dcellucci/MiniMOJO/README.md

# MiniMOJO

Documentation, hardware, and software related to MiniMOJO, a robot capable of traversing a digital cellular solids lattice.
