dcellucci/MiniMOJO/hw/README

# Hardware Notes

## MOJO Boards Rev 3

That's the one with the battery backpack.

### TeuxDeux

 1. Add solder jumper to disconnect power for I2C cable
 2. Move backpack switch to somewhere reachable
 	2a. backpack switch should turn IC on/off, IC should turn motors on/off
 3. Move servo connector up

### Notes

Pinout for ATSAM

    6 Pin | 10 Pin SAM 

    1 > 2
    2 > 1
    3 > 4
    4 > DNC 
    5 > 0
    6 > 5
