dcellucci/MiniMOJO/hw/PCB/EAGLE/MiniMojo_Control_Boards/TPS61089RNRR_4.8V/Eagle/2016-09-01_11-38-00/readme.txt

**********************************************************
*************  Important Instructions Follow  ************
**********************************************************

All files exported to: Z:\\38\\87\\3887045\\20\Eagle\2016-09-01_11-38-00\2016-09-01_11-38-00.xml

**********************************************************
*****************Schematic Instructions  *******************
**********************************************************

To import your new Schematic file into Eagle:

1. Unzip the downloaded folder files to local directory and Start Eagle.
2. Select "File"->"Open"->"Schematic..." from the menu at the top of
the screen.
3. Browse to your newly exported file and select the ".sch" file extension.
4. You should now see your schamtic available in Eagle.

**********************************************************
*******************  PCB Instructions  *******************
**********************************************************

To import your new BOARD file into Eagle:

1. Unzip the downloaded folder files to local directory and Start Eagle.
2. Select "File"->"Open"->"Board..." from the menu at the top of
the screen.
3. Browse to your newly exported file and select the ".brd" file extension.
4. Planes will need to be repoured to update the polygon fills
	1. Once your board is loaded and before the repour, the default design rule
	   should be updated for Mask and thermal relief.
		a. Goto Edit and select Design Rules.
			-Select Masks Tab; Set Stop (Min & Max) to 0.0mm
			-Select Supply Tab; Set Thermal Isolation to 0.0mm
	2. To pour the polygon fills, goto Tools and select Ratsnest
	3. The polygons should all be filled now.
5. You should now have an image of your board available in Eagle.

**********************************************************
*******************  LIB Instructions  *******************
**********************************************************

To import your new library into Eagle:

1. Start Eagle.
2. Select "File"->"New"->"Library" from the menu.
3. In the blank library window, select "File" -> "Execute Script"
from the menu.
5. Browse to your newly exported Eagle Script file (".scr" file extension)
6. After opening the file, the script will populate the new library.
Layer 93 should NOT exist.
7. Use "File"->"Save" (or "Save As..") to save the library to the desired
location in Eagle native format.

For additional information, please visit this site:
http://www.accelerated-designs.com/help/Eagle_import.html

You may also find this video helpful:
http://youtu.be/5jGuWY-Yy3Q

**********************************************************
**********************************************************
**********************************************************

Component "GRM155R61A104KA01D" renamed to "GRM155R61A104KA01D"
Component "CL21C122JBFNNWE" renamed to "CL21C122JBFNNWE"
Component "CL21C620JBANNNC" renamed to "CL21C620JBANNNC"
Component "GRM155R60J104KA01D" renamed to "GRM155R60J104KA01D"
Component "WB_CURRENT_LOAD" renamed to "WB_CURRENT_LOAD"
Component "GRM188R61A225KE34D" renamed to "GRM188R61A225KE34D"
Component "WB_GND" renamed to "WB_GND"
Component "IHLP2020CZERR82M01" renamed to "IHLP2020CZERR82M01"
Component "CRCW040222K6FKED" renamed to "CRCW040222K6FKED"
Component "RC0603FR-0782KL" renamed to "RC0603FR-0782KL"
Component "CRCW0402243KFKED" renamed to "CRCW0402243KFKED"
Component "ERJ-8ENF1433V" renamed to "ERJ-8ENF1433V"
Component "ERJ-8ENF5233V" renamed to "ERJ-8ENF5233V"
Component "TPS61089RNRR" renamed to "TPS61089RNRR"
Component "WB_BATTERY" renamed to "WB_BATTERY"
Component "GRM31CR61A476KE15L" renamed to "GRM31CR61A476KE15L"
The Symbol WB_CONTINUATION was missing a RefDes attribute, a refdes was created for the symbol.
The Symbol WB_CONTINUATION was missing a Type attribute, a type was created for the symbol.
The Symbol WB_CONTINUATION was missing a Value attribute, a value was created for the symbol.
The Symbol WB_CURRENT_PROBE was missing a RefDes attribute, a refdes was created for the symbol.
The Symbol WB_CURRENT_PROBE was missing a Type attribute, a type was created for the symbol.
The Symbol WB_CURRENT_PROBE was missing a Value attribute, a value was created for the symbol.
The Symbol WB_PWL_CURRENT_LOAD was missing a RefDes attribute, a refdes was created for the symbol.
The Symbol WB_PWL_CURRENT_LOAD was missing a Type attribute, a type was created for the symbol.
The Symbol WB_PWL_CURRENT_LOAD was missing a Value attribute, a value was created for the symbol.
The Symbol WB_BLOCK_IO was missing a RefDes attribute, a refdes was created for the symbol.
The Symbol WB_BLOCK_IO was missing a Type attribute, a type was created for the symbol.
The Symbol WB_BLOCK_IO was missing a Value attribute, a value was created for the symbol.
The Symbol WB_CAP_OUTPUT was missing a RefDes attribute, a refdes was created for the symbol.
The Symbol WB_CAP_OUTPUT was missing a Type attribute, a type was created for the symbol.
The Symbol WB_CAP_OUTPUT was missing a Value attribute, a value was created for the symbol.
The Symbol WB_PWL_VOLTAGE_SOURCE was missing a RefDes attribute, a refdes was created for the symbol.
The Symbol WB_PWL_VOLTAGE_SOURCE was missing a Type attribute, a type was created for the symbol.
The Symbol WB_PWL_VOLTAGE_SOURCE was missing a Value attribute, a value was created for the symbol.
The Symbol WB_SOURCE_RESISTOR was missing a RefDes attribute, a refdes was created for the symbol.
The Symbol WB_SOURCE_RESISTOR was missing a Type attribute, a type was created for the symbol.
The Symbol WB_SOURCE_RESISTOR was missing a Value attribute, a value was created for the symbol.
The Symbol WB_PRIM_PWL_VOLTAGE_SOURCE was missing a RefDes attribute, a refdes was created for the symbol.
The Symbol WB_PRIM_PWL_VOLTAGE_SOURCE was missing a Type attribute, a type was created for the symbol.
The Symbol WB_PRIM_PWL_VOLTAGE_SOURCE was missing a Value attribute, a value was created for the symbol.
The Symbol WB_PRIMITIVE_BATTERY was missing a RefDes attribute, a refdes was created for the symbol.
The Symbol WB_PRIMITIVE_BATTERY was missing a Type attribute, a type was created for the symbol.
The Symbol WB_PRIMITIVE_BATTERY was missing a Value attribute, a value was created for the symbol.
The Symbol WB_TPS61089RNR was missing a RefDes attribute, a refdes was created for the symbol.
The Symbol WB_TPS61089RNR was missing a Type attribute, a type was created for the symbol.
The Symbol WB_TPS61089RNR was missing a Value attribute, a value was created for the symbol.
The Symbol WB_VOLTAGE_PROBE was missing a RefDes attribute, a refdes was created for the symbol.
The Symbol WB_VOLTAGE_PROBE was missing a Type attribute, a type was created for the symbol.
The Symbol WB_VOLTAGE_PROBE was missing a Value attribute, a value was created for the symbol.
The Symbol WB_CINX_TPS61088 was missing a RefDes attribute, a refdes was created for the symbol.
The Symbol WB_CINX_TPS61088 was missing a Type attribute, a type was created for the symbol.
The Symbol WB_CINX_TPS61088 was missing a Value attribute, a value was created for the symbol.
The Symbol WB_CAP_POLARIZED was missing a RefDes attribute, a refdes was created for the symbol.
The Symbol WB_CAP_POLARIZED was missing a Type attribute, a type was created for the symbol.
The Symbol WB_CAP_POLARIZED was missing a Value attribute, a value was created for the symbol.
The Symbol WB_COUTX_BLOCK was missing a RefDes attribute, a refdes was created for the symbol.
The Symbol WB_COUTX_BLOCK was missing a Type attribute, a type was created for the symbol.
The Symbol WB_COUTX_BLOCK was missing a Value attribute, a value was created for the symbol.
The Symbol WB_PRIM_STARTUP_VOLTAGE_SOURCE was missing a RefDes attribute, a refdes was created for the symbol.
The Symbol WB_PRIM_STARTUP_VOLTAGE_SOURCE was missing a Type attribute, a type was created for the symbol.
The Symbol WB_PRIM_STARTUP_VOLTAGE_SOURCE was missing a Value attribute, a value was created for the symbol.
The Symbol WB_STARTUP_VOLTAGE_SOURCE was missing a RefDes attribute, a refdes was created for the symbol.
The Symbol WB_STARTUP_VOLTAGE_SOURCE was missing a Type attribute, a type was created for the symbol.
The Symbol WB_STARTUP_VOLTAGE_SOURCE was missing a Value attribute, a value was created for the symbol.
The Symbol WB_PRIM_SIN_VOLTAGE_SOURCE was missing a RefDes attribute, a refdes was created for the symbol.
The Symbol WB_PRIM_SIN_VOLTAGE_SOURCE was missing a Type attribute, a type was created for the symbol.
The Symbol WB_PRIM_SIN_VOLTAGE_SOURCE was missing a Value attribute, a value was created for the symbol.
The Symbol WB_LOAD_RESISTOR was missing a RefDes attribute, a refdes was created for the symbol.
The Symbol WB_LOAD_RESISTOR was missing a Type attribute, a type was created for the symbol.
The Symbol WB_LOAD_RESISTOR was missing a Value attribute, a value was created for the symbol.

Ultra Librarian Gold 8.1.44 Process Report

Message - Padstack "RX22Y24D0T" Shape(4) is a CIRCLE with no diameter.
Message - Padstack "RX44Y57D0T" Shape(4) is a CIRCLE with no diameter.
Message - Padstack "RX44Y71D0T" Shape(4) is a CIRCLE with no diameter.
Message - Padstack "RX26Y38D0T" Shape(4) is a CIRCLE with no diameter.
Message - Padstack "RX78Y110D0T" Shape(4) is a CIRCLE with no diameter.
Message - Padstack "R10220100000200A" Shape(4) is a CIRCLE with no diameter.
Message - Padstack "R10430180000221A" Shape(4) is a CIRCLE with no diameter.
Message - Padstack "R10430430002121A" Shape(4) is a CIRCLE with no diameter.
Message - Component "GRM155R61A104KA01D" attribute "Cap" references text style "" that is not in the database.
The default pattern text style "H50s3" was substituted.
Message - Component "GRM155R61A104KA01D" attribute "ESR" references text style "" that is not in the database.
The default pattern text style "H50s3" was substituted.
Message - Component "GRM155R61A104KA01D" attribute "IRMS" references text style "" that is not in the database.
The default pattern text style "H50s3" was substituted.
Message - Component "GRM155R61A104KA01D" attribute "VDC" references text style "" that is not in the database.
The default pattern text style "H50s3" was substituted.
Message - Component "CL21C122JBFNNWE" attribute "Datasheet URL" references text style "" that is not in the database.
The default pattern text style "H50s3" was substituted.
Message - Component "CL21C122JBFNNWE" attribute "Cap" references text style "" that is not in the database.
The default pattern text style "H50s3" was substituted.
Message - Component "CL21C122JBFNNWE" attribute "ESR" references text style "" that is not in the database.
The default pattern text style "H50s3" was substituted.
Message - Component "CL21C122JBFNNWE" attribute "IRMS" references text style "" that is not in the database.
The default pattern text style "H50s3" was substituted.
Message - Component "CL21C122JBFNNWE" attribute "VDC" references text style "" that is not in the database.
The default pattern text style "H50s3" was substituted.
Message - Component "CL21C620JBANNNC" attribute "Datasheet URL" references text style "" that is not in the database.
The default pattern text style "H50s3" was substituted.
Message - Component "CL21C620JBANNNC" attribute "Cap" references text style "" that is not in the database.
The default pattern text style "H50s3" was substituted.
Message - Component "CL21C620JBANNNC" attribute "ESR" references text style "" that is not in the database.
The default pattern text style "H50s3" was substituted.
Message - Component "CL21C620JBANNNC" attribute "IRMS" references text style "" that is not in the database.
The default pattern text style "H50s3" was substituted.
Message - Component "CL21C620JBANNNC" attribute "VDC" references text style "" that is not in the database.
The default pattern text style "H50s3" was substituted.
Message - Component "GRM155R60J104KA01D" attribute "Cap" references text style "" that is not in the database.
The default pattern text style "H50s3" was substituted.
Message - Component "GRM155R60J104KA01D" attribute "ESR" references text style "" that is not in the database.
The default pattern text style "H50s3" was substituted.
Message - Component "GRM155R60J104KA01D" attribute "IRMS" references text style "" that is not in the database.
The default pattern text style "H50s3" was substituted.
Message - Component "GRM155R60J104KA01D" attribute "VDC" references text style "" that is not in the database.
The default pattern text style "H50s3" was substituted.
Message - Component "GRM188R61A225KE34D" attribute "Cap" references text style "" that is not in the database.
The default pattern text style "H50s3" was substituted.
Message - Component "GRM188R61A225KE34D" attribute "ESR" references text style "" that is not in the database.
The default pattern text style "H50s3" was substituted.
Message - Component "GRM188R61A225KE34D" attribute "IRMS" references text style "" that is not in the database.
The default pattern text style "H50s3" was substituted.
Message - Component "GRM188R61A225KE34D" attribute "VDC" references text style "" that is not in the database.
The default pattern text style "H50s3" was substituted.
Message - Component "IHLP2020CZERR82M01" attribute "Datasheet URL" references text style "" that is not in the database.
The default pattern text style "H50s3" was substituted.
Message - Component "IHLP2020CZERR82M01" attribute "L" references text style "" that is not in the database.
The default pattern text style "H50s3" was substituted.
Message - Component "IHLP2020CZERR82M01" attribute "DCR" references text style "" that is not in the database.
The default pattern text style "H50s3" was substituted.
Message - Component "IHLP2020CZERR82M01" attribute "IDC" references text style "" that is not in the database.
The default pattern text style "H50s3" was substituted.
Message - Component "CRCW040222K6FKED" attribute "Resistance" references text style "" that is not in the database.
The default pattern text style "H50s3" was substituted.
Message - Component "CRCW040222K6FKED" attribute "Power" references text style "" that is not in the database.
The default pattern text style "H50s3" was substituted.
Message - Component "CRCW040222K6FKED" attribute "Tolerance" references text style "" that is not in the database.
The default pattern text style "H50s3" was substituted.
Message - Component "RC0603FR-0782KL" attribute "Resistance" references text style "" that is not in the database.
The default pattern text style "H50s3" was substituted.
Message - Component "RC0603FR-0782KL" attribute "Power" references text style "" that is not in the database.
The default pattern text style "H50s3" was substituted.
Message - Component "RC0603FR-0782KL" attribute "Tolerance" references text style "" that is not in the database.
The default pattern text style "H50s3" was substituted.
Message - Component "CRCW0402243KFKED" attribute "Resistance" references text style "" that is not in the database.
The default pattern text style "H50s3" was substituted.
Message - Component "CRCW0402243KFKED" attribute "Power" references text style "" that is not in the database.
The default pattern text style "H50s3" was substituted.
Message - Component "CRCW0402243KFKED" attribute "Tolerance" references text style "" that is not in the database.
The default pattern text style "H50s3" was substituted.
Message - Component "ERJ-8ENF1433V" attribute "Resistance" references text style "" that is not in the database.
The default pattern text style "H50s3" was substituted.
Message - Component "ERJ-8ENF1433V" attribute "Power" references text style "" that is not in the database.
The default pattern text style "H50s3" was substituted.
Message - Component "ERJ-8ENF1433V" attribute "Tolerance" references text style "" that is not in the database.
The default pattern text style "H50s3" was substituted.
Message - Component "ERJ-8ENF5233V" attribute "Resistance" references text style "" that is not in the database.
The default pattern text style "H50s3" was substituted.
Message - Component "ERJ-8ENF5233V" attribute "Power" references text style "" that is not in the database.
The default pattern text style "H50s3" was substituted.
Message - Component "ERJ-8ENF5233V" attribute "Tolerance" references text style "" that is not in the database.
The default pattern text style "H50s3" was substituted.
Message - Component "GRM31CR61A476KE15L" attribute "Cap" references text style "" that is not in the database.
The default pattern text style "H50s3" was substituted.
Message - Component "GRM31CR61A476KE15L" attribute "ESR" references text style "" that is not in the database.
The default pattern text style "H50s3" was substituted.
Message - Component "GRM31CR61A476KE15L" attribute "IRMS" references text style "" that is not in the database.
The default pattern text style "H50s3" was substituted.
Message - Component "GRM31CR61A476KE15L" attribute "VDC" references text style "" that is not in the database.
The default pattern text style "H50s3" was substituted.

TextStyle count:  24
Padstack count:   8
Pattern count:    7
Symbol count:     25
Component count:  16

Export

Footprint "WB_CURRENT_LOAD" has no layer data mapped and will be skipped.
Component "WB_CURRENT_LOAD" requires footprint "WB_CURRENT_LOAD" and will be skipped.
Footprint "WB_GND" has no layer data mapped and will be skipped.
Component "WB_GND" requires footprint "WB_GND" and will be skipped.
Footprint "WB_BATTERY" has no layer data mapped and will be skipped.
Component "WB_BATTERY" requires footprint "WB_BATTERY" and will be skipped.
