dcellucci/MiniMOJO/hw/PCB/EAGLE/Prototyping/Tiny841/20160903_MODELA/tiny841_breakout_cutout.png

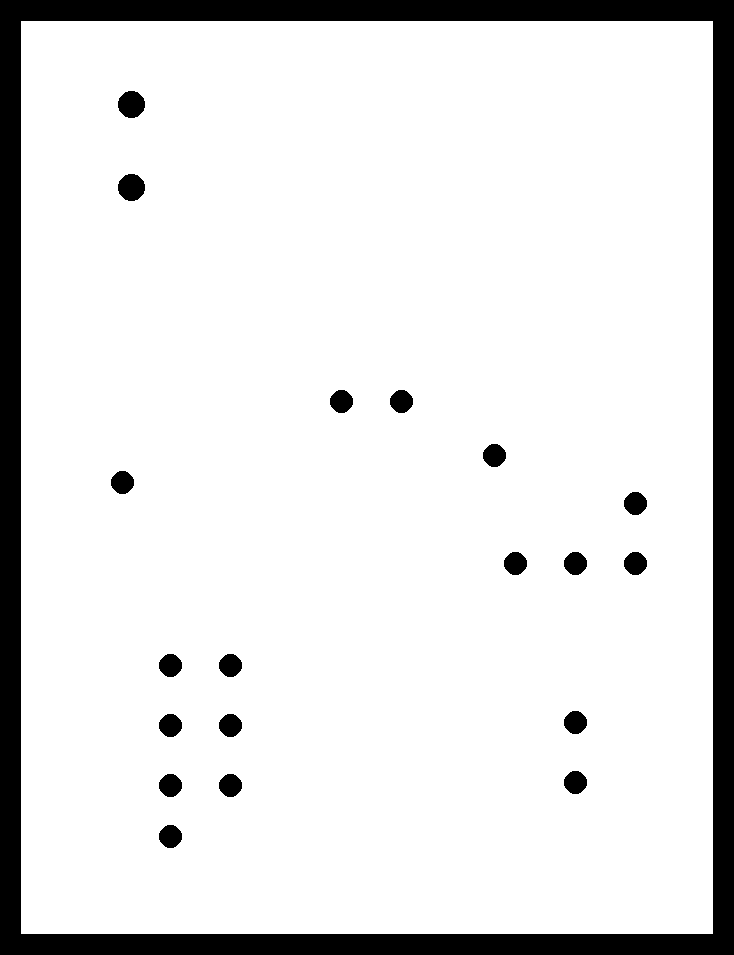
hw/PCB/EAGLE/Prototyping/Tiny841/20160903_MODELA/tiny841_breakout_cutout.png
