dcellucci/MiniMOJO/hw/PCB/EAGLE/Prototyping/Tiny841/20160903_MODELA/Tiny841_Breakout_fab.png

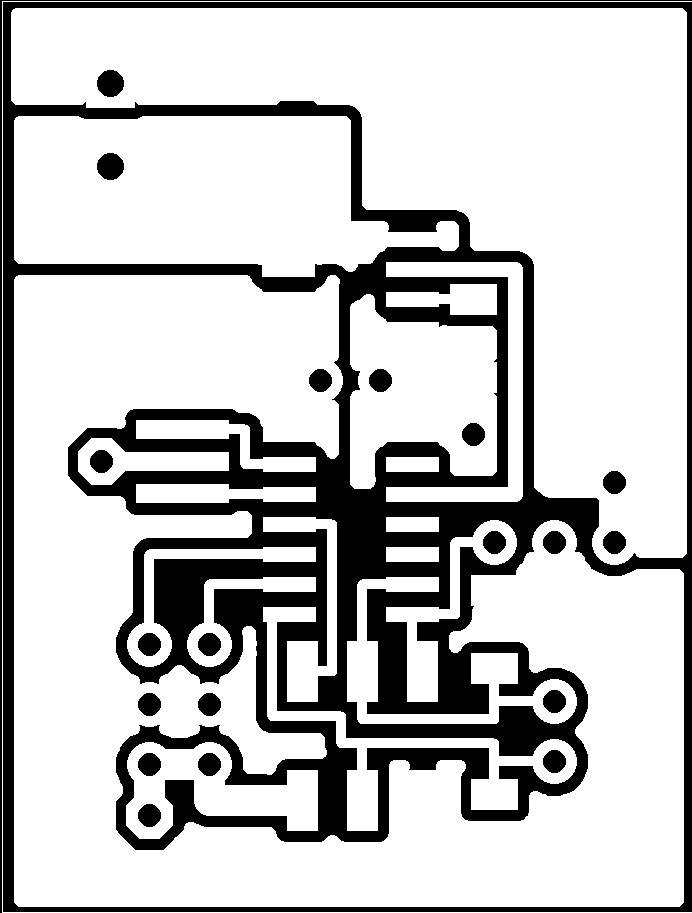
hw/PCB/EAGLE/Prototyping/Tiny841/20160903_MODELA/Tiny841_Breakout_fab.png
