dcellucci/MiniMOJO/hw/PCB/EAGLE/Prototyping/Tiny841/20160903_MODELA/tiny841_breakout_traces.png

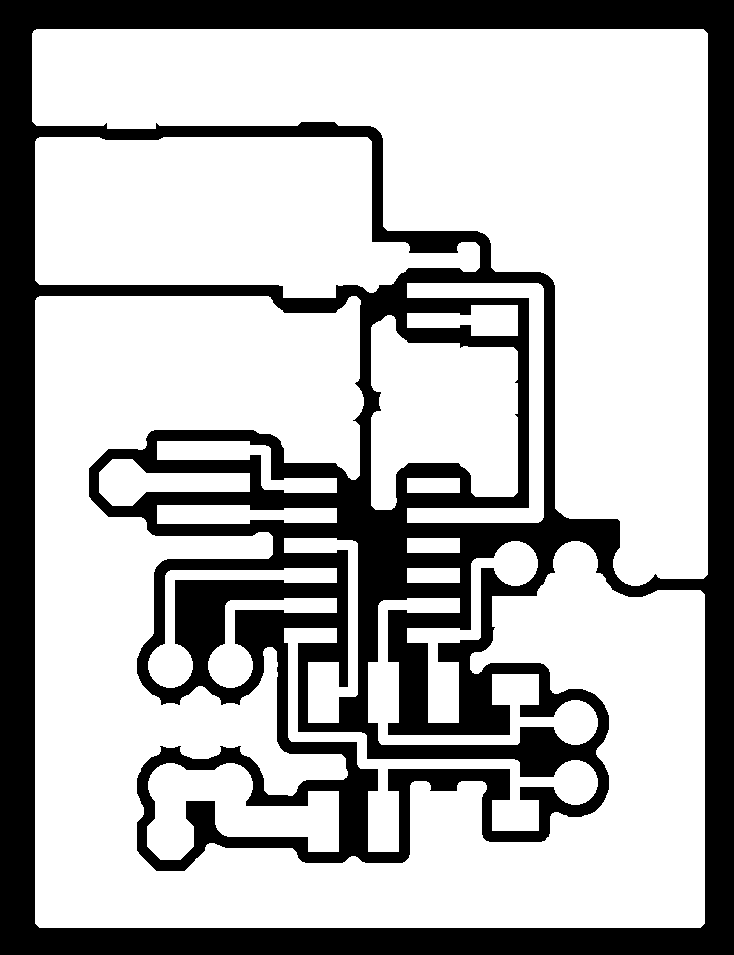
hw/PCB/EAGLE/Prototyping/Tiny841/20160903_MODELA/tiny841_breakout_traces.png
