dcellucci/MiniMOJO/hw/PCB/KICAD/D11D_Programmer_Adapter/CAM/D11D_Adapter_Base_cutout.png

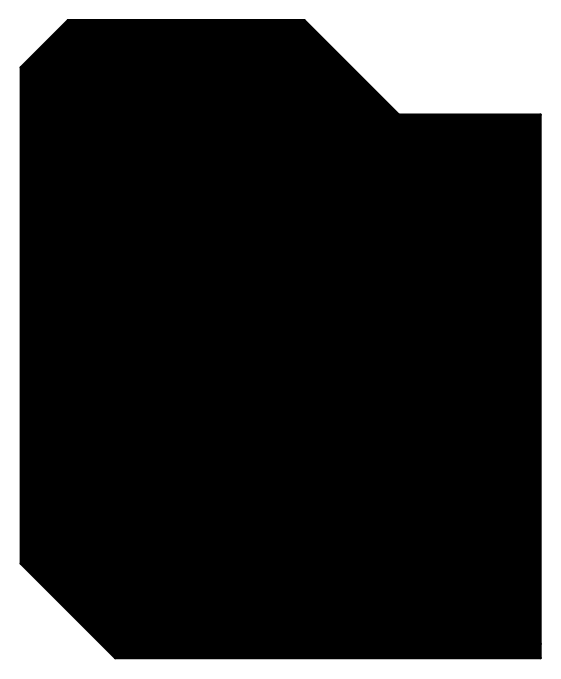
hw/PCB/KICAD/D11D_Programmer_Adapter/CAM/D11D_Adapter_Base_cutout.png
