dcellucci/MiniMOJO/hw/PCB/KICAD/R21_Core_2/R21_Core_BOM.xlsx

Reference Designator | Quantity | Description/Value | Manufacturer Part Number (MPN)
A1 | 1 | 2.4GHz Bluetooth, WLAN, Zigbee™ Chip RF Antenna 2.4GHz ~ 2.483GHz 2.2dBi Solder Surface Mount | W3008C
AR1 | 1 | RES ARRAY 8 RES 10K OHM 1206 | EXB-D10C103J
B1 | 1 | Balun AT86RF232 AT86RF233 ATMEGA256 | 2450BM15A0015E
C1,C2 | 2 | 9pF 50V Ceramic Capacitor C0G, NP0 0402 | GRM1555C1H9R0BA01D
C3,C42 | 2 | 1µF 6.3V Ceramic Capacitor X7R 0402 | GRM155R70J105KA12D
C4,C43 | 2 | 2.2µF 6.3V Ceramic Capacitor X5R 0402 | GRM155R60J225ME15D
C5,C6 | 2 | 22pF 50V Ceramic Capacitor C0G, NP0 0402 | C1005C0G1H220F050BA
C8,C11,C12,C13,C14,C15,C16,C20,C24,C25,C29,C30,C33,C37,C38 | 15 | 0.10µF 16V Ceramic Capacitor X7R 0402 | GRM155R71C104KA88J
C9 | 1 | CAP CER 1200PF 50V NP0 0805 | CL21C122JBFNNWE
C10,C17 | 2 | CAP CER 10UF 10V X5R 0402 | CL05A106MP5NUNC
C18 | 1 | CAP CER 62PF 50V NP0 0805 | CL21C620JBANNNC
C19,C22 | 2 | CAP CER 47UF 10V X5R 1206 | GRT31CR61A476KE13L
C21 | 1 | CAP CER 2.2UF 10V X5R 0603 | GRM188R61A225KE34D
C23 | 1 | CAP CER 10000PF 50V X7R 0402 | GRM155R71H103KA88D
C26,C27,C40 | 3 | 4 Position FFC, FPC Connector Contacts, Top and Bottom 0.020" (0.50mm) Surface Mount, Right Angle | 5034800400
C28,C41 | 2 | CONN FFC FPC 10POS 0.50MM R/A | 5034801000
C31 | 1 | 9 Positions Header, Shrouded Connector 0.039" (1.00mm) Surface Mount, Right Angle Tin | SM09B-SRSS-TB(LF)(SN)
C32,C39 | 2 | CAP CER 4.7UF 10V X5R 0402 | CL05A475KP5NRNC
C34,C35 | 2 | 22pF 50V Ceramic Capacitor C0G, NP0 0402 | C1005C0G1H220F050BA
D1,D3 | 2 | Amber 615nm LED Indication - Discrete 2V 0603 | LA L296-Q2R2-1-Z
D2,D5 | 2 | Blue 470nm LED Indication - Discrete 3.3V 0603 | LTST-C191TBKT
F1,F2 | 2 | FUSE PTC RESET 200MA SMD 0603 | MF-FSMF020X-2
L1 | 1 | 220 Ohm Impedance Ferrite Bead 0603 (1608 Metric) Surface Mount 2A 1 Lines 50 mOhm Max DCR | BLM18EG221SN1D
L2 | 1 | 1.2 uH Power inductor | 74438356012
Q1 | 1 | MOSFET N-CH 60V 0.31A SOT323 | 2N7002PW,115
R1,R2,R3,R9,R12,R18 | 6 | RES SMD 330 OHM 1% 1/16W 0402 | RC0402FR-07330RL
R4 | 1 | RES SMD 143K OHM 1% 1/4W 1206 | ERJ-8ENF1433V
R5 | 1 | RES SMD 22.6K OHM 1% 1/16W 0402 | CRCW040222K6FKED
R6 | 1 | RES SMD 243K OHM 1% 1/16W 0402 | CRCW0402243KFKED
R7 | 1 | RES SMD 82K OHM 1% 1/10W 0603 | RC0603FR-0782KL
R8,R11,R17,R21,R22,R23 | 6 | RES SMD 10K OHM 1% 1/16W 0402 | CRCW040210K0FKED
R10 | 1 | RES SMD 523K OHM 1% 1/4W 1206 | ERJ-8ENF5233V
R13 | 1 | RES SMD 78.7K OHM 1% 1/10W 0402 | ERJ-2RKF7872X
R14,R15,R16 | 3 | RES SMD 0.25 OHM 1% 1/2W 1206 | CSR1206FKR250
R19 | 1 | RES SMD 10 OHM 1% 1/16W 0402 | RC0402FR-0710RL
R20 | 1 | RES SMD 0.01 OHM 1% 1W 1206 | CRF1206-FZ-R010ELF
S2 | 1 | SWITCH TACTILE SPST-NO 0.02A 15V | TL3700AF160QG
SW1 | 1 | Slide Switch SPDT Surface Mount, Right Angle | AYZ0102AGRLC
T1 | 1 | IC REG BOOST ADJ 7A SYNC 11VQFN | TPS61089RNRR
J1 | 1 | 5x2 Header JTAG 0.05" | 20021121-00010C4LF
U1 | 1 | ATSAMR21E18A IC RF TXRX+MCU ISM>1GHZ 32-VFQFN | ATSAMR21E18A-MFT
U2,U11 | 2 | IC REG LDO 3.3V 0.6A SOT25 | AP2112K-3.3TRG1
U3 | 1 | IMU ACCEL/GYRO/MAG I2C/SPI 24LGA | LSM9DS1TR
U4 | 1 | IC DISTRIBUTION SWITCH 10VSON | TPS2559QWDRCTQ1
U5 | 1 | IC CURRENT SHUNT MONITOR 16VQFN | INA3221AQRGVRQ1
U6 | 1 | IC MCU 32BIT 16KB FLASH 24QFN | ATSAMD11D14A-MNT
U7 | 1 | CONN PLUG 20POS 3MM STACK HGHT | 20P3.0-JMCS-G-TF(N)
U8 | 1 | CONN RCPT 20POS GOLD W/BOSS | 20R-JMCS-G-B-TF(S)
U9 | 1 | IC BATTERY MONITOR 14TDFN | MAX17201G+
U10 | 1 | USB - micro B USB 2.0 Receptacle Connector 5 Position Surface Mount, Right Angle, Horizontal | 10104110-0001LF
X1 | 1 | CRYSTAL 16.0000MHZ 10PF SMD | ABM8-16.000MHZ-10-1-U-T
X2 | 1 | CRYSTAL 32.7680KHZ 12.5PF SMT | FC-135R 32.7680KF-A3
 | 93
