dcellucci/MiniMOJO/hw/PCB/EAGLE/MiniMojo_Control_Boards/ATSAMR18_core/20160731_MM2_BOM.xls

Sample Bill of Materials (BOM) - Screaming Circuits Buys Materials
> All the information Screaming Circuits needs in a Bill of Materials to complete an order is in columns B through G.
> Distributor part numbers (ie.. DigiKey Part #'s) are not required for Kitted orders, but are helpful for Turn-Key pricing.
> The BOM is the primary file that Screaming Circuits goes by whenever there is any conflicting information.
> There is information in the far right column that helps to get an assembly quote. Look at the bottom to see a board summary.
> Highlight in RED any Do Not Stuff parts ("DNS") , and they will be excluded from the build. Parts not listed on the BOM are considered DNS.
Item # | Qty | Ref Des | Manufacturer | Mfg Part # | Dist. Part # | Description | Package | Type
1 | 2 | C1, C2 | Murata | GRM1555C1H9R0BA01D | 490-6257-1-ND | 9pF 50V Ceramic Capacitor C0G, NP0 0402 | 402 | smt
2 | 1 | C3 | Murata | GRM155R70J105KA12D | 490-10024-1-ND | 1µF 6.3V Ceramic Capacitor X7R 0402 | 402 | smt
3 | 1 | C4 | Murata | GRM155R60J225ME15D | 490-4519-1-ND | 2.2µF 6.3V Ceramic Capacitor X5R 0402 | 402 | smt
4 | 2 | C5,C6 | TDK | C1005C0G1H220F050BA | 445-5360-1-ND | 22pF 50V Ceramic Capacitor C0G, NP0 0402 | 402 | smt
5 | 11 | C8,C9,C11,C12,C13,C14,C15,C16,C23,C25,C31 | Murata | GRM155R71C104KA88J | 490-6328-1-ND | 0.10µF 16V Ceramic Capacitor X7R 0402 | 402 | smt
6 | 2 | C10,C17 | TDK | C1005X5R0J106M050BC | 445-8920-1-ND | 10µF 6.3V Ceramic Capacitor X5R 0402 | 402 | smt
7 | 2 | C18,C26 | Murata | GRM31CR61A226KE19L | 490-6510-1-ND | 22µF 10V Ceramic Capacitor X5R 1206 | 1206 | smt
8 | 2 | C19,C27 | Murata | GRM155R60J222KA01D | 490-11413-1-ND | 2200pF 6.3V Ceramic Capacitor X5R 0402 | 402 | smt
9 | 2 | C20,C28 | Kemet | C0402C122J5GACTU | 399-7334-1-ND | 1200pF 50V Ceramic Capacitor C0G, NP0 0402 | 402 | smt
10 | 2 | C21,C29 | Murata | GRM155R61A683KA01D | 490-1317-1-ND | 0.068µF 10V Ceramic Capacitor X5R 0402 | 402 | smt
11 | 2 | C22,C30 | Murata | GRM31CR60J107ME39L | 490-4539-1-ND | 100µF 6.3V Ceramic Capacitor X5R 1206 | 402 | smt
12 | 2 | C24,C32 | Murata | GRM155R71H102KA01D | 490-1303-1-ND | CAP CER 1000PF 50V X7R 0402 | 402 | smt
13 | 1 | D5 | Lite-On | LTST-C191TBKT | 160-1647-1-ND | Blue 470nm LED Indication - Discrete 3.3V 0603 | 603 | smt
14 | 1 | D1 | Osram | LA L296-Q2R2-1-Z | 475-2712-1-ND | Amber 615nm LED Indication - Discrete 2V 0603 | 603 | smt
15 | 2 | D2,D3 | Diodes inc | 1N4448W-7-F | 1N4448W-FDICT-ND | DIODE GEN PURP 75V 250MA SOD123 | SOD-123 | smt
16 | 1 | F1 | Bourns | MF-FSMF020X-2 | MF-FSMF020X-2CT-ND | FUSE PTC RESET 200MA SMD 0603 | 603 | smt
17 | 1 | Q1 | NXP | 2N7002PW,115 | 568-5987-1-ND | MOSFET N-CH 60V 0.31A SOT323 | sot323 | smt
18 | 1 | R1 | Panasonic | ERJ-2RKF75R0X | P75.0LCT-ND | RES SMD 75 OHM 1% 1/10W 0402 | 402 | smt
19 | 5 | R2, R6, R9, R13, R16 | Vishay-Dale | CRCW040210K0FKED | 541-10.0KLCT-ND | RES SMD 10K OHM 1% 1/16W 0402 | 402 | smt
20 | 1 | R3 | Yageo | RC0402FR-07330RL | 311-330LRCT-ND | RES SMD 330 OHM 1% 1/16W 0402 | 402 | smt
21 | 2 | R4,R10 | Vishay-Dale | CRCW040260K4FKED | 541-60.4KLCT-ND | RES SMD 60.4K OHM 1% 1/16W 0402 | 402 | smt
22 | 2 | R5,R11 | Vishay-Dale | CRCW04021K69FKED | 541-1.69KLCT-ND | RES SMD 1.69K OHM 1% 1/16W 0402 | 402 | smt
23 | 2 | R7,R14 | Vishay-Dale | CRCW040230K9FKED | 541-30.9KLCT-ND | RES SMD 30.9K OHM 1% 1/16W 0402 | 402 | smt
24 | 2 | R8,R15 | Vishay-Dale | CRCW04022K00FKED | 541-2.00KLCT-ND | RES SMD 2K OHM 1% 1/16W 0402 | 402 | smt
25 | 1 | R12 | Vishay-Dale | CRCW040210R0FKED | 541-10.0LCT-ND | RES SMD 10 OHM 1% 1/16W 0402 | 402 | smt
26 | 1 | S2 | C&K Components | KMR231NG LFS | CKN10246CT-ND | Tactile Switch SPST-NO Top Actuated Surface Mount | 4.2x2.8mm | smt
27 | 1 | U1 | Atmel | ATSAMR21E18A-MFT | ATSAMR21E18A-MFTCT-ND | IC RF TxRx + MCU General ISM > 1GHZ 2.4GHz 32-VFQFN Exposed Pad | 32-VFQFN | smt
28 | 1 | U2 | Johanson | 2450BM15A0015E | 712-1576-1-ND | AT86RF232 AT86RF233 ATMEGA256 | 805 | smt
29 | 1 | U3 | Pulse | W3008C | 553-1674-1-ND | 2.4GHz Bluetooth, WLAN, Zigbee™ Chip RF Antenna 2.4GHz ~ 2.483GHz 2.2dBi Solder Surface Mount | - | smt
30 | 1 | U4 | Epson | TSX-3225 16.0000MF09Z-AC0 | SER4069CT-ND | 16MHz ±10ppm Crystal 9pF 60 Ohm -20°C ~ 75°C | 4-smd | smt
31 | 2 | U6,U11 | TI | TPS55330RTER | 296-39425-1-ND | IC REG MULT CONFG ISO ADJ 16WQFN | 16WQFN | smt
32 | 2 | U7,U12 | Bourns | SRP4020-2R2M | SRP4020-2R2MCT-ND | FIXED IND 2.2UH 3.9A 40 MOHM SMD | - | smt
33 | 2 | U8,U13 | Diodes inc | B340A-13-F | B340A-FDICT-ND | DIODE SCHOTTKY 40V 3A SMA | DO-214AC | smt
34 | 2 | U9,U14 | Allegro | ACS712ELCTR-05B-T | 620-1189-1-ND | SENSOR CURRENT HALL 5A AC/DC | 8-soic | smt
 |  |  |  |  |  | BOARD SUMMARY FOR QUOTE
 |  |  |  |  |  | Unique Part Count | 34
 |  |  |  |  |  | Total Placements | 66
 |  |  |  |  |  | Thru Hole Placements | 0
 |  |  |  |  |  | Has BGA Placements? | No
