dcellucci/MiniMOJO/hw/PCB/EAGLE/MiniMojo_Control_Boards/ATMEGA328_core/20160811_MM2_plates_BOM2.xlsx

Reference Designator | Quantity | Description/Value | Manufacturer Part Number (MPN)
C5, C6, C8 | 3 | 0.1 uF 0402 Cap | 490-1318-1-ND
C7 | 1 | 1 nF 0402 Cap | GRM155R61A102KA01D
C13 | 1 | 1 pF 0402 Cap | GJM1555C1H1R0BB01D
C12 | 1 | 1.5 pF 0402 Cap | GJM1555C1H1R5BB01D
C10 | 1 | 2.2 nF Cap | 04025C222KAT2A
C11 | 1 | 4.7 pF 0402 cap | GRM1555C1H4R7CA01D
C2 | 1 | 10 nF 0402 Cap | GRM155R71H103KA88D
C1, C3, C4 | 3 | 10 uF 0402 cap | CL05A106MP5NUNC
C14 | 1 |  | GRM155R71H332KA01D
Y2 | 1 | 16 MHz crystal | ABM3B-16.000MHZ-10-1-U-T
C15, C16 | 2 | 18 pF 0402 caps | GRM1555C1H180FA01D
D1 | 1 | RED LED | HSMC-C280
D5 | 1 |  | VAOL-S4SB4
L1 | 1 | Inductor 8.2 nH | L-07C8N2JV6T
L3 | 1 | IND 2.7 nH | LQP15MN2N7W02D
L2 | 1 | IND 3.9 nH | LQP15MN3N9W02D
R1, R2 | 2 |  | CRCW040210K0FKED
R12 | 1 |  | RC0402FR-07330RL
R3 | 1 |  | RC0402FR-071ML
R10 | 1 |  | RC0402JR-0722KL
S2 | 1 |  | KMR231NG LFS
IC1 | 1 | nordic | NRF24L01P-R7
U3 | 1 | 328 | ATMEGA328-MMH
U5 | 1 | 5v reg | MIC5205-5.0YM5-TR
U4 | 1 | 3.3v reg | MIC5205-3.3YM5-TR
Y1 | 1 |  | CSTCE16M0V53C-R0
A1 | 1 |  | ANT-2.45-CHP-T
