dcellucci/MiniMOJO/hw/PCB/EAGLE/MiniMojo_Control_Boards/ATSAMR18_core/ATSAMR18_core_Rev2/TA_bom.xlsx

Reference Designator | Quantity | Description/Value | Manufacturer Part Number (MPN)
C1,C2 | 2 | 9pF 50V Ceramic Capacitor C0G, NP0 0402 | GRM1555C1H9R0BA01D
C3 | 1 | 1µF 6.3V Ceramic Capacitor X7R 0402 | GRM155R70J105KA12D
C4 | 1 | 2.2µF 6.3V Ceramic Capacitor X5R 0402 | GRM155R60J225ME15D
C5,C6 | 2 | 22pF 50V Ceramic Capacitor C0G, NP0 0402 | C1005C0G1H220F050BA
C8,C10,C11,C12,C13,C14,C15,C16,C17,C23 | 9 | 0.10µF 16V Ceramic Capacitor X7R 0402 | GRM155R71C104KA88J
C9 | 1 | 1.2 nF | CL21C122JBFNNWE
C18 | 1 | 62 pF | CL21C620JBANNNC
C19,C22 | 2 | 47 uF, 1206 | GRM31CR61A476KE15L
C20 | 1 | 100 nF | GRM155R60J104KA01D
C21 | 1 | 2.2 uF | GRM188R61A225KE34D
C25 | 1 | 100 nF | GRM155R61A104KA01D
D1,D2 | 1 | Amber 615nm LED Indication - Discrete 2V 0603 | LA L296-Q2R2-1-Z
D5 | 1 | Blue 470nm LED Indication - Discrete 3.3V 0603 | LTST-C191TBKT
F1 | 1 | FUSE PTC RESET 200MA SMD 0603 | MF-FSMF020X-2
F2,F3,F4 | 3 | PTC Resettable Fuse 6V 500mA Ih Surface Mount 0603 (1608 Metric), Concave | 0603L050SLYR
L1 | 1 | 220 Ohm Impedance Ferrite Bead 0603 (1608 Metric) Surface Mount 2A 1 Lines 50 mOhm Max DCR | BLM18EG221SN1D
L2 | 1 | 1.2 uH Power inductor | 74438356012
Q1 | 1 | MOSFET N-CH 60V 0.31A SOT323 | 2N7002PW,115
Q2,Q3 | 2 | MOSFET N-CH 50V 220MA SOT-23 | BSS138
Q4 | 1 | MOSFET P-CH 16V 4.66A 8-SOIC | PHK04P02T,518
R1, R3, R12,R20 | 3 | RES SMD 330 OHM 1% 1/16W 0402 | RC0402FR-07330RL
R4 | 1 | 143k, 1206 | ERJ-8ENF1433V
R5 | 1 | 22.6k, 0402 | CRCW040222K6FKED
R6 | 1 | 243k, 0402 | CRCW0402243KFKED
R7 | 1 | 82k, 0603 | RC0603FR-0782KL
R2,R8,R9,R11,R13,R14,R16,R17,R19 | 9 | RES SMD 10K OHM 1% 1/16W 0402 | CRCW040210K0FKED
R10 | 1 | 523k, 1206 | ERJ-8ENF5233V
R15 | 1 | RES SMD 0.01 OHM 1% 1/8W 0402 | CSRF0402FT10L0
S1 | 1 | Slide Switch SPDT Surface Mount, Right Angle | AYZ0102AGRLC
S2 | 1 | Tactile Switch SPST-NO Top Actuated Surface Mount | KMR231NG LFS
U1 | 1 | IC REG LDO 3.3V 0.6A SOT25 | AP2112K-3.3TRG1
U2 | 1 | IC RF TxRx + MCU General ISM > 1GHZ 2.4GHz 32-VFQFN Exposed Pad | ATSAMR21E18A-MFT
U5 | 1 | 2.4GHz Bluetooth, WLAN, Zigbee™ Chip RF Antenna 2.4GHz ~ 2.483GHz 2.2dBi Solder Surface Mount | W3008C
U6 | 1 | Balun AT86RF232 AT86RF233 ATMEGA256 | 2450BM15A0015E
U7 | 1 | 16MHz ±10ppm Crystal 9pF 60 Ohm -20°C ~ 75°C | TSX-3225 16.0000MF09Z-AC0
U8 | 1 | Regulator | TPS61089RNRR
U10 | 1 | ATTiny841 | ATTINY841-MUR
U11,U12,U13,U14,U16 | 5 | 4 Position FFC, FPC Connector Contacts, Top and Bottom 0.020" (0.50mm) Surface Mount, Right Angle | 5034800400
U17 | 1 | 9 Positions Header, Shrouded Connector 0.039" (1.00mm) Surface Mount, Right Angle Tin | SM09B-SRSS-TB(LF)(SN)
U18 | 1 | 20 Position Connector Receptacle, Center Strip Contacts Surface Mount Gold | 20R-JMCS-G-B-TF(S)
U19 | 1 | 20 Position Connector Plug, Outer Shroud Contacts Surface Mount Gold | 20P3.0-JMCS-G-TF(N)
U20 | 1 | Current Monitor Regulator High-Side 10mA SOT-23-8 | INA219BIDCNT
Y1 | 1 | 16 MHz crystal | ABM3B-16.000MHZ-10-1-U-T
J1 | 1 | USB - micro B USB 2.0 Receptacle Connector 5 Position Surface Mount, Right Angle, Horizontal | 10104110-0001LF
