dcellucci/MiniMOJO/hw/PCB/EAGLE/MiniMojo_Control_Boards/ATSAMR18_core/20160901_CAM/20160901_CAMFILES/MM_bom_SC.xls

Sample Bill of Materials (BOM) - Screaming Circuits Buys Materials
> All the information Screaming Circuits needs in a Bill of Materials to complete an order is in columns B through G.
> Distributor part numbers (ie.. DigiKey Part #'s) are not required for Kitted orders, but are helpful for Turn-Key pricing.
> The BOM is the primary file that Screaming Circuits goes by whenever there is any conflicting information.
> There is information in the far right column that helps to get an assembly quote. Look at the bottom to see a board summary.
> Highlight in RED any Do Not Stuff parts ("DNS") , and they will be excluded from the build. Parts not listed on the BOM are considered DNS.
Item # | Qty | Ref Des | Manufacturer | Mfg Part # | Dist. Part # | Description | Package | Type
1 | 2 | C1,C2 | Murata | GRM1555C1H9R0BA01D | 490-6257-1-ND | CAP CER 9PF 50V NP0 0402 | 402 | smt
2 | 1 | C3 | Murata | GRM155R70J105KA12D | 490-10024-1-ND | CAP CER 1UF 6.3V X7R 0402 | 402 | smt
3 | 1 | C4 | Murata | GRM155R60J225ME15D | 490-4519-1-ND | CAP CER 2.2UF 6.3V X5R 0402 | 402 | smt
4 | 2 | C5,C6 | TDK | C1005C0G1H220F050BA | 445-5360-1-ND | CAP CER 22PF 50V C0G 0402 | 402 | smt
5 | 11 | C8,C10,C11,C12,C13,C14,C15,C16,C17,C23,C25 | Murata | GRM155R71C104KA88J | 490-6328-1-ND | CAP CER 0.1UF 16V X7R 0402 | 402 | smt
6 | 1 | C9 | Samsung | CL21C122JBFNNWE | 1276-2987-1-ND | CAP CER 1200PF 50V NP0 0805 | 805 | smt
7 | 1 | C18 | Samsung | CL21C620JBANNNC | 1276-1305-1-ND | CAP CER 62PF 50V NP0 0805 | 805 | smt
8 | 2 | C19,C22 | Murata | GRM31CR61A476KE15L | 490-9673-1-ND | CAP CER 47UF 10V X5R 1206 | 1206 | SMT
9 | 1 | C20 | Murata | GRM155R60J104KA01D | 490-6287-1-ND | CAP CER 0.1UF 6.3V X5R 0402 | 402 | smt
10 | 1 | C21 | Murata | GRM188R61A225KE34D | 490-1545-1-ND | CAP CER 2.2UF 10V X5R 0603 | 603 | smt
11 | 1 | C24 | Murata | GRM155R71H102KA01D | 490-1303-1-ND | CAP CER 1000PF 50V X7R 0402 | 402 | smt
14 | 1 | D1 | OSRAM | LA L296-Q2R2-1-Z | 475-2712-1-ND | LED AMBER DIFFUSED 0603 SMD | 603 | smt
15 | 1 | D5 | Lite-On | LTST-C191TBKT | 160-1647-1-ND | LED BLUE CLEAR 0603 SMD | 603 | smt
16 | 1 | F1 | Bourns | MF-FSMF020X-2 | MF-FSMF020X-2CT-ND | FUSE PTC RESET 200MA SMD 0603 | 603 | smt
17 | 1 | L1 | Murata | BLM18EG221SN1D | 490-3992-1-ND | FERRITE BEAD 220 OHM 0603 1LN | 603 | smt
18 | 1 | L2 | Wurth | 74438356012 | 732-8229-1-ND | FIXED IND 1.2UH 5.8A 18 MOHM SMD | 2-smd | smt
19 | 1 | Q1 | NXP | 2N7002PW,115 | 568-5987-1-ND | MOSFET N-CH 60V 0.31A SOT323 | sot-323 | smt
20 | 2 | Q2,Q3 | Fairchild | BSS138 | BSS138CT-ND | MOSFET N-CH 50V 220MA SOT-23 | SOT-23 | smt
21 | 3 | R1, R3, R12 | Yageo | RC0402FR-07330RL | 311-330LRCT-ND | RES SMD 330 OHM 1% 1/16W 0402 | 402 | smt
22 | 1 | R4 | Panasonic | ERJ-8ENF1433V | ERJ-8ENF1433V | RES SMD 143K OHM 1% 1/4W 1206 | 1206 | smt
23 | 1 | R5 | Vishay Dale | CRCW040222K6FKED | 541-22.6KLCT-ND | RES SMD 22.6K OHM 1% 1/16W 0402 | 402 | smt
24 | 1 | R6 | Vishay Dale | CRCW0402243KFKED | 541-243KLCT-ND | RES SMD 243K OHM 1% 1/16W 0402 | 402 | smt
25 | 1 | R7 | Yageo | RC0603FR-0782KL | 311-82.0KHRCT-ND | RES SMD 82K OHM 1% 1/10W 0603 | 603 | smt
26 | 6 | R2,R8,R9,R11,R13,R14 | Vishay Dale | CRCW040210K0FKED | 541-10.0KLCT-ND | RES SMD 10K OHM 1% 1/16W 0402 | 402 | smt
27 | 1 | R10 | Panasonic | ERJ-8ENF5233V | P523KFCT-ND | RES SMD 523K OHM 1% 1/4W 1206 | 1206 | smt
28 | 1 | S2 | C&K | KMR231NG LFS | CKN10246CT-ND | SWITCH TACTILE SPST-NO 0.05A 32V |  | smt
29 | 1 | U1 | Diodes, Inc. | AP2112K-3.3TRG1 | AP2112K-3.3TRG1DICT-ND | IC REG LDO 3.3V 0.6A SOT25 | SOT-23-5 | smt
30 | 1 | U2 | Atmel | ATSAMR21E18A-MFT | ATSAMR21E18A-MFTCT-ND | C RF TXRX+MCU ISM>1GHZ 32-VFQFN | 32-VFQFN | smt
31 | 1 | U5 | Pulse | W3008C | 553-1674-1-ND | ANTENNA WIRELESS EXTERNAL 2.4GHZ |  | smt
32 | 1 | U6 | Johansen | 2450BM15A0015E | 712-1576-1-ND | AT86RF232 AT86RF233 ATMEGA256 | 6 PC pad | smt
33 | 1 | U7 | EPSON | TSX-3225 16.0000MF09Z-AC0 | SER4069CT-ND | CRYSTAL 16.00 MHZ 9PF SMD | 4-SMD | smt
34 | 1 | U8 | TI | TPS61089RNRR | 595-TPS61089RNRR | (MOUSER) Voltage Regulators - Switching Regulators 12.6-V, 7-A Fully-Integrated Synchronous Boost Converters in 2.0-mm x 2.5-mm VQFN Package 11-VQFN-HR -40 to 85 | 11-VQFN-HR | smt
35 | 1 | U10 | Atmel | ATTINY841-MUR | ATTINY841-MURCT-ND | IC MCU 8BIT 8KB FLASH 20QFN | 20-QFN | smt
36 | 1 | Y1 | Murata | ABM3B-16.000MHZ-10-1-U-T | 490-7852-1-ND | 16MHz Ceramic Resonator Built in Capacitor 15pF ±0.15% -40°C ~ 125°C Surface Mount | 3-SMD | smt
 |  |  |  |  |  | BOARD SUMMARY FOR QUOTE
 |  |  |  |  |  | Unique Part Count | 34
 |  |  |  |  |  | Total Placements | 66
 |  |  |  |  |  | Thru Hole Placements | 0
 |  |  |  |  |  | Has BGA Placements? | No
