dcellucci/MiniMOJO/hw/cad/Gloves/INJMOLD_GLOVE.stp

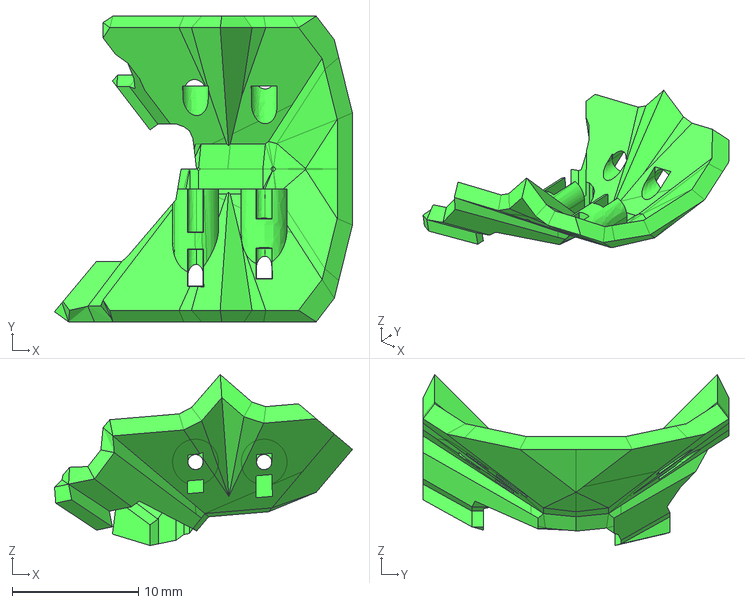
[picture p9: CAD file, 2017-02-16]
hw/cad/Gloves/INJMOLD_GLOVE.stp
23.6 x 24.2 x 13.5 mm
