dcellucci/MiniMOJO/hw/cad/Outer_Arms/Outer_Arms_Bearing.stp

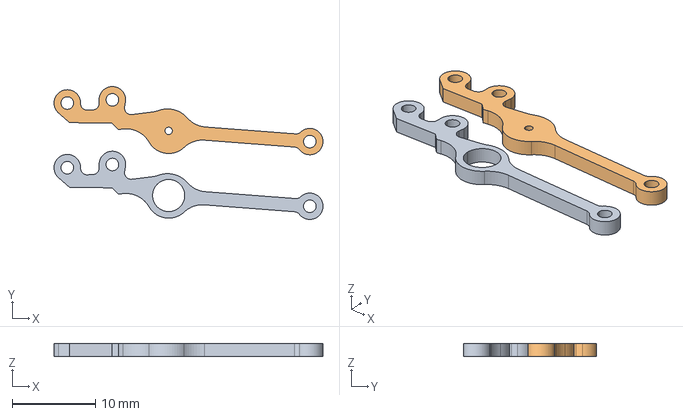
[picture p10: CAD file, 2017-02-16]
hw/cad/Outer_Arms/Outer_Arms_Bearing.stp
32.3 x 16.0 x 1.59 mm
