dcellucci/MiniMOJO/hw/cad/Gear_Patterns/gg_gear_14t_PA20.dxf

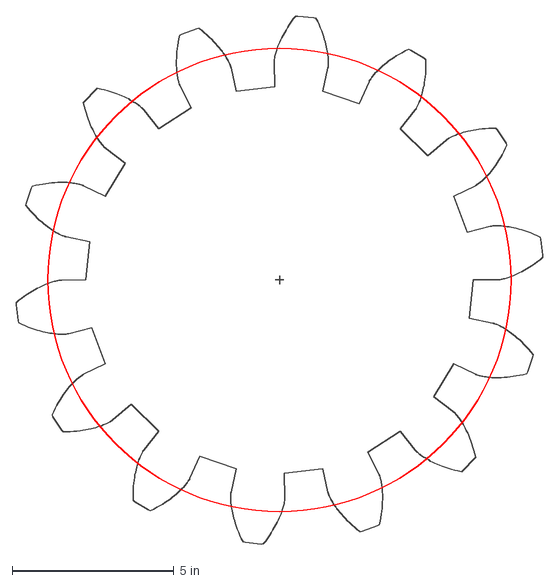
[picture p11: CAD file, 2016-09-23]
hw/cad/Gear_Patterns/gg_gear_14t_PA20.dxf
16.3 x 16.3 in
