dcellucci/MiniMOJO/hw/cad/Gear_Patterns/gg_gear N17 D10.28 P1.65 PA20 @100.dxf

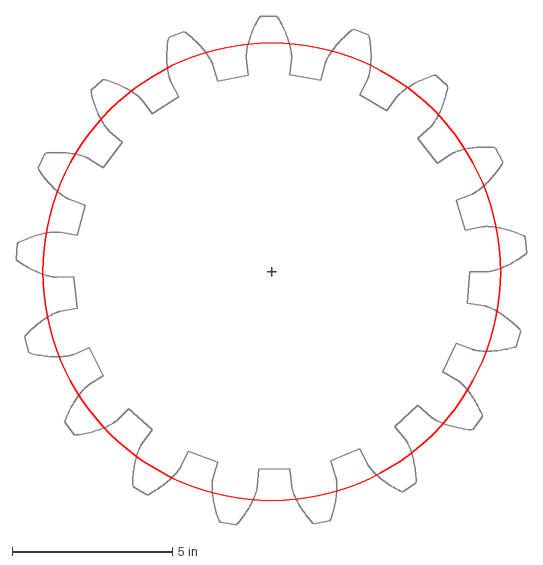
[picture p12: CAD file, 2016-09-23]
hw/cad/Gear_Patterns/gg_gear N17 D10.28 P1.65 PA20 @100.dxf
15.9 x 15.9 in
