dcellucci/MiniMOJO/hw/cad/Board_Stack_Spacer/20170211_Board_Stack_Spacer.stp

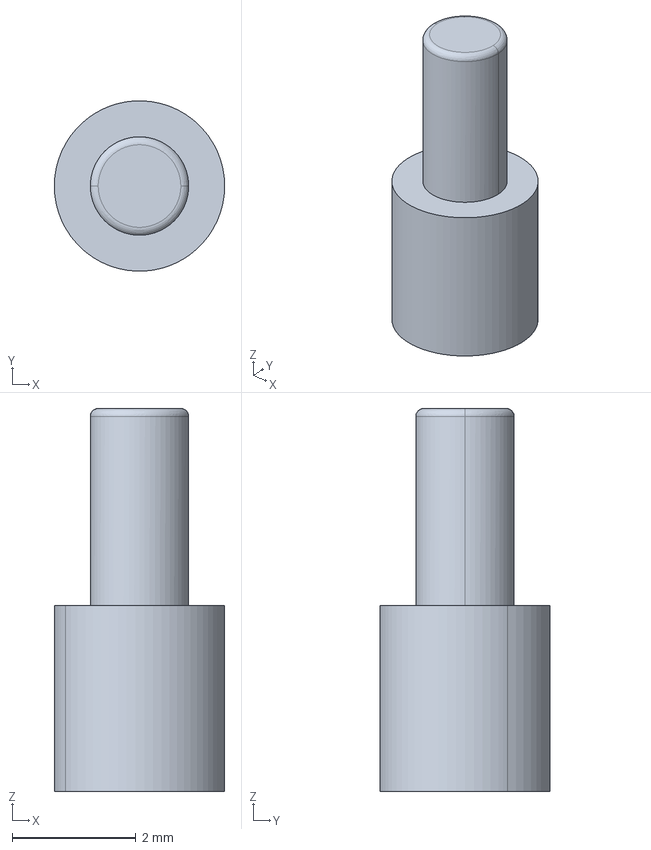
[picture p13: CAD file, 2017-02-11]
hw/cad/Board_Stack_Spacer/20170211_Board_Stack_Spacer.stp
2.75 x 2.75 x 6.18 mm
