dcellucci/MiniMOJO/hw/cad/Gear_Patterns/20160904_newgear_27PA_20T.dxf

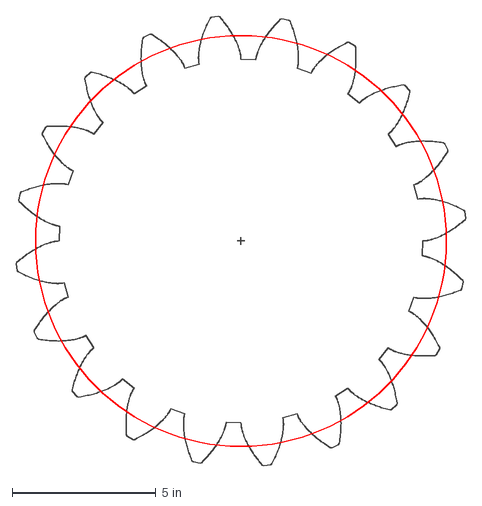
[picture p14: CAD file, 2016-09-23]
hw/cad/Gear_Patterns/20160904_newgear_27PA_20T.dxf
15.6 x 15.6 in
