dcellucci/MiniMOJO/hw/cad/Hex_Spacer/20161017_MM_TopHole_DWC.stp

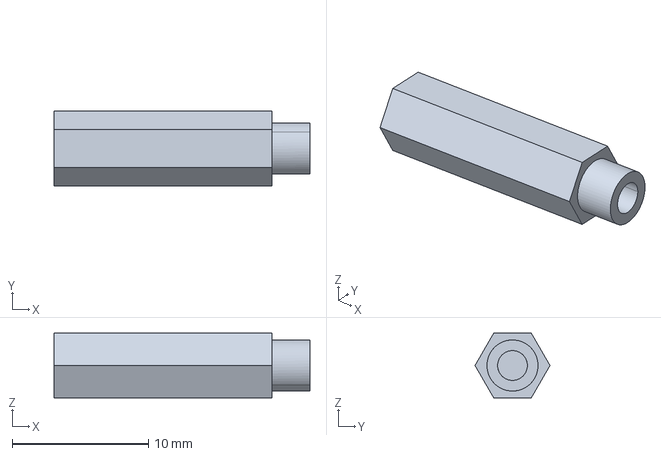
[picture p15: CAD file, 2017-02-11]
hw/cad/Hex_Spacer/20161017_MM_TopHole_DWC.stp
18.8 x 5.50 x 4.76 mm
