dcellucci/MiniMOJO/hw/cad/Plates/20170310_Plates_GearHoles_Final.dxf

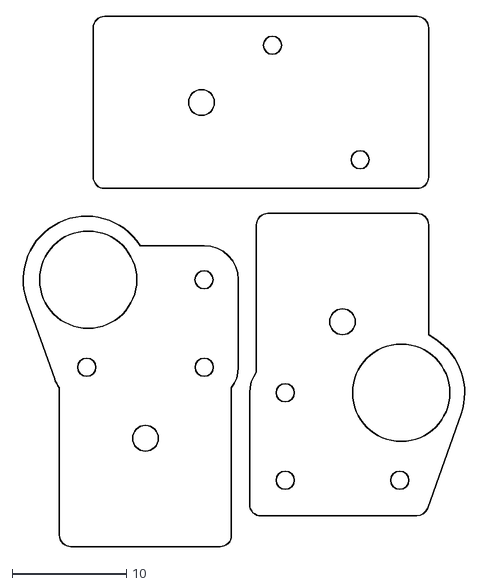
[picture p16: CAD file, 2017-03-20]
hw/cad/Plates/20170310_Plates_GearHoles_Final.dxf
39.8 x 46.4
