dcellucci/MiniMOJO/hw/cad/Spline_Adapter/20160924_MM_Spline_Adapter.dxf

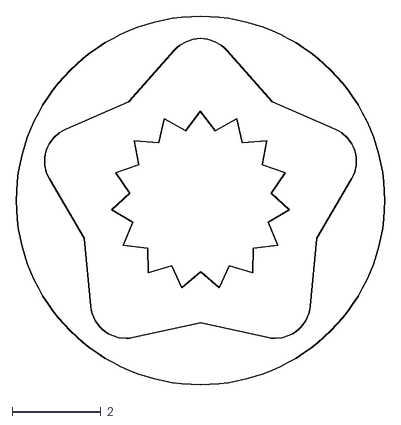
[picture p17: CAD file, 2016-09-24]
hw/cad/Spline_Adapter/20160924_MM_Spline_Adapter.dxf
8.30 x 8.30
