dcellucci/MiniMOJO/hw/cad/Plates/20170304_Plates_Drill_Jig.dxf

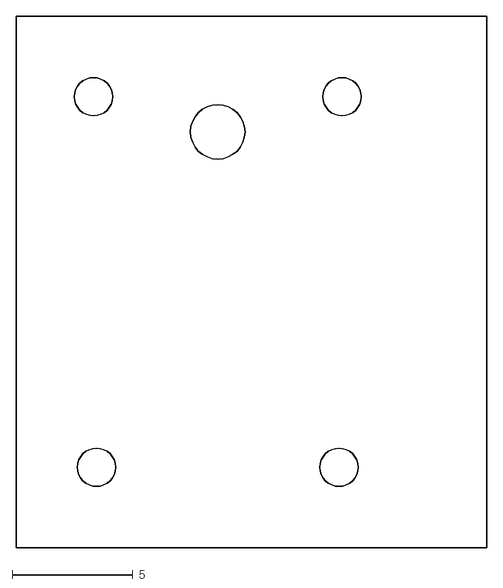
[picture p18: CAD file, 2017-03-06]
hw/cad/Plates/20170304_Plates_Drill_Jig.dxf
19.5 x 22.0
