dcellucci/MiniMOJO/hw/cad/Plates/20170201_Plates_BotHoles_Closer.dxf

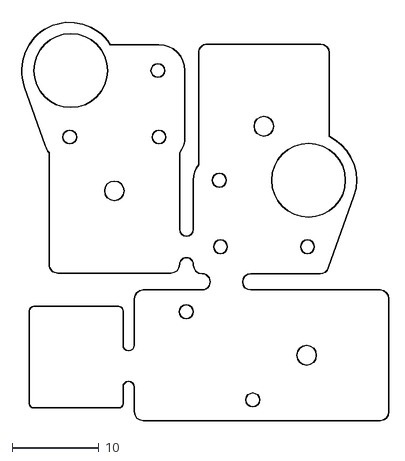
[picture p19: CAD file, 2017-02-09]
hw/cad/Plates/20170201_Plates_BotHoles_Closer.dxf
43.0 x 46.6
