dcellucci/MiniMOJO/tests/20161119_ServoTests/20161120_700g_100P_ColdStartTest_C.csv

No TMP007 sensor found
22.60 | 0.00
22.70 | 0.00
22.60 | 13.38
151.70 | 13.38
34.20 | 13.38
8.60 | 15.50
2.50 | 15.50
2.50 | 17.87
2.50 | 17.87
2.50 | 17.87
2.50 | 19.84
2.50 | 19.84
2.50 | 21.41
2.50 | 21.41
2.50 | 21.41
2.50 | 22.34
2.50 | 22.34
2.50 | 23.31
2.5022.50 | 23.44
22.60 | 23.44
44.20 | 28.03
256.60 | 28.03
374.70 | 28.03
355.40 | 28.00
363.90 | 28.00
358.60 | 28.00
353.10 | 28.00
348.00 | 28.00
346.60 | 27.97
344.00 | 27.97
341.90 | 28.03
341.10 | 28.03
338.10 | 28.03
338.20 | 28.09
336.30 | 28.09
335.40 | 28.19
333.00 | 28.19
332.50 | 28.19
329.50 | 28.22
328.20 | 28.22
326.80 | 28.22
326.50 | 28.22
324.00 | 28.22
324.90 | 28.25
323.70 | 28.25
323.30 | 28.25
322.10 | 28.25
321.80 | 28.25
319.80 | 28.31
318.40 | 28.31
317.50 | 28.31
317.50 | 28.53
315.80 | 28.53
316.90 | 31.87
315.80 | 31.87
315.30 | 31.87
314.20 | 33.94
314.30 | 33.94
312.40 | 34.84
311.90 | 34.84
311.00 | 34.84
311.80 | 34.94
309.60 | 34.94
311.00 | 34.59
310.40 | 34.59
310.20 | 34.59
309.40 | 34.06
309.30 | 34.06
308.20 | 33.38
307.70 | 33.38
307.10 | 33.38
307.60 | 32.63
305.90 | 32.63
307.30 | 31.94
306.70 | 31.94
306.60 | 31.94
305.70 | 31.28
306.10 | 31.28
304.90 | 30.66
304.70 | 30.66
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
