dcellucci/MiniMOJO/media/ServoCalibration.png

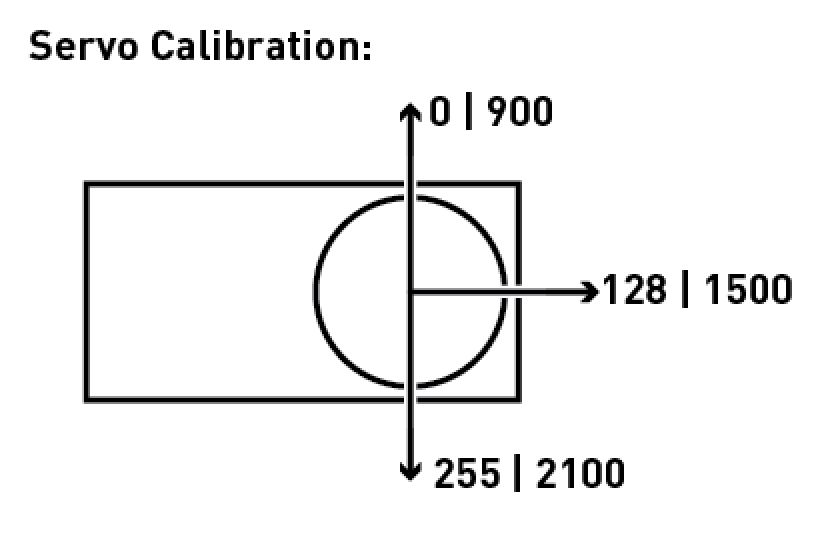
media/ServoCalibration.png
