dcellucci/MiniMOJO/(threads)

Thread 1 (2016-08-30):

Mod Tactile Switch

dcellucci, 2016-08-30:
Replace current switch with

http://www.digikey.com/product-detail/en/e-switch/TL3365AF180QG/EG5384CT-ND/5964420

Closed 2017-02-09.

Thread 4 (2017-02-07):

Fix Outer Arms

dcellucci, 2017-02-07:
Outer arms need to be modded to reduce slop. Suggest adding a bearing or shoulder bolt in order to prevent wobbling.

Closed 2017-03-01.

Thread 5 (2017-02-07):

Motor Calibration Jig

dcellucci, 2017-02-07:
An important step in MOJO assembly is motor calibration, where the zero-point and overall range are set. Right now this calibration is done by hand, but a jig will improve accuracy in this step considerably.
Some things to consider:

 1. Ensuring that the (odd toothed) spline is aligned properly, by using one of the custom fittings. Because there are an odd number of teeth in the spline, a servo horn can be put on backwards, resulting in a miscalibration of 18 degrees. This can be addressed by ensuring that the correct side servo horn is always attached.
 2. Having some kind of external protractor type implement for finding motor angles (see [the ServoCity servo protractor](https://www.servocity.com/servo-protractor)). Note that this protractor only works with the larger 24 tooth spline servos, not the nano size.

Closed 2017-03-01.

Thread 6 (2017-02-07):

Motor Stack Assembly Jig

dcellucci, 2017-02-07:
The current motor stack assembly jig is laser cut delrin and uses flexures for alignment. It can result in significant misalignment of the motors, both positional and angular, as well as consistently producing a slight misalignment in the position of the hex standoff.

Closed 2017-03-01.

Thread 7 (2017-02-09):

ATSAMD11 Core

dcellucci, 2017-02-09:
The new controller for the servos is the ATSAMD11 instead of the ATTiny841. This chip adds critical functionality to the system, at the cost of higher complexity.

## Prototyping
We can prototype boards which use this core with the SRM-20, since the D11 comes in an SOIC package.
 1. Layout and create these boards using [KiCAD](http://kicad-pcb.org) and the [CSL-Part-Library](https://github.com/codedstructureslab/CSL-Part-Library)
 2. Burn [bootloader](https://github.com/mattairtech/ArduinoCore-samd) and familiarize with arduino core (it will be modified for the MiniMOJO version)
 3. Write library that adds a second I2C bus
 4. Verify Servo library functionality on the selected pins

Closed 2017-03-01.

Thread 8 (2017-02-09):

MMv3 Sensor Libraries

dcellucci, 2017-02-09:
The newest version of the MiniMOJO control boards adds several critical sensors.

 1. A [high-side switch](http://www.ti.com/product/TPS2559) that controls the motor supply. As the input for this switch is only a logic signal, the "library" will likely be only a few lines of code.
 2. A [three-channel current sensor](http://www.ti.com/product/INA3221) that provides current consumption information for each servo.
 3. A [battery monitor](https://www.maximintegrated.com/en/products/power/battery-management/MAX17201.html) that provides State of Charge (SoC) feedback.
 4. An [IMU](https://github.com/sparkfun/LSM9DS1_Breakout) that provides heading, orientation, and acceleration information.

Of these, only the IMU has an established library that's already written.
