dcellucci/MiniMOJO/hw/cad/Board_Stack_Spacer/20170211_Board_Stack_Spacer.PDF

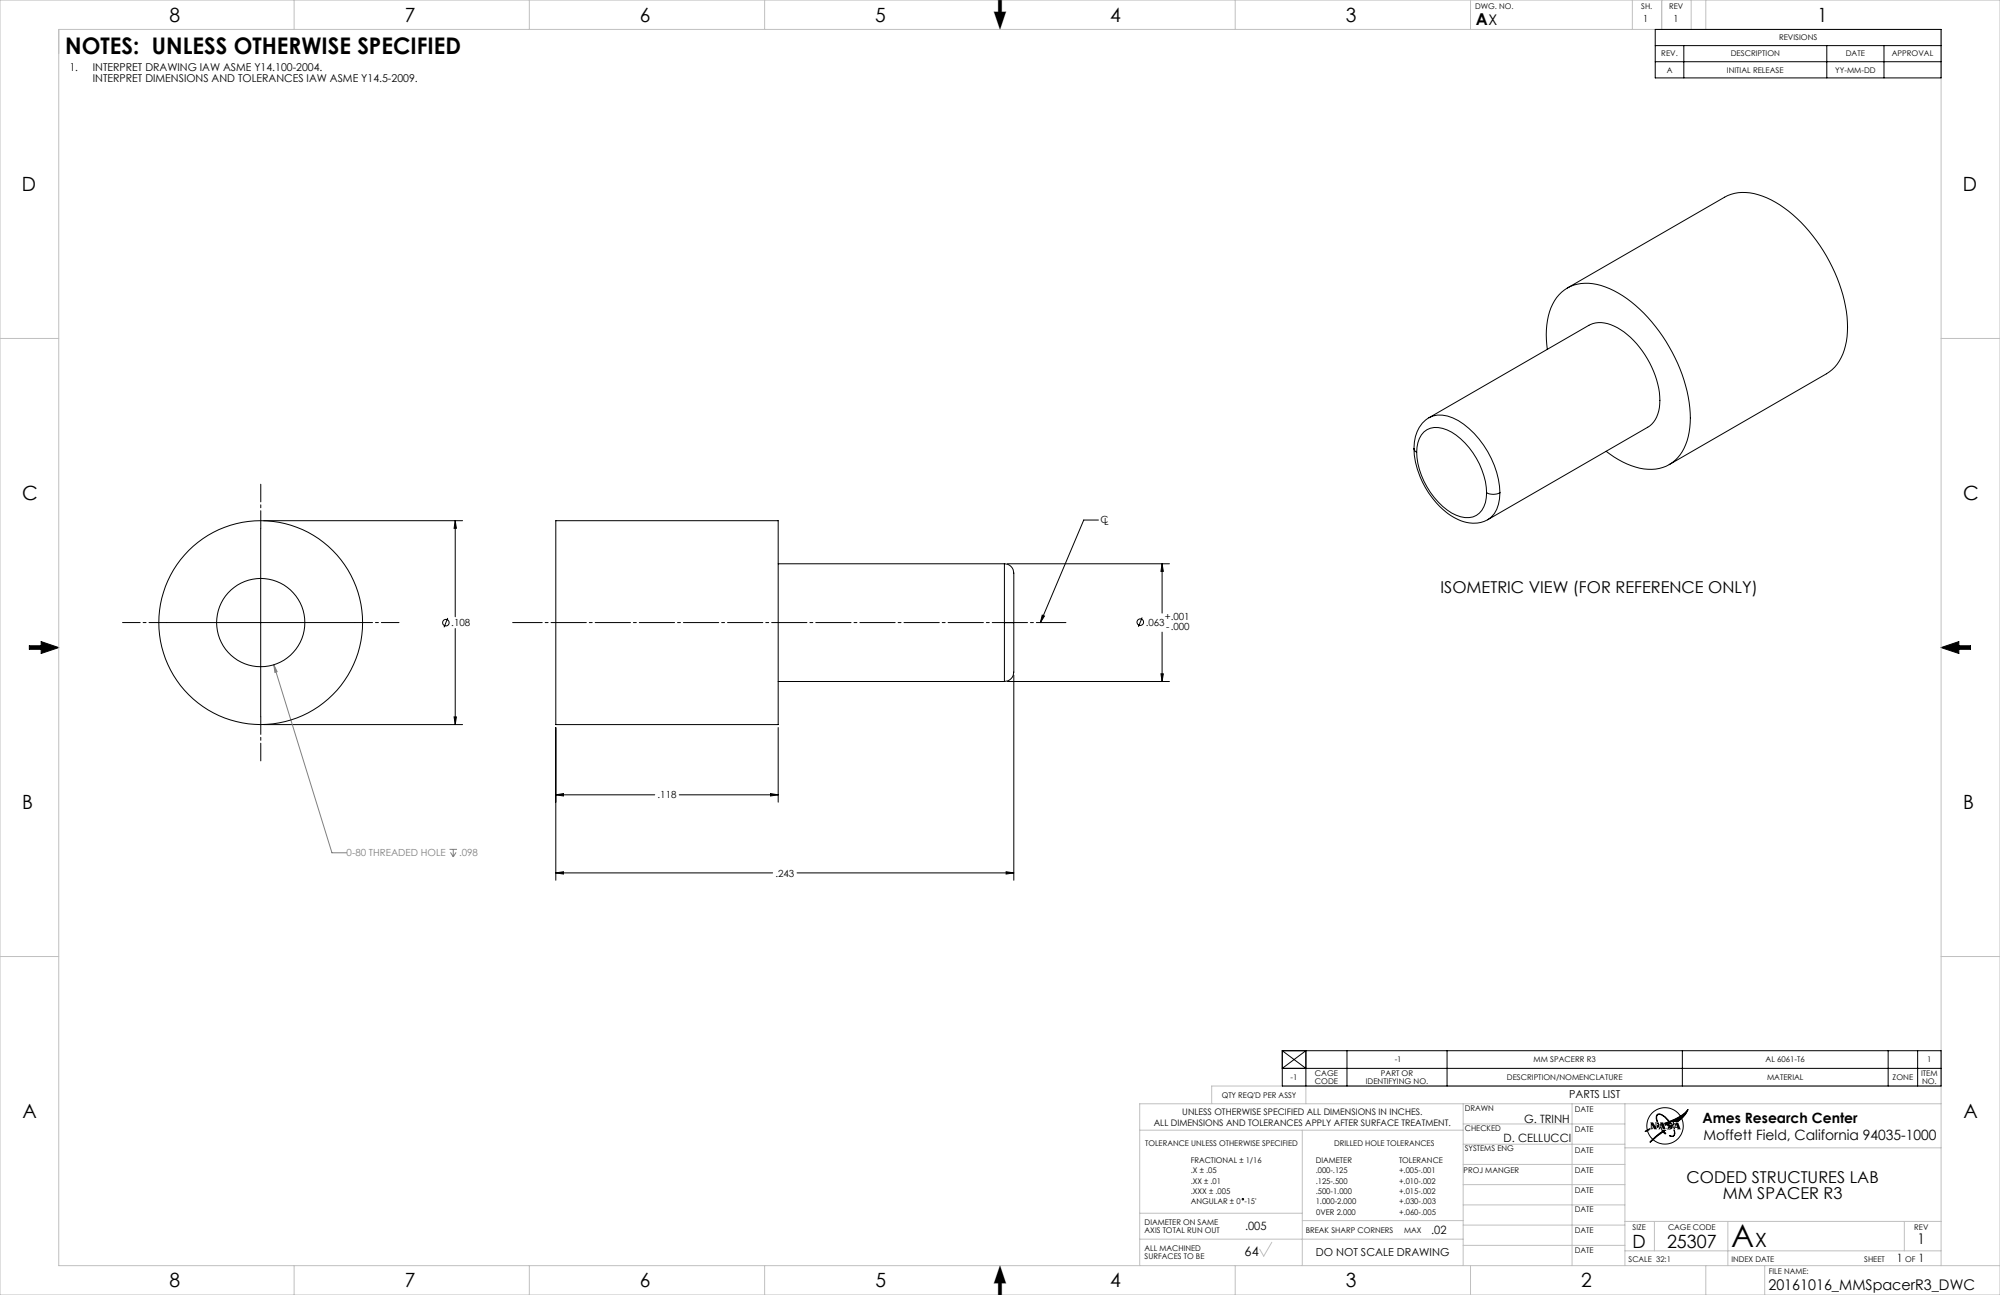
[picture p21: page 1]
0-80 THREADED HOLE .098; QTY REQ'D PER ASSY; PARTS LIST; DRILLED HOLE TOLERANCES; 0VER 2.000; .XXX ± .005; DWG. NO.; REV; SCALE 32:1; INDEX DATE; SIZE; CAGE CODE; FILE NAME:; DO NOT SCALE DRAWING; FRACTIONAL ± 1/16; ANGULAR ± 0 -15'; BREAK SHARP CORNERS MAX; SYSTEMS ENG; PROJ MANGER; D. CELLUCCI; G. TRINH

NOTES: UNLESS OTHERWISE SPECIFIED

REV. | DESCRIPTION | DATE | APPROVAL
A | INITIAL RELEASE | YY-MM-DD

1. INTERPRET DRAWING IAW ASME Y14.100-2004.
INTERPRET DIMENSIONS AND TOLERANCES IAW ASME Y14.5-2009.

ISOMETRIC VIEW (FOR REFERENCE ONLY)

-1 | MM SPACERR R3 | AL 6061-T6 | | 1

-1 | CAGE CODE | IDENTIFYING NO. PART OR | DESCRIPTION/NOMENCLATURE | MATERIAL | ZONE | ITEM NO.

UNLESS OTHERWISE SPECIFIED ALL DIMENSIONS IN INCHES.
ALL DIMENSIONS AND TOLERANCES APPLY AFTER SURFACE TREATMENT.

Ames Research Center
Moffett Field, California 94035-1000
CODED STRUCTURES LAB
MM SPACER R3

TOLERANCE UNLESS OTHERWISE SPECIFIED

DIAMETER ON SAME
AXIS TOTAL RUN OUT
ALL MACHINED
SURFACES TO BE
