dcellucci/MiniMOJO/hw/cad/Hex_Spacer/20161017_MM_TopHole_DWC.PDF

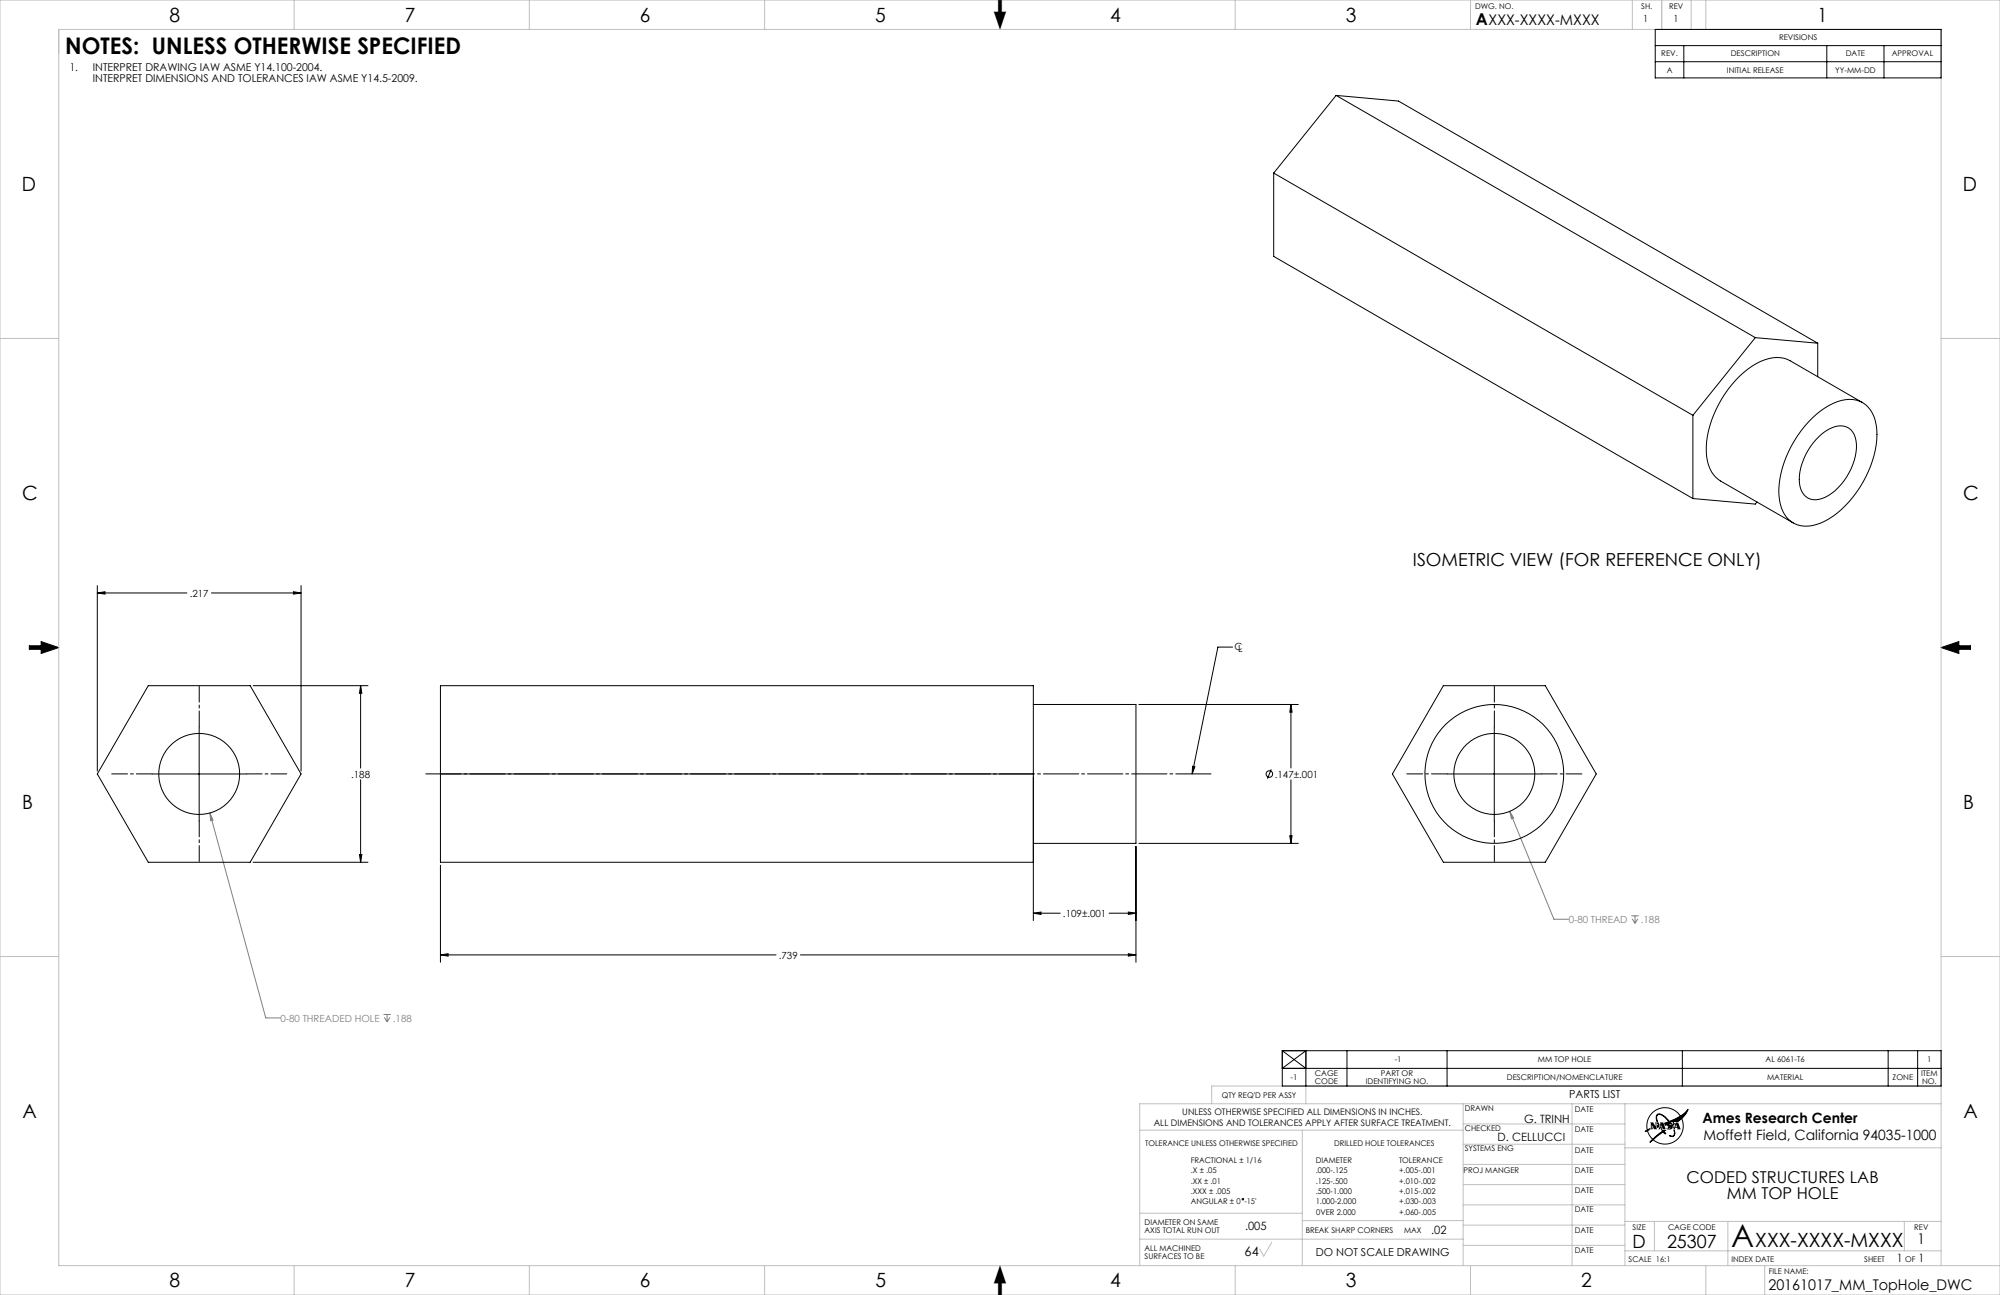
[picture p22: page 1]
0-80 THREADED HOLE .188; 0-80 THREAD .188; QTY REQ'D PER ASSY; PARTS LIST; DRILLED HOLE TOLERANCES; 0VER 2.000; .XXX ± .005; DWG. NO.; REV; SCALE 16:1; INDEX DATE; SIZE; CAGE CODE; FILE NAME:; FRACTIONAL ± 1/16; ANGULAR ± 0 -15'; BREAK SHARP CORNERS MAX; SYSTEMS ENG; XXX-XXXX-MXXX .02 .005; G. TRINH; PROJ MANGER; D. CELLUCCI

XXX-XXXX-MXXX

NOTES: UNLESS OTHERWISE SPECIFIED

REV. | DESCRIPTION | DATE | APPROVAL
A | INITIAL RELEASE | YY-MM-DD

1. INTERPRET DRAWING IAW ASME Y14.100-2004.
INTERPRET DIMENSIONS AND TOLERANCES IAW ASME Y14.5-2009.

ISOMETRIC VIEW (FOR REFERENCE ONLY)

-1 | MM TOP HOLE | AL 6061-T6 | | 1

-1 | CAGE CODE | IDENTIFYING NO. PART OR | DESCRIPTION/NOMENCLATURE | MATERIAL | ZONE | ITEM NO.

UNLESS OTHERWISE SPECIFIED ALL DIMENSIONS IN INCHES.
ALL DIMENSIONS AND TOLERANCES APPLY AFTER SURFACE TREATMENT.

Ames Research Center
Moffett Field, California 94035-1000
CODED STRUCTURES LAB
MM TOP HOLE

TOLERANCE UNLESS OTHERWISE SPECIFIED

DIAMETER ON SAME
AXIS TOTAL RUN OUT
ALL MACHINED
SURFACES TO BE

DO NOT SCALE DRAWING
