dcellucci/MiniMOJO/hw/PCB/KICAD/D11D_Programmer_Adapter/CAM/D11D_Adapter_Base.pdf

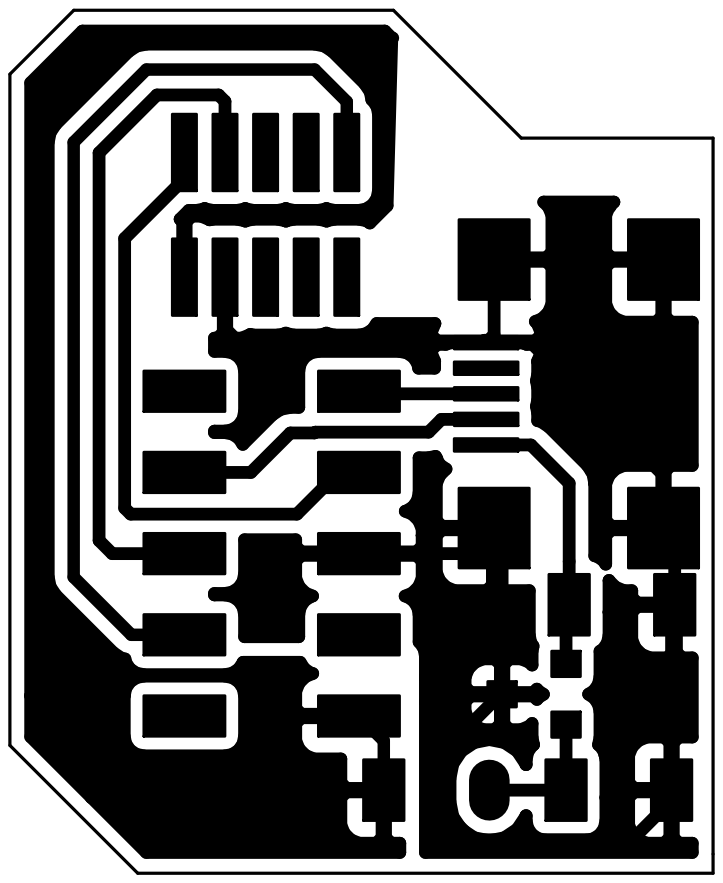
[picture p23: page 1]

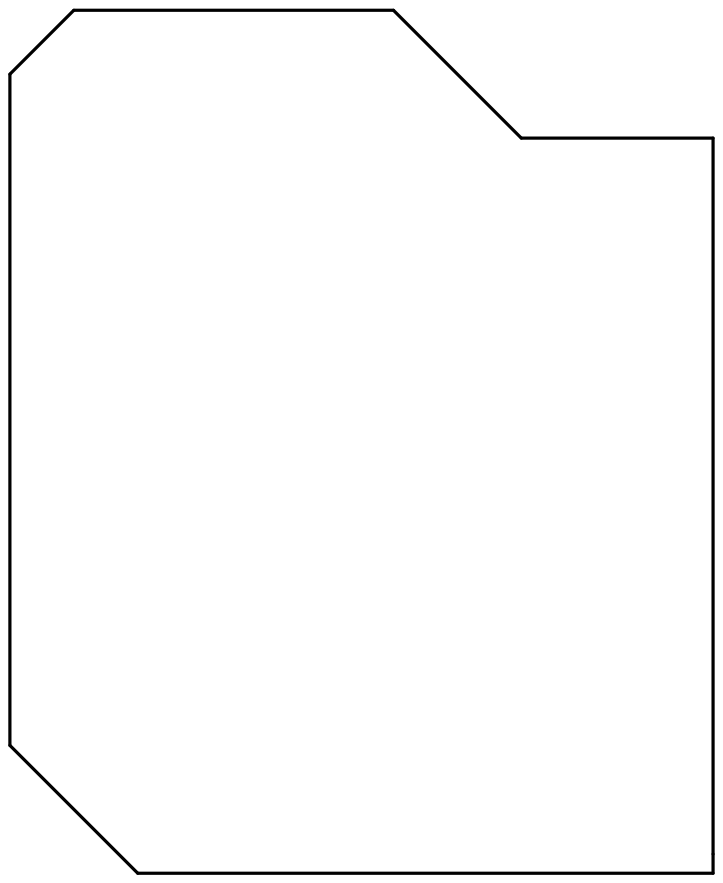
[picture p24: page 2]
