dcellucci/MiniMOJO/hw/PCB/KICAD/R21_Core_2/R21_Core.kicad_pcb

## KiCad design hw/PCB/KICAD/R21_Core_2/R21_Core.kicad_pcb (2017-03-20)

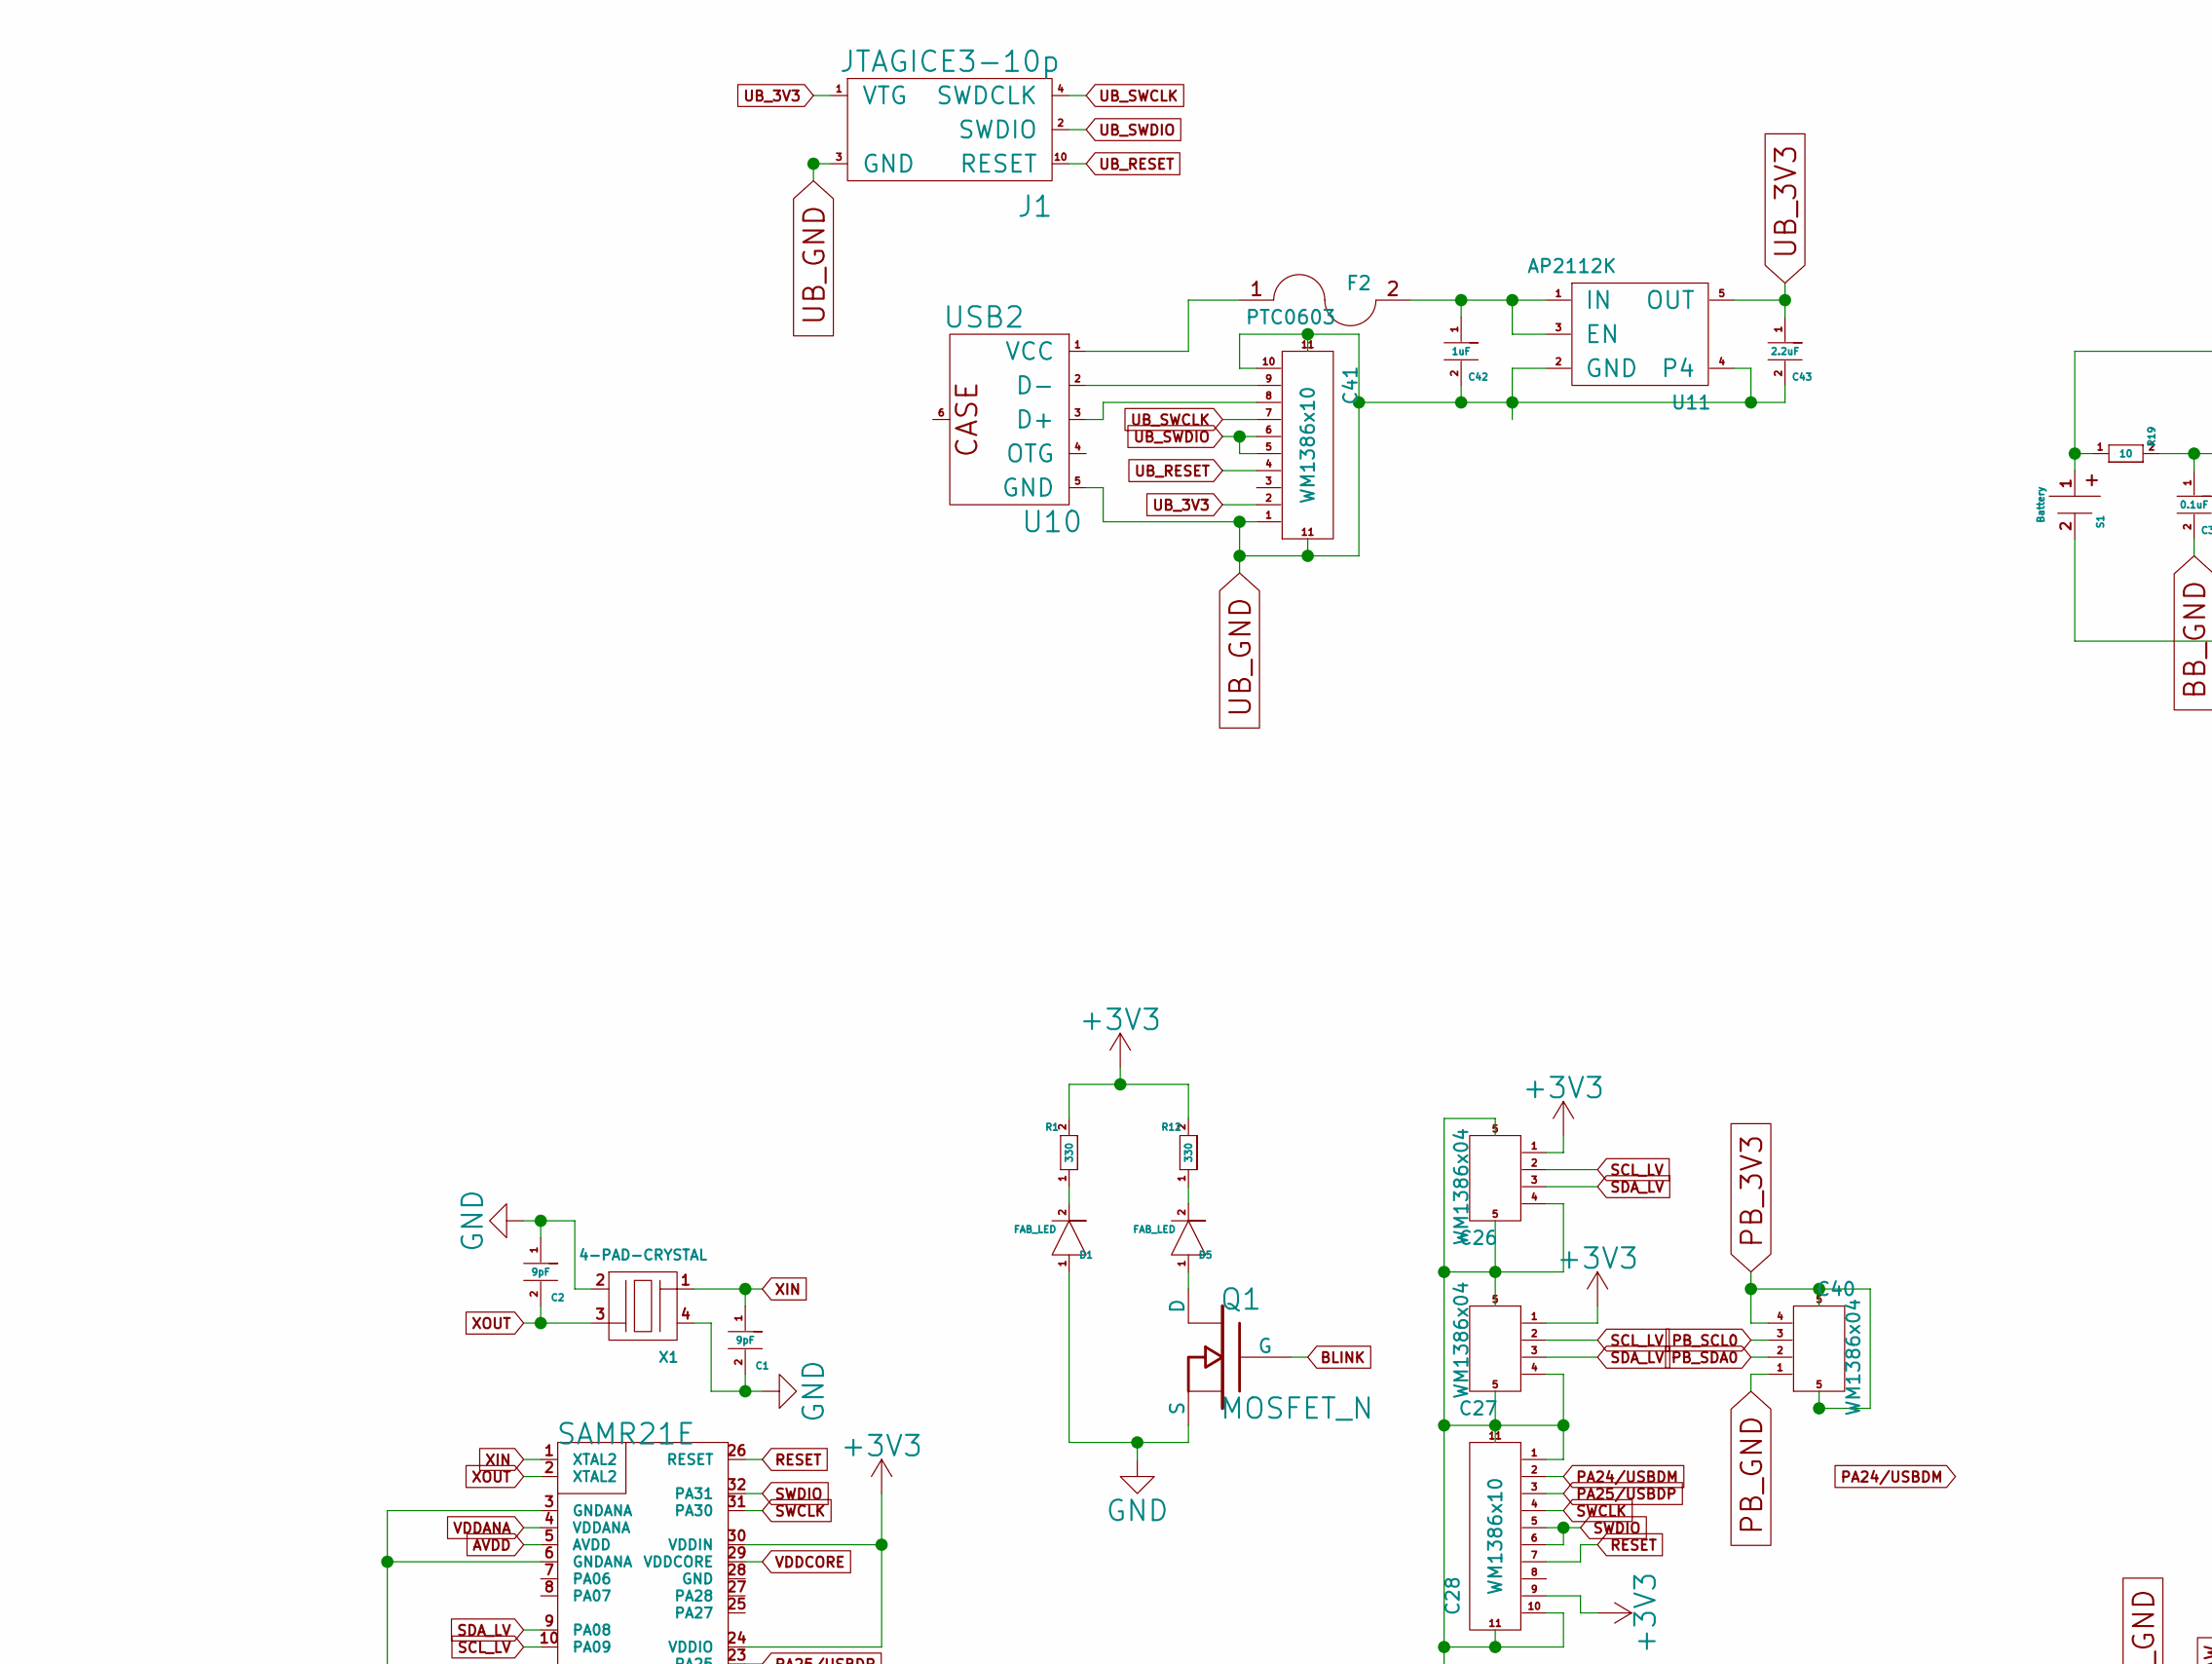
[picture p25: schematic R21_Core.sch, part in row 1, column 1]

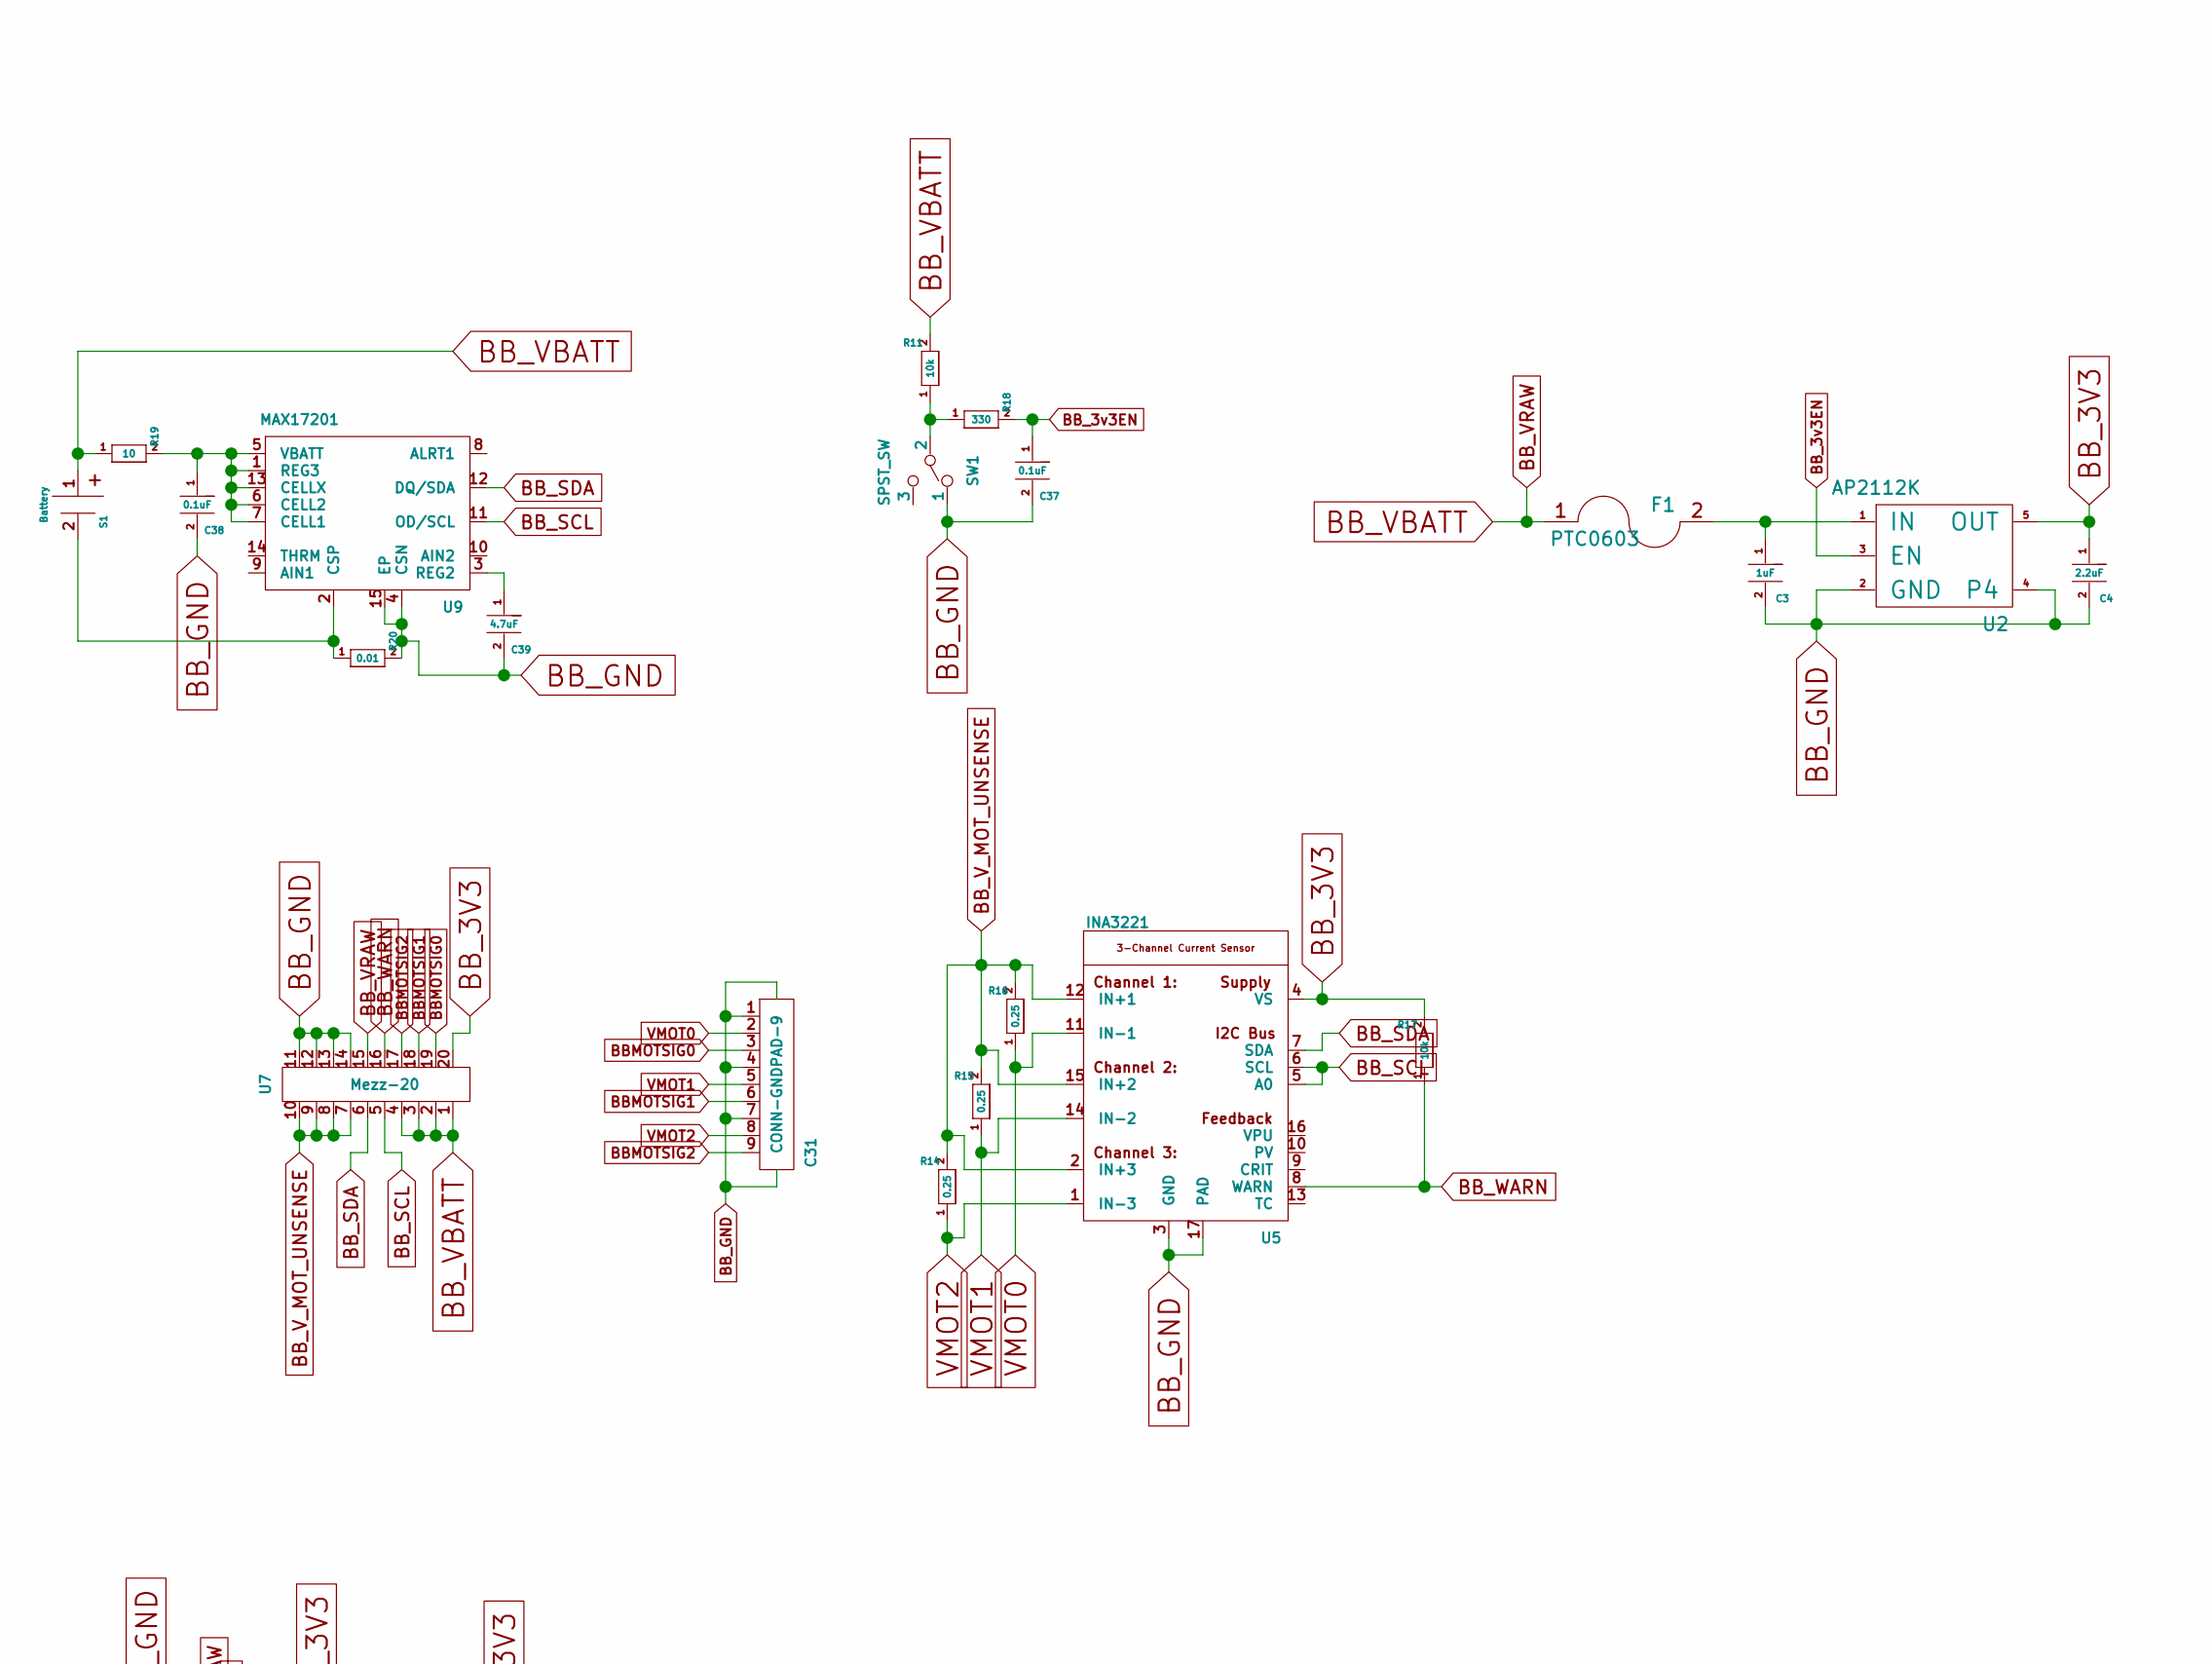
[picture p26: schematic R21_Core.sch, part in row 1, column 2]

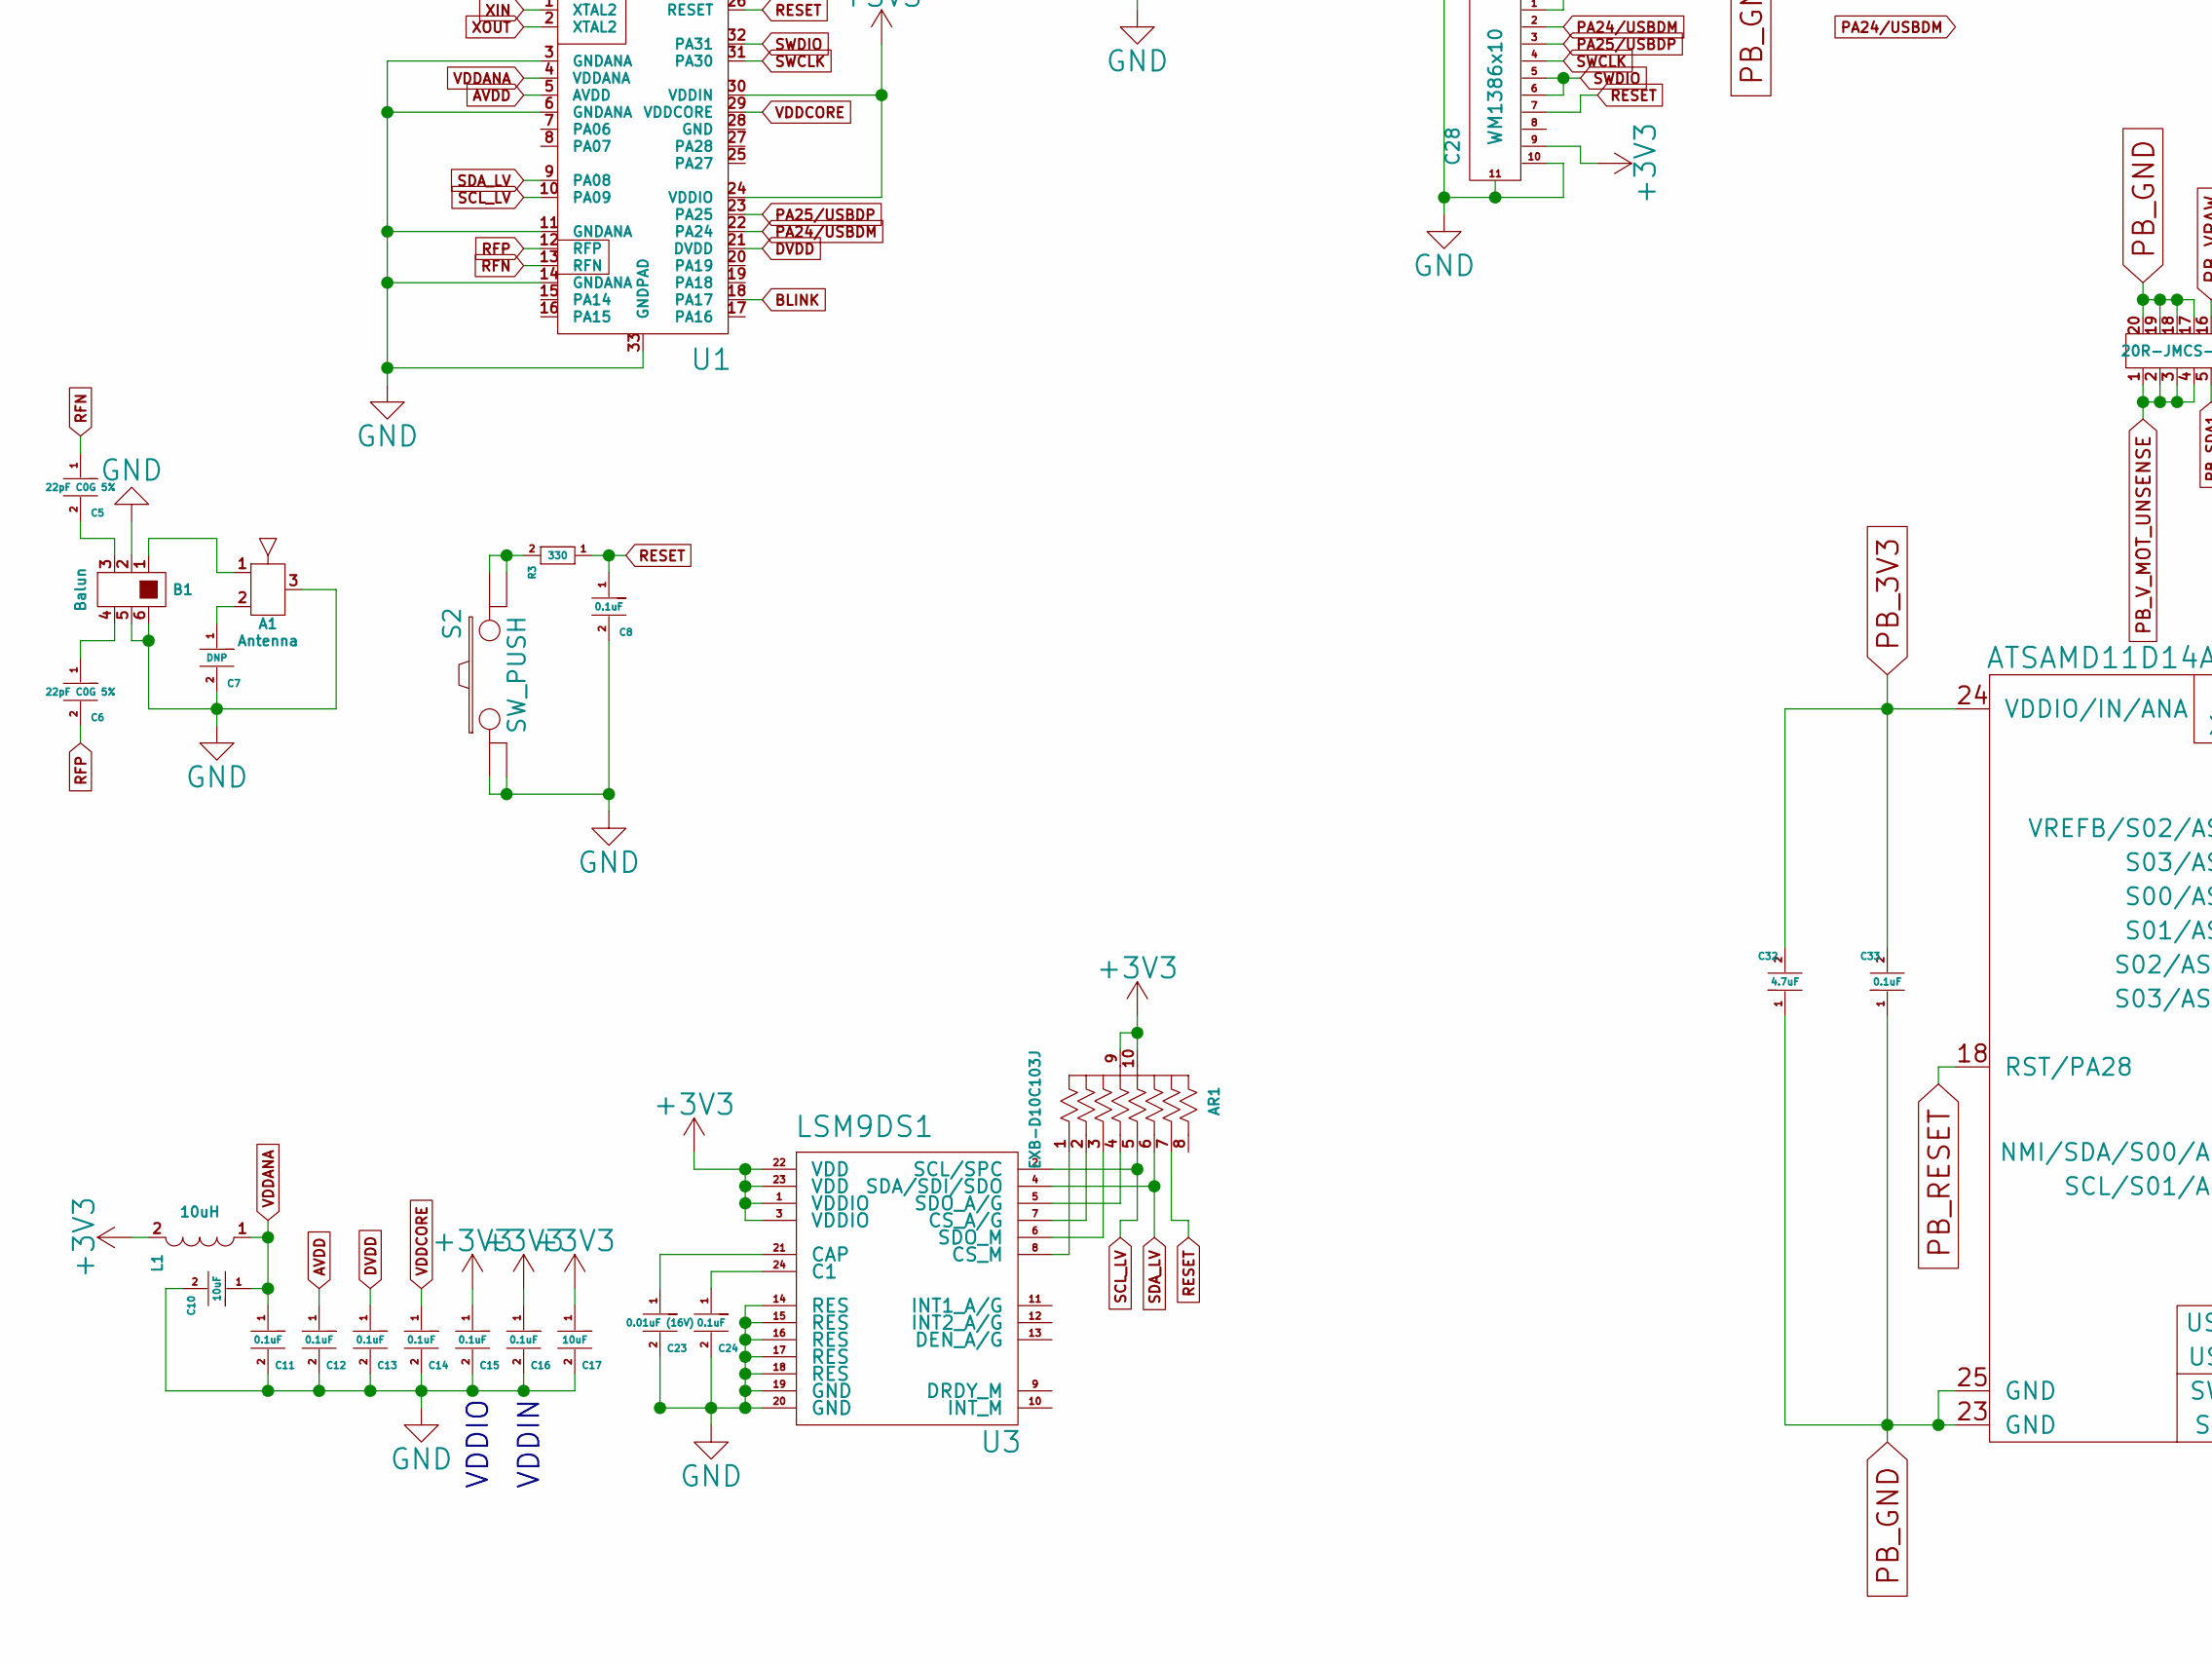
[picture p27: schematic R21_Core.sch, part in row 2, column 1]

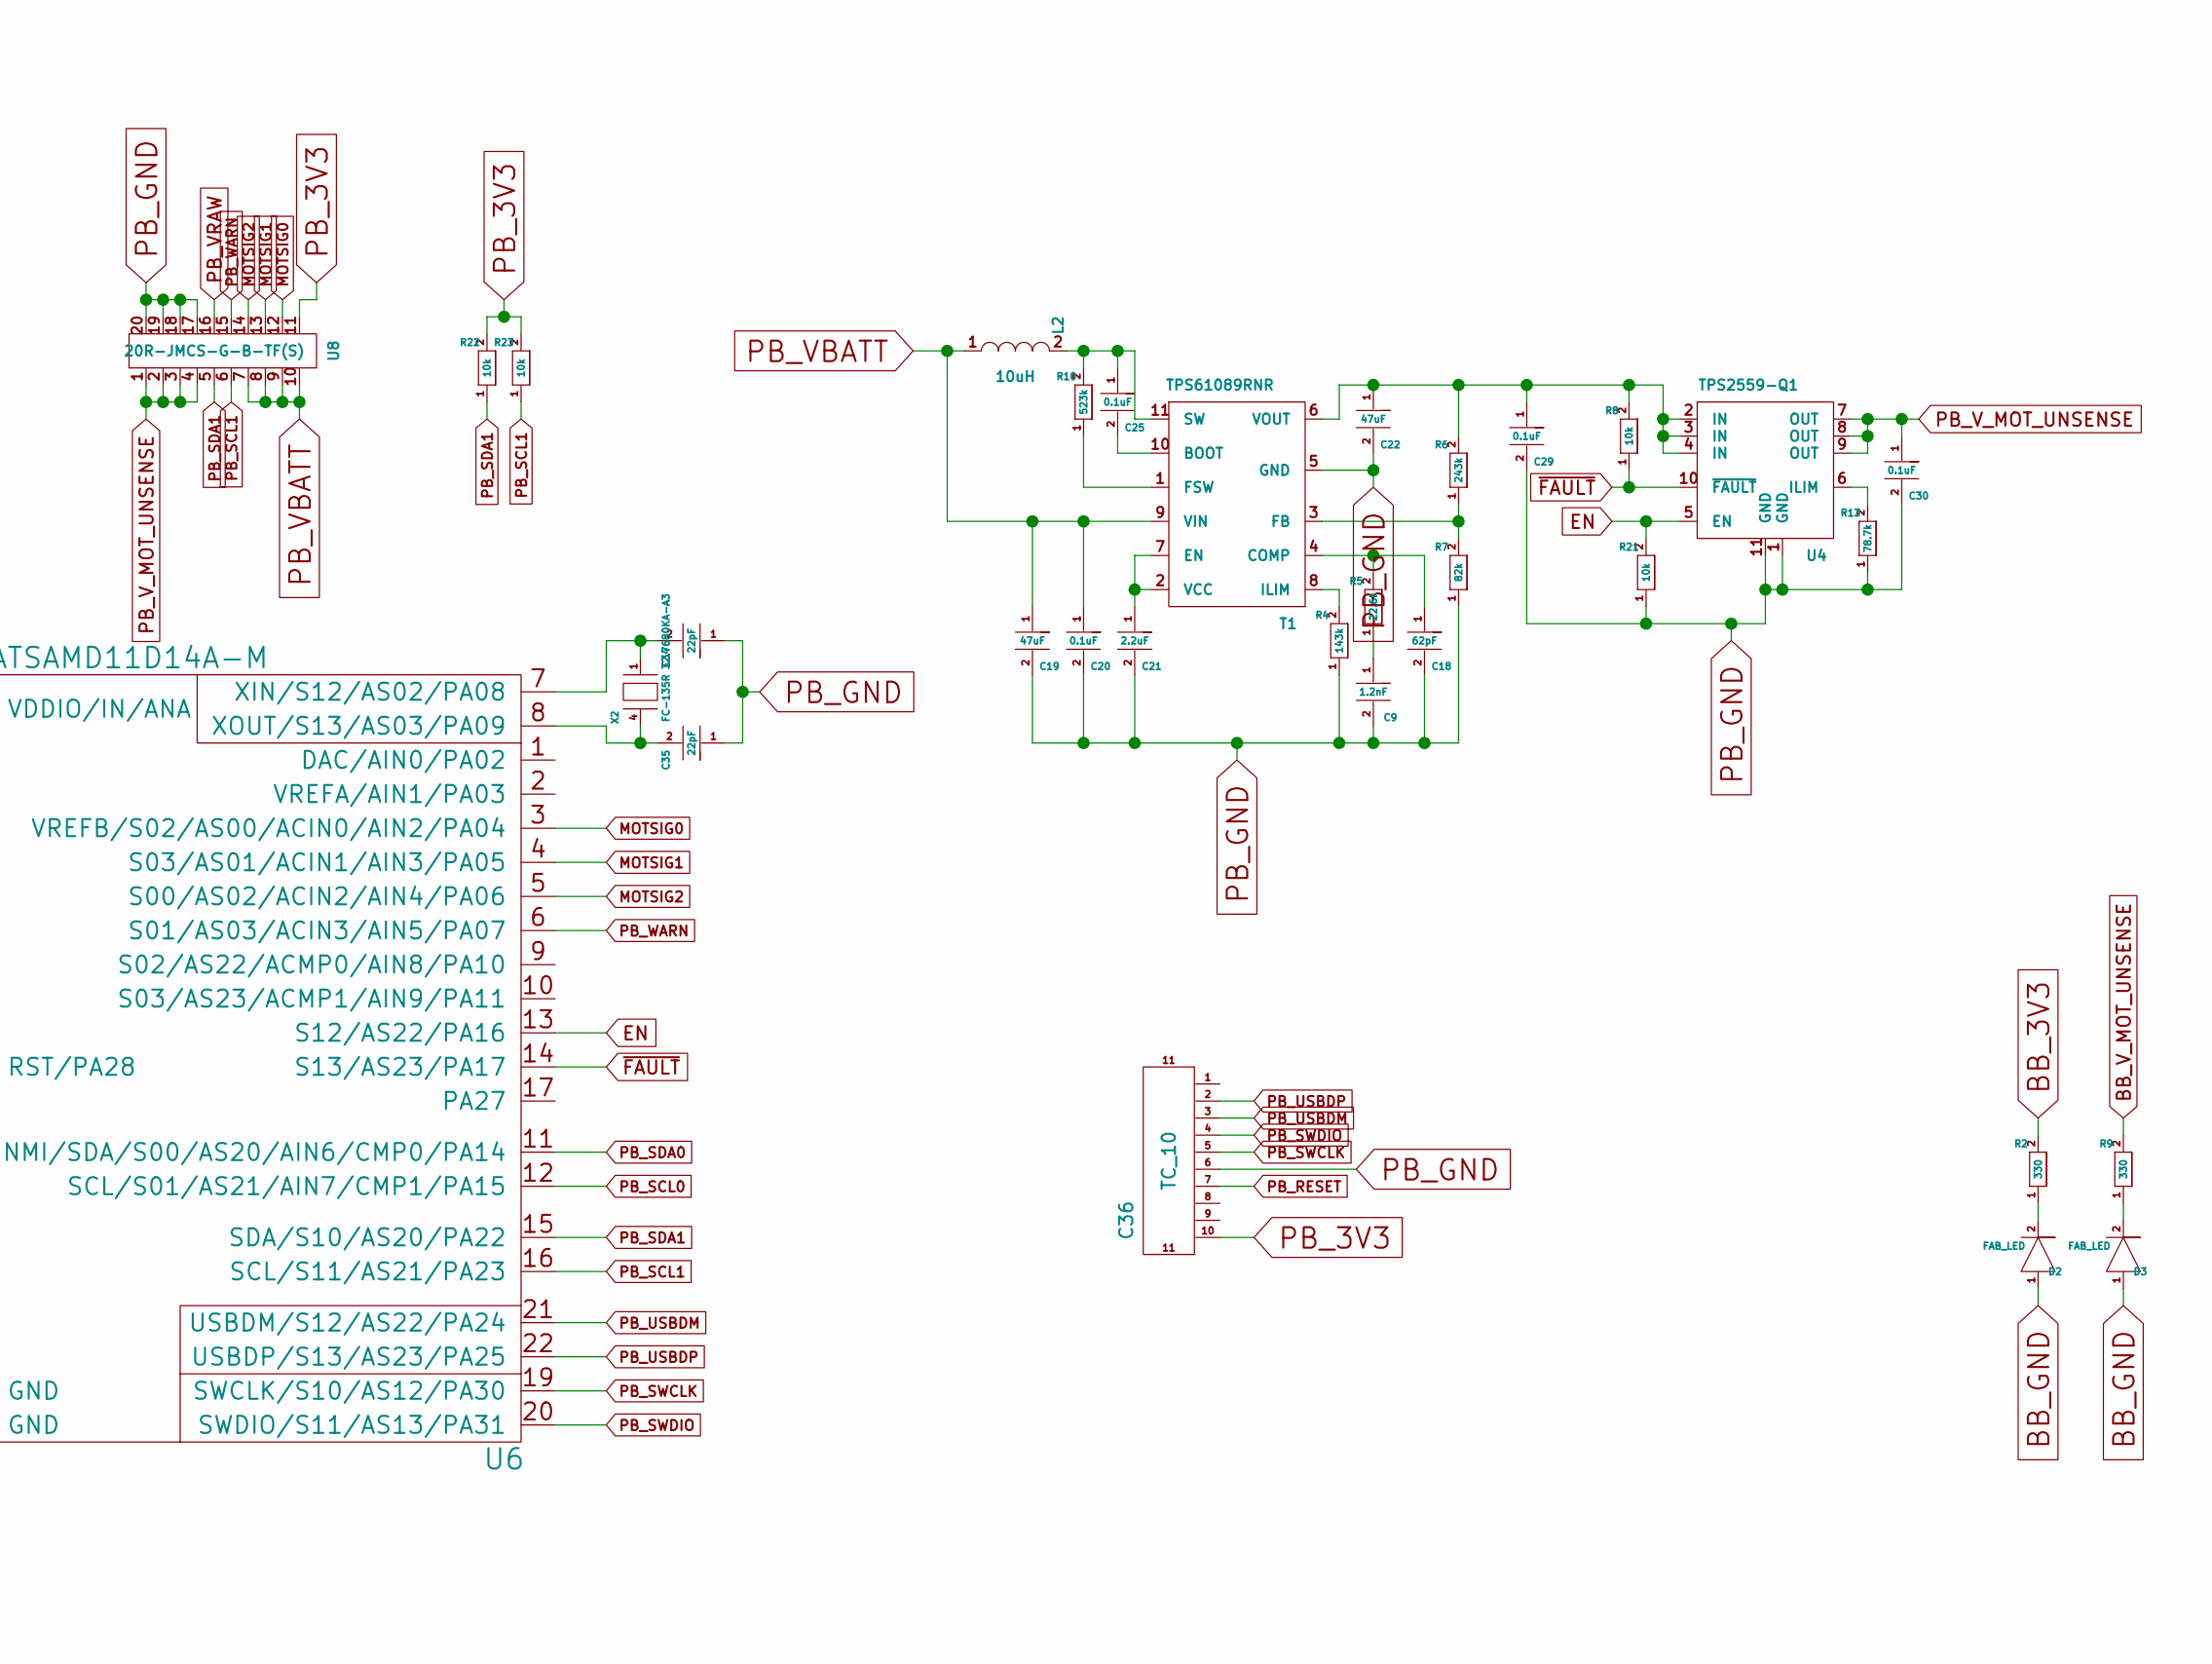
[picture p28: schematic R21_Core.sch, part in row 2, column 2]

Parts:
A1: Antenna; W3008C-ANT
AR1: EXB-D10C103J; RESARR8BUS-1206
B1: Balun; 0805_Balun
C1, C2: 9pF; C_0402
C3, C42: 1uF; C_0402
C4, C43: 2.2uF; C_0402
C5, C6: 22pF C0G 5%; C_0402
C7: DNP
C8, C11, C12, C13, C14, C15, C16, C20, C24, C25, C29, C30, C33, C37, C38: 0.1uF; C_0402
C9: 1.2nF; C_0805
C10, C17: 10uF; C_0402
C18: 62pF; C_0805
C19, C22: 47uF; C_1206
C21: 2.2uF; C_0603
C23: 0.01uF (16V); C_0402
C26, C27, C40: WM1386x04; WM1386x04-REC
C28, C41: WM1386x10; WM1387x10-REC
C31: CONN-GNDPAD-9; JST-SH-9
C32, C39: 4.7uF; C_0402
C34, C35: 22pF; C_0402
C36: TC_10; TagConnectx10
D1, D2, D3, D5: FAB_LED; LED_0603
F1, F2: PTC0603; R_0603
J1: JTAGICE3-10p
L1: 10uH; C_0603
L2: 10uH; Inductor_Wurth_MAPI-4020
Q1: MOSFET_N; SOT-23
R1, R2, R3, R9, R12, R18: 330; R_0402
R4: 143k; R_1206
R5: 22.6k; R_0402
R6: 243k; R_0402
R7: 82k; R_0603
R8, R11, R17, R21, R22, R23: 10k; R_0402
R10: 523k; R_1206
R13: 78.7k; R_0402
R14, R15, R16: 0.25; R_1206
R19: 10; R_0402
R20: 0.01; R_1206
S1: Battery; Inductor_Taiyo-Yuden_NR-80xx_HandSoldering
S2: SW_PUSH; SPST-NO-TL3700
SW1: SPST_SW; SPDT-Side
T1: TPS61089RNR; TPS61089RNRR
U1: SAMR21E; QFN-32-1EP_5x5mm_Pitch0.5mm
U2, U11: AP2112K; SOT-23-5
U3: LSM9DS1
U4: TPS2559-Q1; DFN-10-1EP_3x3mm_Pitch0.5mm
U5: INA3221; QFN-16-1EP_4x4mm_Pitch0.65mm
U6: ATSAMD11D14A-M; QFN-24-1EP_4x4mm_Pitch0.5mm
U7: Mezz-20; Mezz-20-Plug
U8: 20R-JMCS-G-B-TF(S); Mezz-20-Recep
U9: MAX17201; DFN14-1EP-3x3
U10: USB2; USBMICRO-10104110
X1: 4-PAD-CRYSTAL; 4-SMD-CRYSTAL-3.2x2.5
X2: FC-135R 32.7680KA-A3; Crystal_SMD_EuroQuartz_EQ161-2pin_3.2x1.5mm

Connections:
+3V3: AR1.9, AR1.10, C15.1, C16.1, C17.1, C26.1, C27.1, C28.9, L1.2, R1.2, R12.2, U1.24 (VDDIO), U1.30 (VDDIN), U3.1 (VDDIO), U3.3 (VDDIO), U3.22 (VDD), U3.23 (VDD)
AVDD: C12.1, U1.5 (AVDD)
BBMOTSIG0: C31.3, U7.19
BBMOTSIG1: C31.6, U7.18
BBMOTSIG2: C31.9, U7.17
BB_3V3: C4.1, R2.2, R17.2, U2.5 (OUT), U5.4 (VS), U7.20
BB_3v3EN: C37.1, R18.2, U2.3 (EN)
BB_GND: C3.2, C4.2, C31.1, C31.4, C31.7, C31.10, C37.2, C38.2, C39.2, D2.1, D3.1, R20.2, SW1.1, U2.2 (GND), U2.4, U5.3 (GND), U5.17 (PAD), U7.11, U7.12, U7.13, U7.14, U9.4 (CSN), U9.15 (EP)
BB_SCL: U5.5 (A0), U5.6 (SCL), U7.5, U9.11 (OD/SCL)
BB_SDA: U5.7 (SDA), U7.6, U9.12 (DQ/SDA)
BB_VBATT: F1.1, R11.2, R19.1, S1.1, U7.1, U7.2, U7.3, U7.4, U7.15
BB_V_MOT_UNSENSE: R9.2, R14.2, R15.2, R16.2, U5.2 (IN+3), U5.12 (IN+1), U5.15 (IN+2), U7.7, U7.8, U7.9, U7.10
BB_WARN: R17.1, U5.8 (WARN), U7.16
BLINK: Q1.G, U1.18 (PA17)
DVDD: C13.1, U1.21 (DVDD)
EN: R21.2, U4.5 (EN), U6.13 (S12/AS22/PA16)
GND: A1.3, B1.2, B1.5, B1.6, C1.2, C2.1, C7.2, C8.2, C10.2, C11.2, C12.2, C13.2, C14.2, C15.2, C16.2, C17.2, C23.2, C24.2, C26.4, C26.5, C27.4, C27.5, C28.1, C28.10, C28.11, D1.1, Q1.S, S2.1, S2.2, U1.3 (GNDANA), U1.6 (GNDANA), U1.11 (GNDANA), U1.14 (GNDANA), U1.33 (GNDPAD), U3.14 (RES), U3.15 (RES), U3.16 (RES), U3.17 (RES), U3.18 (RES), U3.19 (GND), U3.20 (GND), X1.2, X1.4
MOTSIG0: U6.3 (VREFB/S02/AS00/ACIN0/AIN2/PA04), U8.12
MOTSIG1: U6.4 (S03/AS01/ACIN1/AIN3/PA05), U8.13
MOTSIG2: U6.5 (S00/AS02/ACIN2/AIN4/PA06), U8.14
unnamed: A1.1, B1.1
unnamed: A1.2, C7.1
unnamed: AR1.1, U3.8 (CS_M)
unnamed: AR1.2, U3.7 (CS_A/G)
unnamed: AR1.3, U3.6 (SDO_M)
unnamed: AR1.4, U3.5 (SDO_A/G)
unnamed: B1.3, C5.2
unnamed: B1.4, C6.1
unnamed: C3.1, F1.2, U2.1 (IN)
unnamed: C9.1, R5.1
unnamed: C18.1, R5.2, T1.4 (COMP)
unnamed: C21.1, T1.2 (VCC), T1.7 (EN)
unnamed: C22.1, C29.1, R6.2, R8.2, T1.6 (VOUT), U4.2 (IN), U4.3 (IN), U4.4 (IN)
unnamed: C23.1, U3.21 (CAP)
unnamed: C24.1, U3.24 (C1)
unnamed: C25.1, L2.2, R10.2, T1.11 (SW)
unnamed: C25.2, T1.10 (BOOT)
unnamed: C34.2, U6.7 (XIN/S12/AS02/PA08), X2.1
unnamed: C35.2, U6.8 (XOUT/S13/AS03/PA09), X2.4
unnamed: C38.1, R19.2, U9.1 (REG3), U9.5 (VBATT), U9.6 (CELL2), U9.7 (CELL1), U9.13 (CELLX)
unnamed: C39.1, U9.3 (REG2)
unnamed: C41.8, U10.3 (D+)
unnamed: C41.9, U10.2 (D-)
unnamed: C42.1, F2.2, U11.1 (IN), U11.3 (EN)
unnamed: D1.2, R1.1
unnamed: D2.2, R2.1
unnamed: D3.2, R9.1
unnamed: D5.1, Q1.D
unnamed: D5.2, R12.1
unnamed: F2.1, U10.1 (VCC)
unnamed: R3.2, S2.3, S2.4
unnamed: R4.2, T1.8 (ILIM)
unnamed: R6.1, R7.2, T1.3 (FB)
unnamed: R10.1, T1.1 (FSW)
unnamed: R11.1, R18.1, SW1.2
unnamed: R13.2, U4.6 (ILIM)
unnamed: R20.1, S1.2, U9.2 (CSP)
PA24/USBDM: C28.2, U1.22 (PA24)
PA25/USBDP: C28.3, U1.23 (PA25)
PB_3V3: C32.2, C33.2, C36.10, C40.4, C40.5, R22.2, R23.2, U6.24 (VDDIO/IN/ANA), U8.11
PB_GND: C9.2, C18.2, C19.2, C20.2, C21.2, C22.2, C29.2, C30.2, C32.1, C33.1, C34.1, C35.1, C36.6, C40.1, R4.1, R7.1, R13.1, R21.1, T1.5 (GND), U4.1 (GND), U4.11 (GND), U6.23 (GND), U6.25 (GND), U8.17, U8.18, U8.19, U8.20
PB_RESET: C36.7, U6.18 (RST/PA28)
PB_SCL0: C40.3, U6.12 (SCL/S01/AS21/AIN7/CMP1/PA15)
PB_SCL1: R23.1, U6.16 (SCL/S11/AS21/PA23), U8.6
PB_SDA0: C40.2, U6.11 (NMI/SDA/S00/AS20/AIN6/CMP0/PA14)
PB_SDA1: R22.1, U6.15 (SDA/S10/AS20/PA22), U8.5
PB_SWCLK: C36.5, U6.19 (SWCLK/S10/AS12/PA30)
PB_SWDIO: C36.4, U6.20 (SWDIO/S11/AS13/PA31)
PB_USBDM: C36.3, U6.21 (USBDM/S12/AS22/PA24)
PB_USBDP: C36.2, U6.22 (USBDP/S13/AS23/PA25)
PB_VBATT: C19.1, C20.1, L2.1, T1.9 (VIN), U8.7, U8.8, U8.9, U8.10
PB_VRAW: U8.16
PB_V_MOT_UNSENSE: C30.1, U4.7 (OUT), U4.8 (OUT), U4.9 (OUT), U8.1, U8.2, U8.3, U8.4
PB_WARN: U6.6 (S01/AS03/ACIN3/AIN5/PA07), U8.15
RESET: AR1.7, C8.1, C28.7, R3.1, U1.26 (RESET)
RFN: C5.1, U1.13 (RFN)
RFP: C6.2, U1.12 (RFP)
SCL_LV: AR1.5, C26.2, C27.2, U1.10 (PA09), U3.2 (SCL/SPC)
SDA_LV: AR1.6, C26.3, C27.3, U1.9 (PA08), U3.4 (SDA/SDI/SDO)
SWCLK: C28.4, U1.31 (PA30)
SWDIO: C28.5, C28.6, U1.32 (PA31)
UB_3V3: C41.2, C43.1, J1.1 (VTG), U11.5 (OUT)
UB_GND: C41.1, C41.10, C41.11, C42.2, C43.2, J1.3 (GND), U10.5 (GND), U11.2 (GND), U11.4
UB_RESET: C41.4, J1.10 (RESET)
UB_SWCLK: C41.7, J1.4 (SWDCLK)
UB_SWDIO: C41.5, C41.6, J1.2 (SWDIO)
VDDANA: C10.1, C11.1, L1.1, U1.4 (VDDANA)
VDDCORE: C14.1, U1.29 (VDDCORE)
VMOT0: C31.2, R16.1, U5.11 (IN-1)
VMOT1: C31.5, R15.1, U5.14 (IN-2)
VMOT2: C31.8, R14.1, U5.1 (IN-3)
XIN: C1.1, U1.1 (XTAL2), X1.1
XOUT: C2.2, U1.2 (XTAL2), X1.3
~FAULT~: R8.1, U4.10 (~FAULT), U6.14 (S13/AS23/PA17)

Notes on the sheet:
VDDIO
VDDIN

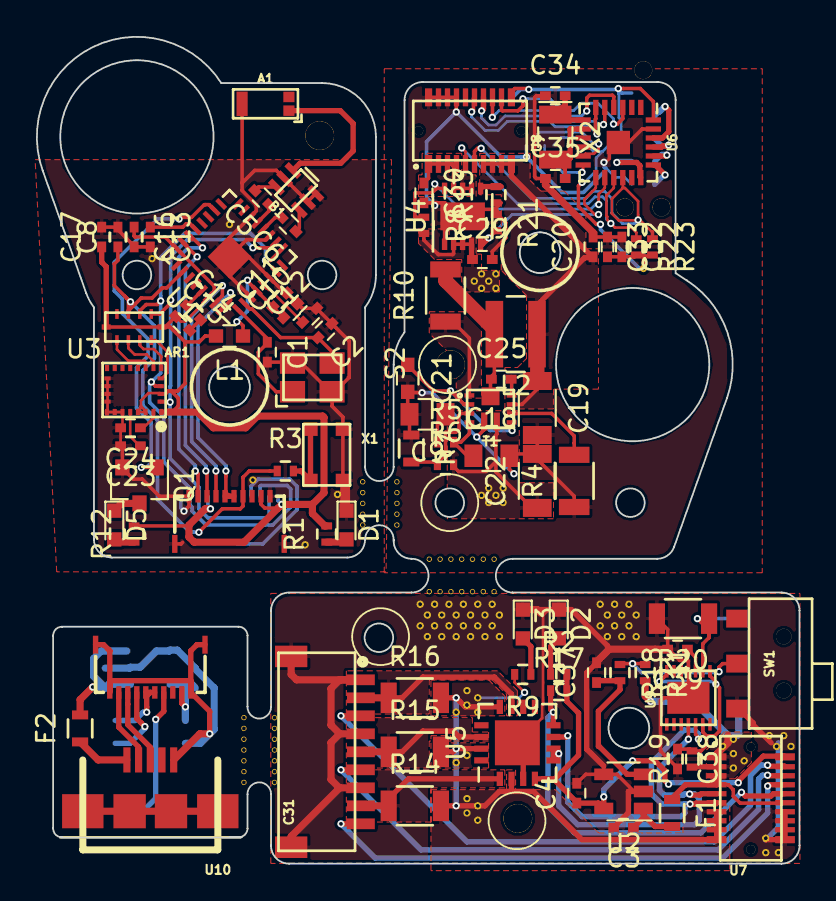
[picture p29: board R21_Core.kicad_pcb from above]

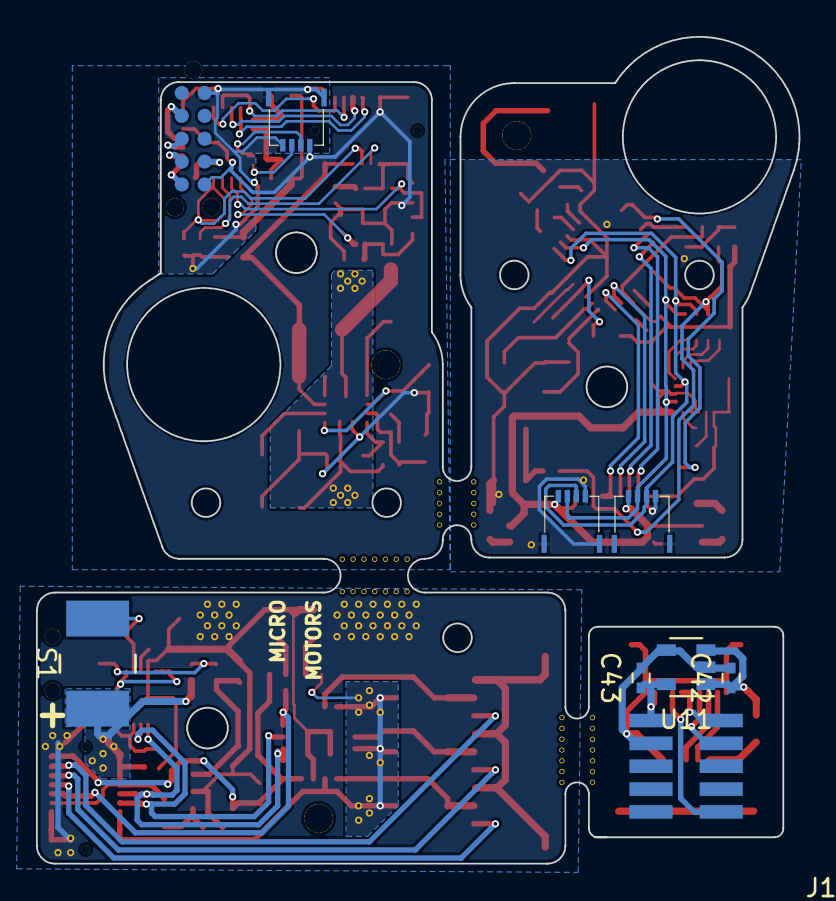
[picture p30: board R21_Core.kicad_pcb from below]

Board: 2 copper layers, 42.4 x 45.9 mm, 95 parts (9 on the bottom side), 92 nets.
