dcellucci/MiniMOJO/hw/PCB/KICAD/D11D_Programmer_Adapter/D11D_Programmer_Adapter.kicad_pcb

## KiCad design hw/PCB/KICAD/D11D_Programmer_Adapter/D11D_Programmer_Adapter.kicad_pcb (2017-02-22)

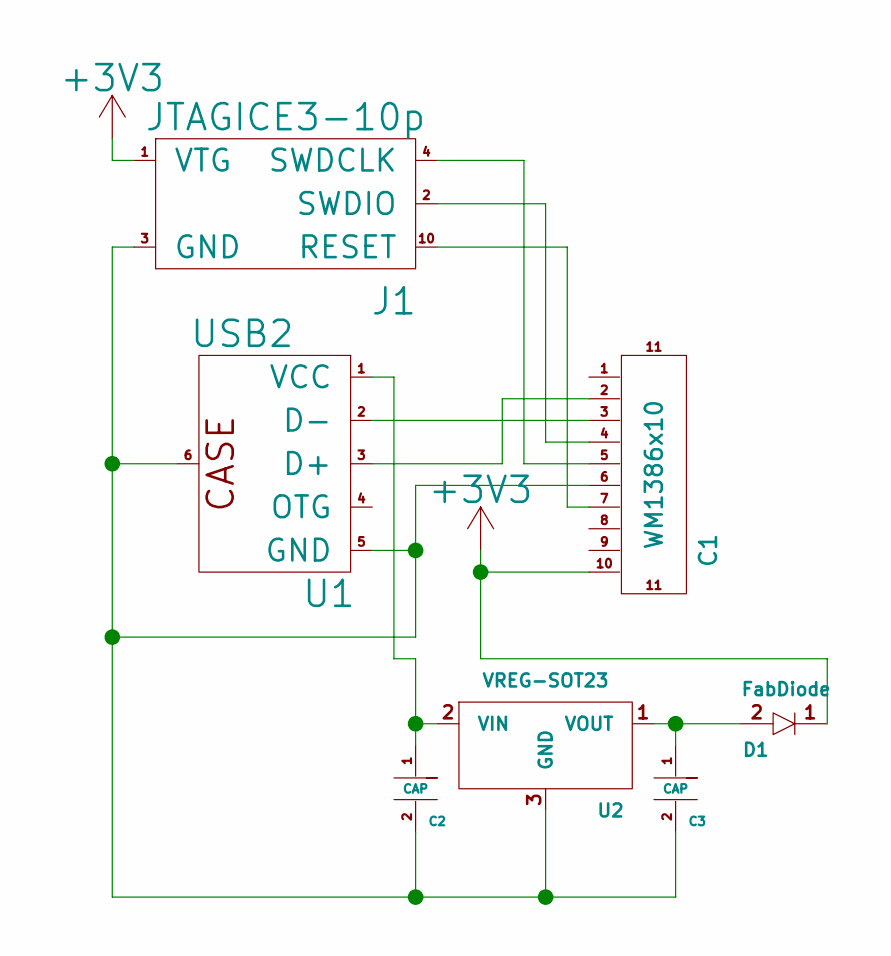
[picture p31: schematic D11D_Programmer_Adapter.sch]

Parts:
C1: WM1386x10; SMD-Header-5x2
C2, C3: CAP; CAP_1206_FAB
D1: FabDiode; LED_1206_FAB
J1: JTAGICE3-10p
U1: USB2; USBMINIB2.0
U2: VREG-SOT23; SOT-23

Connections:
+3V3: C1.10, D1.1, J1.1 (VTG)
unnamed: C1.2, U1.3 (D+)
unnamed: C1.3, U1.2 (D-)
unnamed: C1.4, J1.2 (SWDIO)
unnamed: C1.5, J1.4 (SWDCLK)
unnamed: C1.6, C2.2, C3.2, J1.3 (GND), U1.5 (GND), U1.6, U2.3 (GND)
unnamed: C1.7, J1.10 (RESET)
unnamed: C2.1, U1.1 (VCC), U2.2 (VIN)
unnamed: C3.1, D1.2, U2.1 (VOUT)

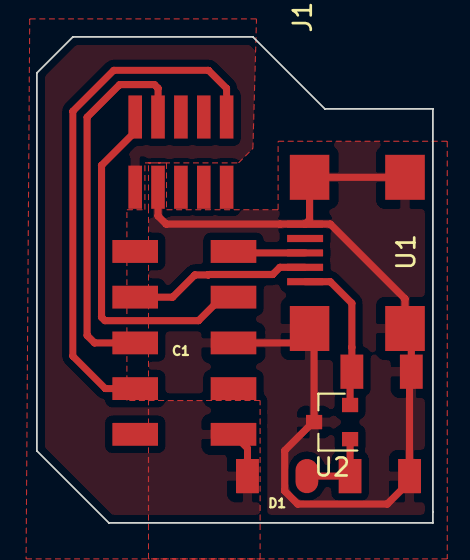
[picture p32: board D11D_Programmer_Adapter.kicad_pcb from above]

Board: 2 copper layers, 22.0 x 27.0 mm, 7 parts (0 on the bottom side), 9 nets.
