dcellucci/MiniMOJO/hw/PCB/EAGLE/MiniMojo_Control_Boards/ATMEGA328_core/MM2_plates.brd

## EAGLE design hw/PCB/EAGLE/MiniMojo_Control_Boards/ATMEGA328_core/MM2_plates.brd (2016-08-29)

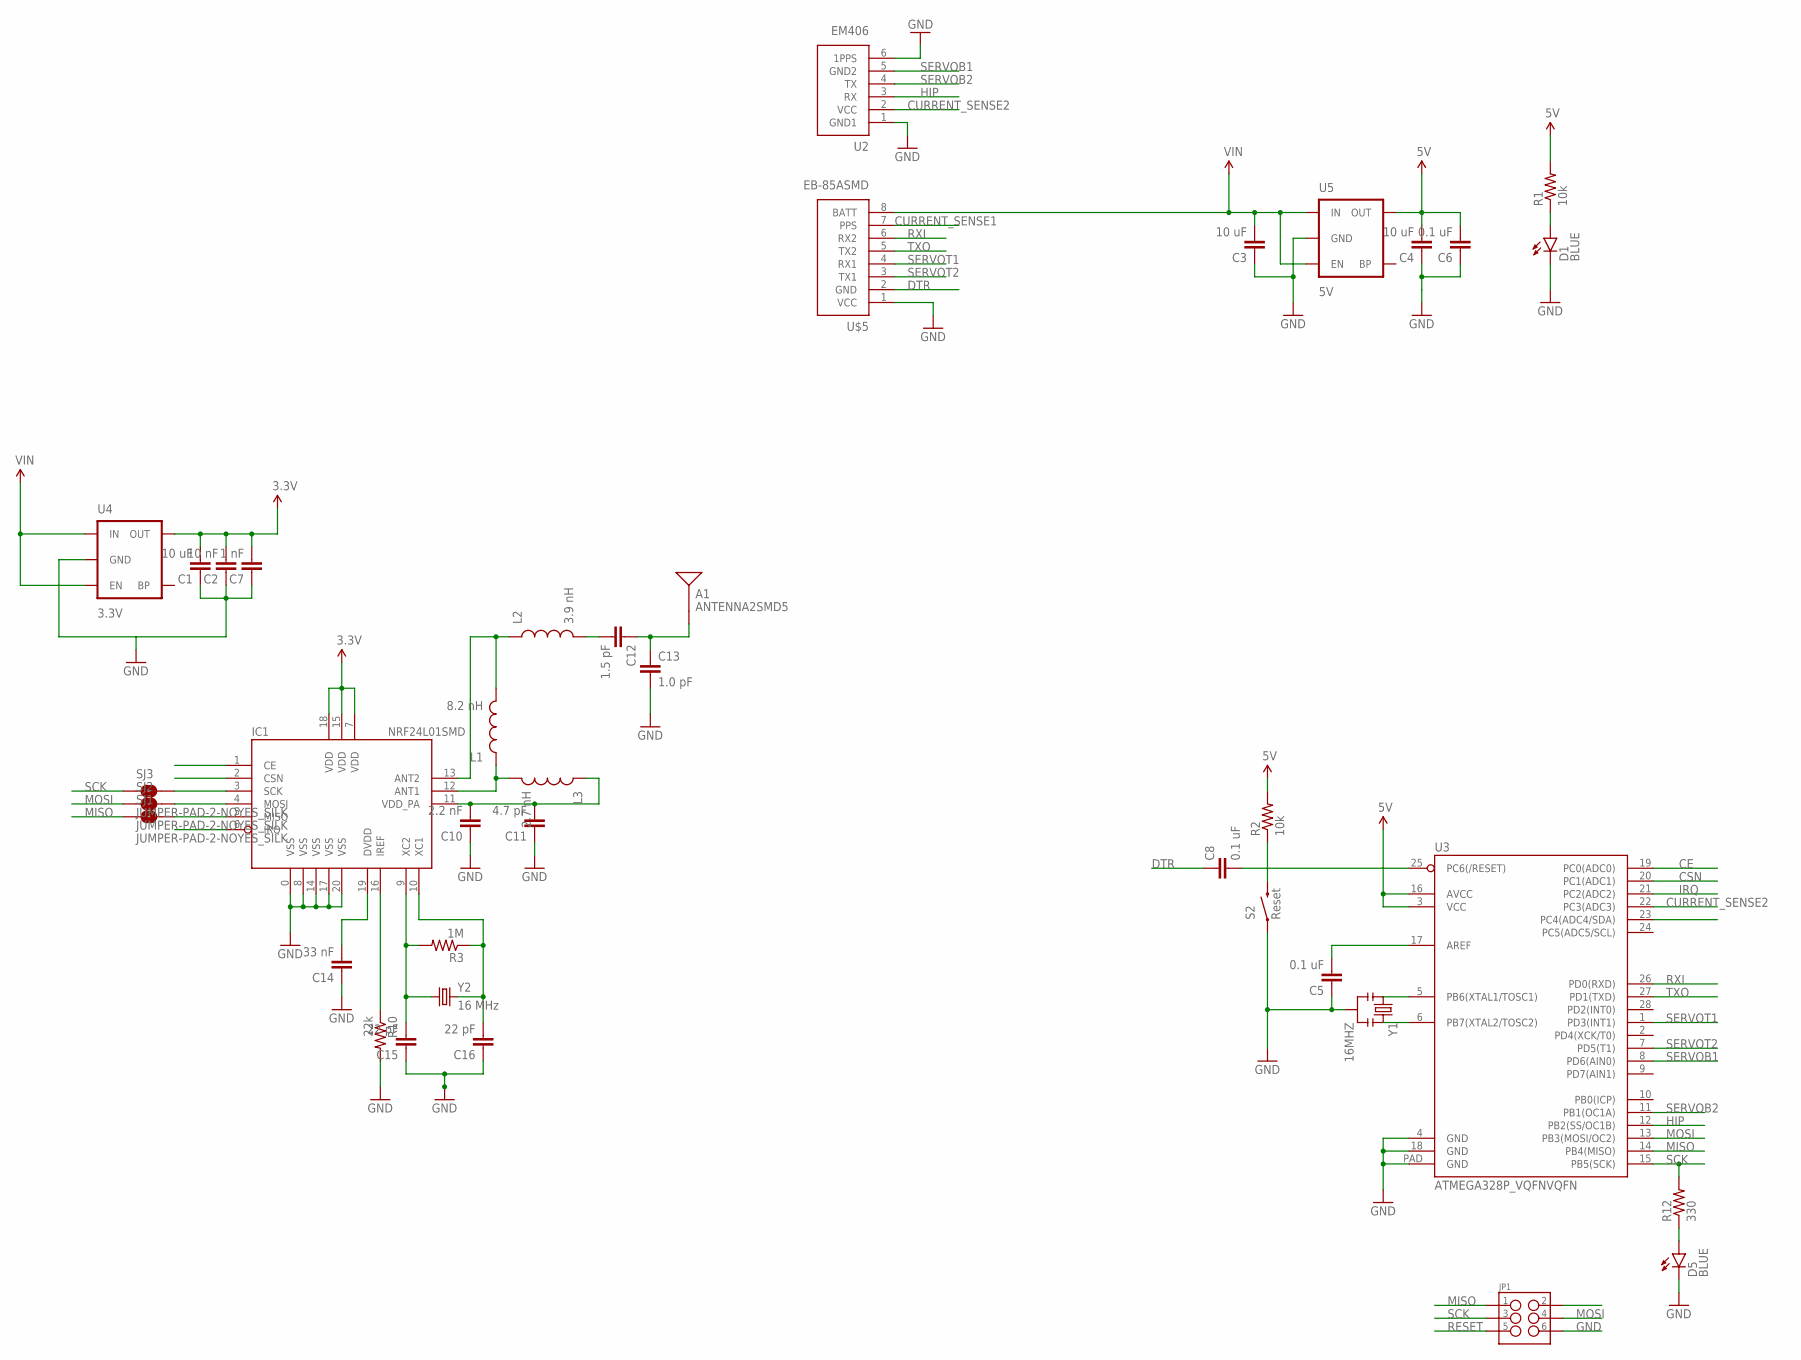
[picture p33: schematic MM2_plates.sch]

Parts:
A1: ANTENNA2SMD5; ANTENNA-CHIP5
C1, C3, C4: 10 uF; 0402-CAP
C2: 10 nF; 0402-CAP
C5, C6, C8: 0.1 uF; 0402-CAP
C7: 1 nF; 0402-CAP
C10: 2.2 nF; 0402-CAP
C11: 4.7 pF; 0402-CAP
C12: 1.5 pF; 0402-CAP
C13: 1.0 pF; 0402-CAP
C14: 33 nF; 0402-CAP
C15, C16: 22 pF; 0402-CAP
D1, D5: BLUE; LED-0603
IC1: NRF24L01SMD; QFN20
JP1: M03X2FEMALE_SMD; 2X3_SMD
L1: 8.2 nH; C0402
L2: 3.9 nH; C0402
L3: 2.7 nH; C0402
R1, R2: 10k; 0402-RES
R3: 1M; 0402-RES
R10: 22k; 0402-RES
R12: 330; 0402-RES
S2: Reset; TACTILE_SWITCH_SMD_4.6X2.8MM
SJ1, SJ2, SJ3: JUMPER-PAD-2-NOYES_SILK; PAD-JUMPER-2-NO_YES_SILK
U2: EM406
U3: ATMEGA328P_VQFNVQFN; VQFN-28
U4: 3.3V; SOT23-5
U5: 5V; SOT23-5
U$5: EB-85ASMD; EB-85A
Y1: 16MHZ; RESONATOR-SMD
Y2: 16 MHz; CRYSTAL-SMD-5X3

Connections:
3.3V: C1.2, C2.2, C7.2, IC1.7 (VDD), IC1.15 (VDD), IC1.18 (VDD), U4.5 (OUT)
5V: C4.2, C6.2, JP1.2, R1.2, R2.2, U3.3 (VCC), U3.16 (AVCC), U5.5 (OUT)
CE: IC1.1 (CE), U3.19 (PC0(ADC0))
CSN: IC1.2 (CSN), U3.20 (PC1(ADC1))
CURRENT_SENSE1: U3.23 (PC4(ADC4/SDA)), U$5.7 (PPS)
CURRENT_SENSE2: U2.2 (VCC), U3.22 (PC3(ADC3))
DTR: C8.1, U$5.2 (GND)
GND: C1.1, C2.1, C3.1, C4.1, C5.1, C6.1, C7.1, C10.1, C11.1, C13.2, C14.1, C15.1, C16.1, D1.C, D5.C, IC1.0 (VSS), IC1.8 (VSS), IC1.14 (VSS), IC1.17 (VSS), IC1.20 (VSS), JP1.6, R10.2, S2.1, S2.2 (1), U2.1 (GND1), U2.6 (1PPS), U3.4 (GND), U3.18 (GND), U3.PAD (GND), U4.2 (GND), U5.2 (GND), U$5.1 (VCC), Y1.2
HIP: U2.3 (RX), U3.12 (PB2(SS/OC1B))
IRQ: IC1.6 (IRQ), U3.21 (PC2(ADC2))
MISO: JP1.1, SJ1.1, U3.14 (PB4(MISO))
MOSI: JP1.4, SJ2.1, U3.13 (PB3(MOSI/OC2))
unnamed: U3.5 (PB6(XTAL1/TOSC1)), Y1.1
unnamed: U3.6 (PB7(XTAL2/TOSC2)), Y1.3
unnamed: D1.A, R1.1
unnamed: IC1.12 (ANT1), L1.1, L3.2
unnamed: C5.2, U3.17 (AREF)
unnamed: IC1.13 (ANT2), L1.2, L2.1
unnamed: C12.2, L2.2
unnamed: D5.A, R12.1
unnamed: A1.FEED, C12.1, C13.1
unnamed: IC1.3 (SCK), SJ3.2
unnamed: C10.2, C11.2, IC1.11 (VDD_PA), L3.1
unnamed: C14.2, IC1.19 (DVDD)
unnamed: IC1.16 (IREF), R10.1
unnamed: IC1.4 (MOSI), SJ2.2
unnamed: C15.2, IC1.9 (XC2), R3.2, Y2.1
unnamed: C16.2, IC1.10 (XC1), R3.1, Y2.3 (2)
unnamed: IC1.5 (MISO), SJ1.2
RESET: C8.2, JP1.5, R2.1, S2.3 (2), S2.4 (2), U3.25 (PC6(/RESET))
RXI: U3.26 (PD0(RXD)), U$5.6 (RX2)
SCK: JP1.3, R12.2, SJ3.1, U3.15 (PB5(SCK))
SERVOB1: U2.5 (GND2), U3.8 (PD6(AIN0))
SERVOB2: U2.4 (TX), U3.11 (PB1(OC1A))
SERVOT1: U3.1 (PD3(INT1)), U$5.4 (RX1)
SERVOT2: U3.7 (PD5(T1)), U$5.3 (TX1)
TXO: U3.27 (PD1(TXD)), U$5.5 (TX2)
VIN: C3.2, U4.1 (IN), U4.3 (EN), U5.1 (IN), U5.3 (EN), U$5.8 (BATT)

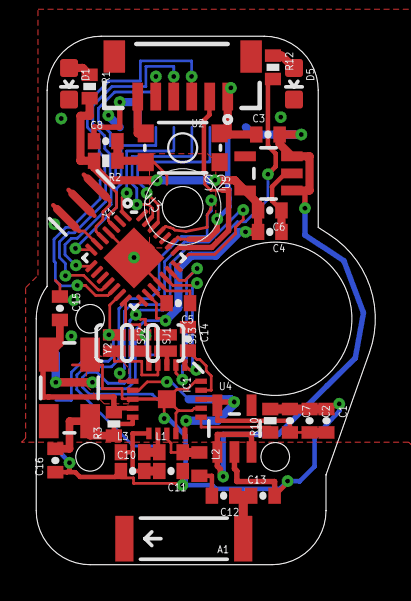
[picture p34: board hw/PCB/EAGLE/MiniMojo_Control_Boards/ATMEGA328_core/MM2_plates.brd from above]

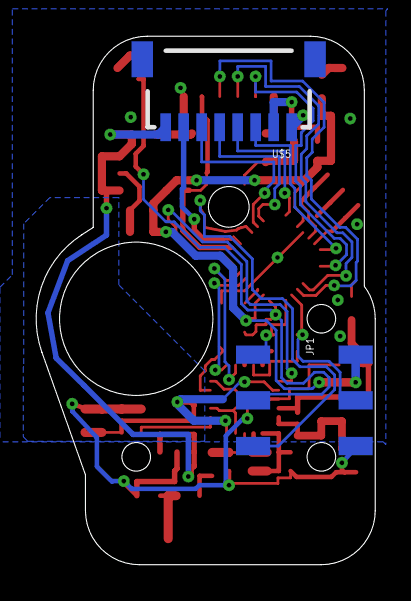
[picture p35: board hw/PCB/EAGLE/MiniMojo_Control_Boards/ATMEGA328_core/MM2_plates.brd from below]

Board: 2 copper layers, 18.8 x 29.4 mm, 39 parts (2 on the bottom side), 38 nets.
