dcellucci/MiniMOJO/hw/PCB/EAGLE/MiniMojo_Control_Boards/ATSAMR18_core/MM2_plates.brd

## EAGLE design hw/PCB/EAGLE/MiniMojo_Control_Boards/ATSAMR18_core/MM2_plates.brd (2016-09-23)

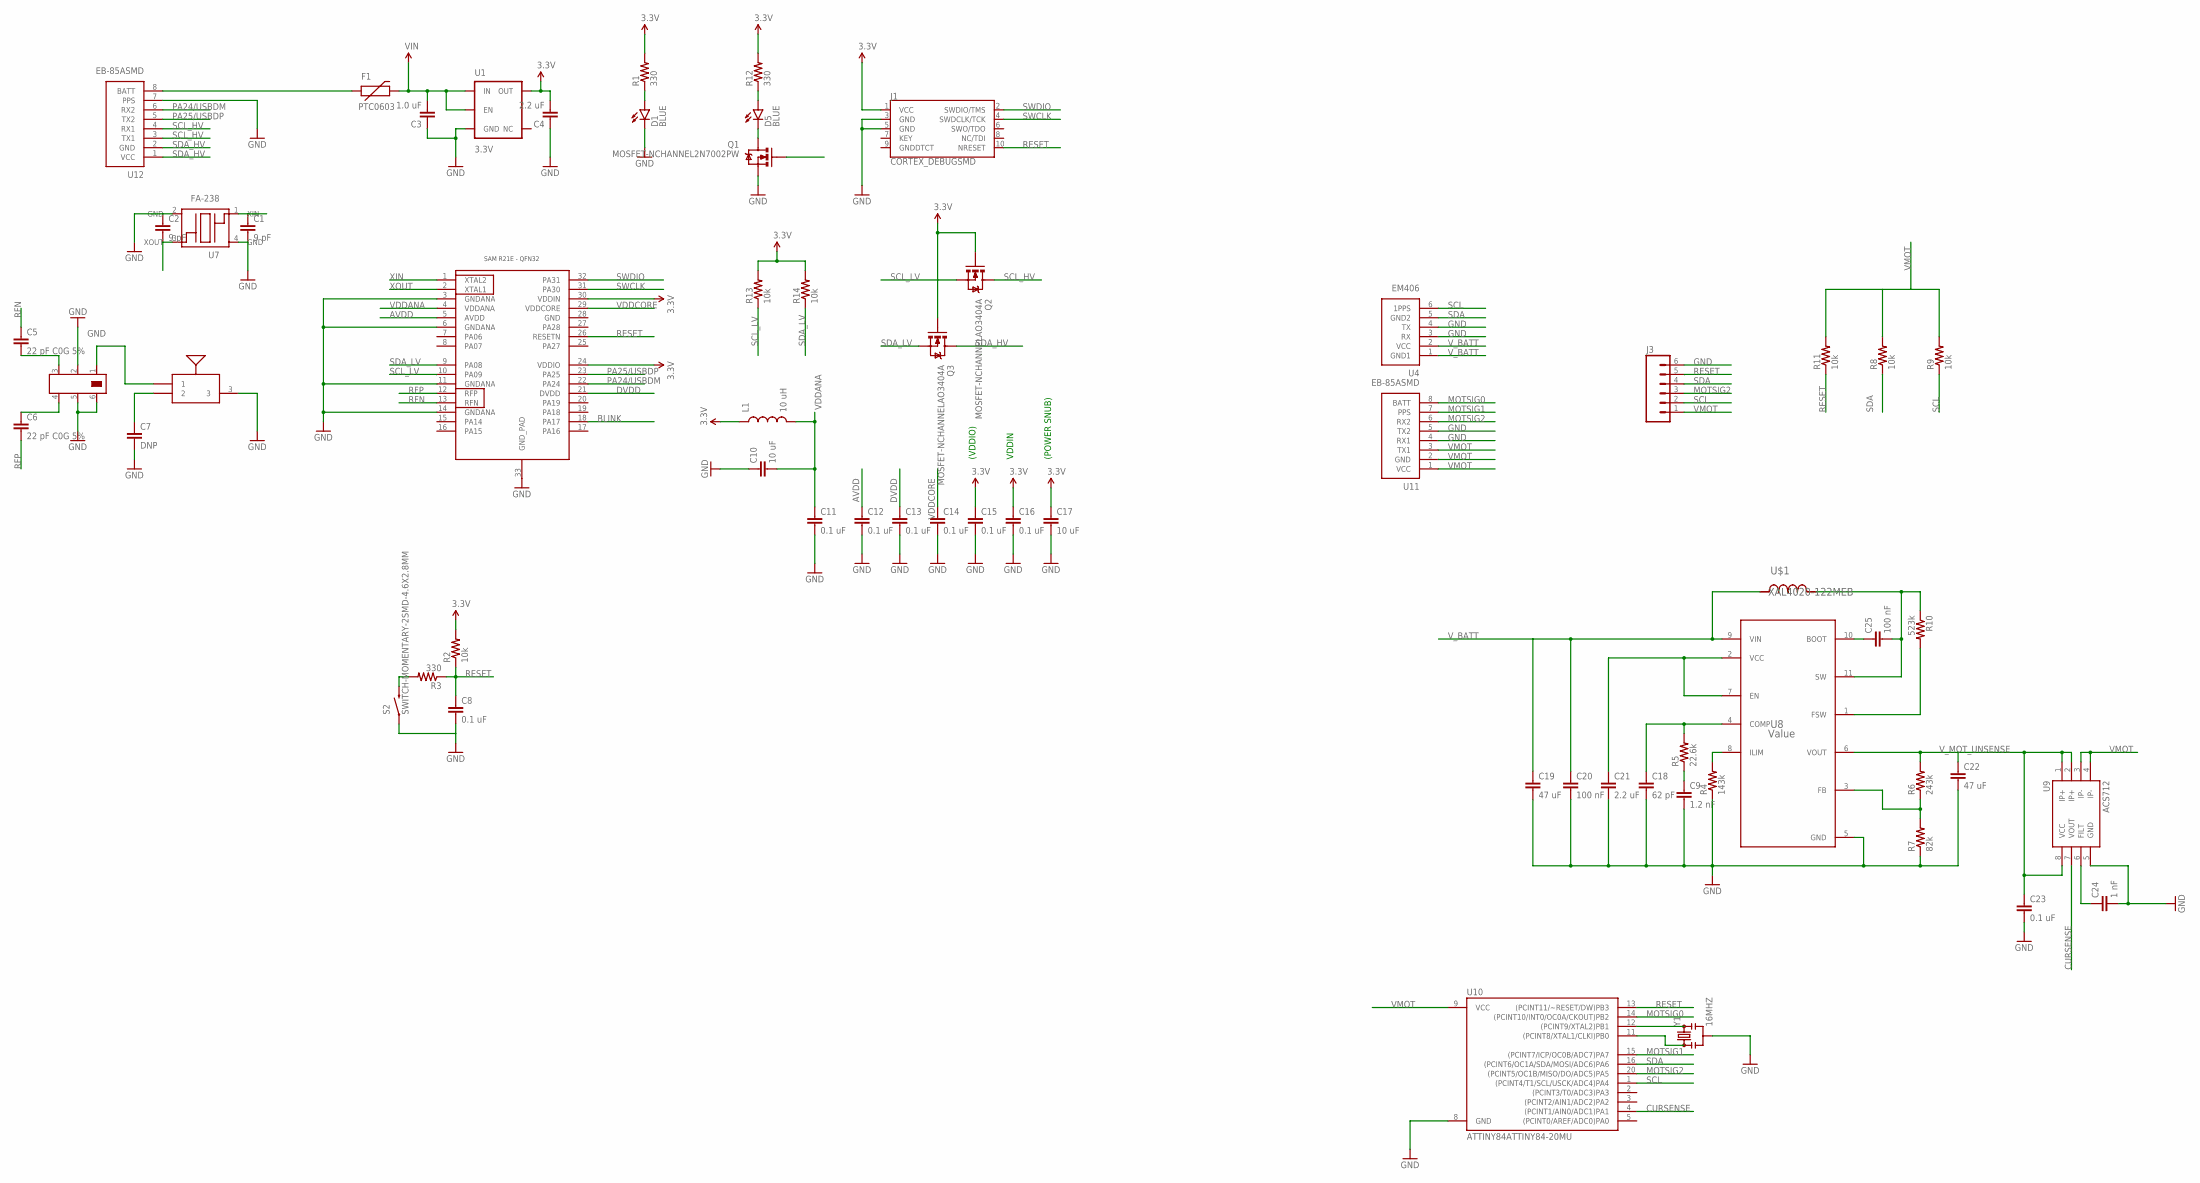
[picture p36: schematic MM2_plates.sch]

Parts:
C1, C2: 9 pF; 0402-CAP
C3: 1.0 uF; 0402-CAP
C4: 2.2 uF; 0402-CAP
C5, C6: 22 pF C0G 5%; 0402-CAP
C7: DNP; 0402-CAP
C8, C11, C12, C13, C14, C15, C16, C23: 0.1 uF; 0402-CAP
C9: 1.2 nF; 0805
C10, C17: 10 uF; 0402-CAP
C18: 62 pF; 0805
C19, C22: 47 uF; 1206
C20, C25: 100 nF; 0402-CAP
C21: 2.2 uF; 0603-CAP
C24: 1 nF; 0402-CAP
D1, D5: BLUE; LED-0603
F1: PTC0603; 0603
J1: CORTEX_DEBUGSMD; SAMTECH_FTSH-105-01
J3: M06SMD-1MM; 1X06-1MM
L1: 10 uH; 0603
Q1: MOSFET-NCHANNEL2N7002PW; SOT323
Q2, Q3: MOSFET-NCHANNELAO3404A; SOT23-3
R1, R3, R12: 330; 0402-RES
R2, R8, R9, R11, R13, R14: 10k; 0402-RES
R4: 143k; 1206
R5: 22.6k; 0402-RES
R6: 243k; 0402-RES
R7: 82k; 0603-RES
R10: 523k; 1206
S2: SWITCH-MOMENTARY-2SMD-4.6X2.8MM; TACTILE_SWITCH_SMD_4.6X2.8MM
U1: 3.3V; SOT23-5
U2: ATSAMR21E18A-MUT; QFN32
U4: EM406
U5: PULSE_ANT_2.4GHZ; ANT_BAR
U6: JOHANSON_2450BM15A0015E; 0805_BALUN
U7: FA-238
U8: Value; RNR0011A
U9: ACS712; SO08
U10: ATTINY84ATTINY84-20MU; QFN20
U11, U12: EB-85ASMD; EB-85A
U$1: XAL4020-122MEB; XAL4020
Y1: 16MHZ; RESONATOR-SMD

Connections:
3.3V: C4.2, C15.1, C16.1, C17.1, J1.1 (VCC), L1.1, Q2.1 (G), Q3.1 (G), R1.2, R2.2, R12.2, R13.2, R14.2, U1.5 (OUT), U2.24 (VDDIO), U2.30 (VDDIN)
AVDD: C12.1, U2.5 (AVDD)
BLINK: Q1.1 (G), U2.18 (PA17)
CURSENSE: U9.7 (VOUT), U10.4 ((PCINT1/AIN0/ADC1)PA1)
DVDD: C13.1, U2.21 (DVDD)
GND: C1.2, C2.1, C3.1, C4.1, C7.2, C8.2, C9.2, C10.1, C11.2, C12.2, C13.2, C14.2, C15.2, C16.2, C17.2, C18.2, C19.2, C20.2, C21.2, C22.2, C23.2, C24.2, D1.C, J1.3 (GND), J1.5 (GND), J3.6, Q1.2 (S), R4.1, R7.1, S2.1, S2.2 (1), U1.2 (GND), U2.3 (GNDANA), U2.6 (GNDANA), U2.11 (GNDANA), U2.14 (GNDANA), U2.33 (GND_PAD), U4.3 (RX), U4.4 (TX), U5.3, U6.2, U6.5, U6.6, U7.2 (GND), U7.4 (GND), U8.5 (GND), U9.5 (GND), U10.8 (GND), U11.4 (RX1), U11.5 (TX2), U12.7 (PPS), Y1.2
MOTSIG0: U10.14 ((PCINT10/INT0/OC0A/CKOUT)PB2), U11.8 (BATT)
MOTSIG1: U10.15 ((PCINT7/ICP/OC0B/ADC7)PA7), U11.7 (PPS)
MOTSIG2: J3.3, U10.20 ((PCINT5/OC1B/MISO/DO/ADC5)PA5), U11.6 (RX2)
unnamed: F1.1, U12.8 (BATT)
unnamed: R3.2, S2.3 (2), S2.4 (2)
unnamed: R4.2, U8.8 (ILIM)
unnamed: U10.12 ((PCINT9/XTAL2)PB1), Y1.3
unnamed: U10.11 ((PCINT8/XTAL1/CLKI)PB0), Y1.1
unnamed: U5.1, U6.1
unnamed: C7.1, U5.2
unnamed: D1.A, R1.1
unnamed: C5.2, U6.3
unnamed: C6.1, U6.4
unnamed: C9.1, R5.1
unnamed: C18.1, R5.2, U8.4 (COMP)
unnamed: C24.1, U9.6 (FILT)
unnamed: C21.1, U8.2 (VCC), U8.7 (EN)
unnamed: D5.A, R12.1
unnamed: D5.C, Q1.3 (D)
unnamed: C25.1, U8.10 (BOOT)
unnamed: C25.2, R10.1, U8.11 (SW), U$1.2
unnamed: R10.2, U8.1 (FSW)
unnamed: R6.1, R7.2, U8.3 (FB)
PA24/USBDM: U2.22 (PA24), U12.6 (RX2)
PA25/USBDP: U2.23 (PA25), U12.5 (TX2)
RESET: C8.1, J1.10 (NRESET), J3.5, R2.1, R3.1, R11.1, U2.26 (RESETN), U10.13 ((PCINT11/~RESET/DW)PB3)
RFN: C5.1, U2.13 (RFN)
RFP: C6.2, U2.12 (RFP)
SCL: J3.2, R9.1, U4.6 (1PPS), U10.1 ((PCINT4/T1/SCL/USCK/ADC4)PA4)
SCL_HV: Q2.3 (D), U12.3 (TX1), U12.4 (RX1)
SCL_LV: Q2.2 (S), R13.1, U2.10 (PA09)
SDA: J3.4, R8.1, U4.5 (GND2), U10.16 ((PCINT6/OC1A/SDA/MOSI/ADC6)PA6)
SDA_HV: Q3.3 (D), U12.1 (VCC), U12.2 (GND)
SDA_LV: Q3.2 (S), R14.1, U2.9 (PA08)
SWCLK: J1.4 (SWDCLK/TCK), U2.31 (PA30)
SWDIO: J1.2 (SWDIO/TMS), U2.32 (PA31)
VDDANA: C10.2, C11.1, L1.2, U2.4 (VDDANA)
VDDCORE: C14.1, U2.29 (VDDCORE)
VIN: C3.2, F1.2, U1.1 (IN), U1.3 (EN)
VMOT: J3.1, R8.2, R9.2, R11.2, U9.3 (IP-), U9.4 (IP-), U10.9 (VCC), U11.1 (VCC), U11.2 (GND), U11.3 (TX1)
V_BATT: C19.1, C20.1, U4.1 (GND1), U4.2 (VCC), U8.9 (VIN), U$1.1
V_MOT_UNSENSE: C22.1, C23.1, R6.2, U8.6 (VOUT), U9.1 (IP+), U9.2 (IP+), U9.8 (VCC)
XIN: C1.1, U2.1 (XTAL2), U7.1 (XIN)
XOUT: C2.2, U2.2 (XTAL1), U7.3 (XOUT)

Notes on the sheet:
(VDDIO)
VDDIN
(POWER SNUB)

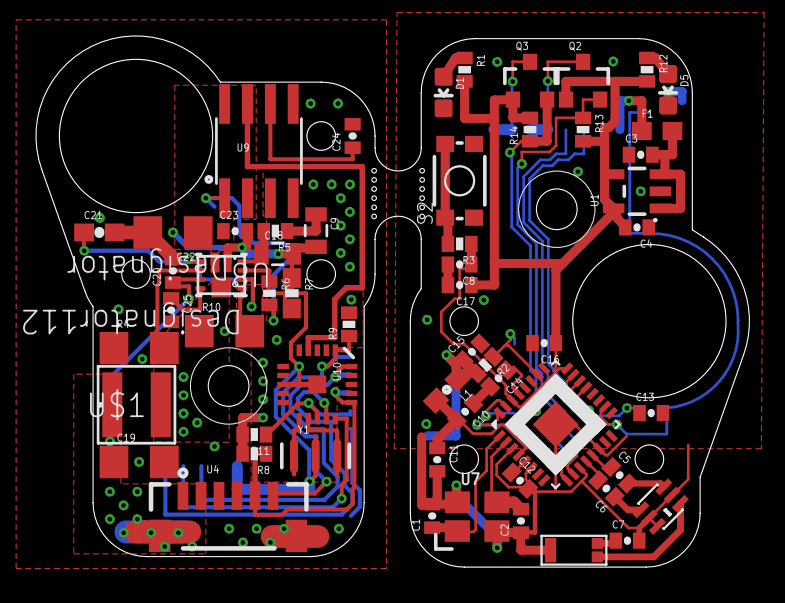
[picture p37: board hw/PCB/EAGLE/MiniMojo_Control_Boards/ATSAMR18_core/MM2_plates.brd from above]

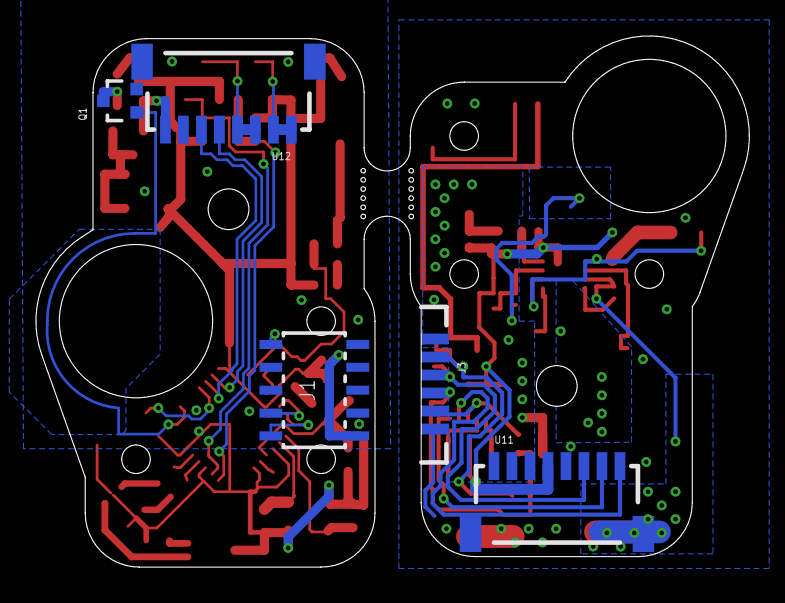
[picture p38: board hw/PCB/EAGLE/MiniMojo_Control_Boards/ATSAMR18_core/MM2_plates.brd from below]

Board: 2 copper layers, 39.6 x 29.5 mm, 62 parts (5 on the bottom side), 50 nets.
