dcellucci/MiniMOJO/hw/PCB/EAGLE/HS5085HD_Test/HS5035HD_Test_841.brd

## EAGLE design hw/PCB/EAGLE/HS5085HD_Test/HS5035HD_Test_841.brd (2016-11-20)

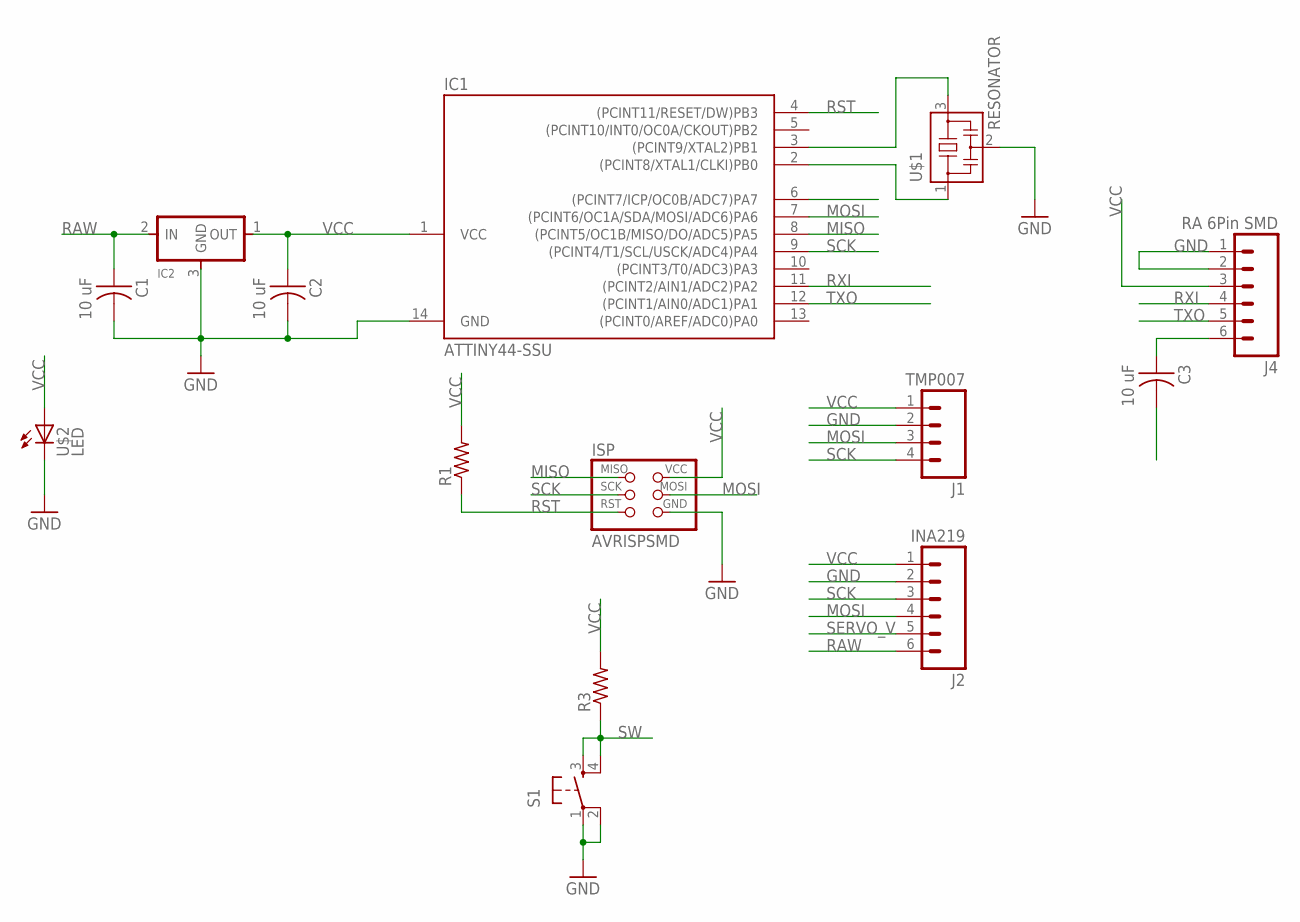
[picture p39: schematic HS5035HD_Test_841.sch]

Parts:
C1, C2, C3: 10 uF; C1206FAB
IC1: ATTINY44-SSU; SOIC14
IC2: REGULATORSOT23; SOT23
ISP: AVRISPSMD; 2X03SMD
J1: TMP007; 1X04-SMD
J2: INA219; 1X06-SMD
J4: RA 6Pin SMD; 1X06-SMD
R1, R3: RES-US1206FAB; R1206FAB
S1: 6MM_SWITCH6MM_SWITCH; 6MM_SWITCH
U$1: RESONATOR; EFOBM
U$2: LED; LED1206

Connections:
GND: C1.2, C2.2, IC1.14 (GND), IC2.3 (GND), ISP.6 (GND), J1.2, J2.2, J4.1, J4.2, S1.1, S1.2 (P1), U$1.2, U$2.2 (C)
MISO: IC1.8 ((PCINT5/OC1B/MISO/DO/ADC5)PA5), ISP.1 (MISO)
MOSI: IC1.7 ((PCINT6/OC1A/SDA/MOSI/ADC6)PA6), ISP.4 (MOSI), J1.3, J2.4
unnamed: IC1.3 ((PCINT9/XTAL2)PB1), U$1.3
unnamed: IC1.2 ((PCINT8/XTAL1/CLKI)PB0), U$1.1
unnamed: C3.1, J4.6
RAW: C1.1, IC2.2 (IN), J2.6
RST: C3.2, IC1.4 ((PCINT11/RESET/DW)PB3), ISP.5 (RST), R1.1
RXI: IC1.11 ((PCINT2/AIN1/ADC2)PA2), J4.4
SCK: IC1.9 ((PCINT4/T1/SCL/USCK/ADC4)PA4), ISP.3 (SCK), J1.4, J2.3
SERVO_V: J2.5
SW: IC1.6 ((PCINT7/ICP/OC0B/ADC7)PA7), R3.1, S1.3 (S), S1.4 (S1)
TXO: IC1.12 ((PCINT1/AIN0/ADC1)PA1), J4.5
VCC: C2.1, IC1.1 (VCC), IC2.1 (OUT), ISP.2 (VCC), J1.1, J2.1, J4.3, R1.2, R3.2, U$2.1 (A)

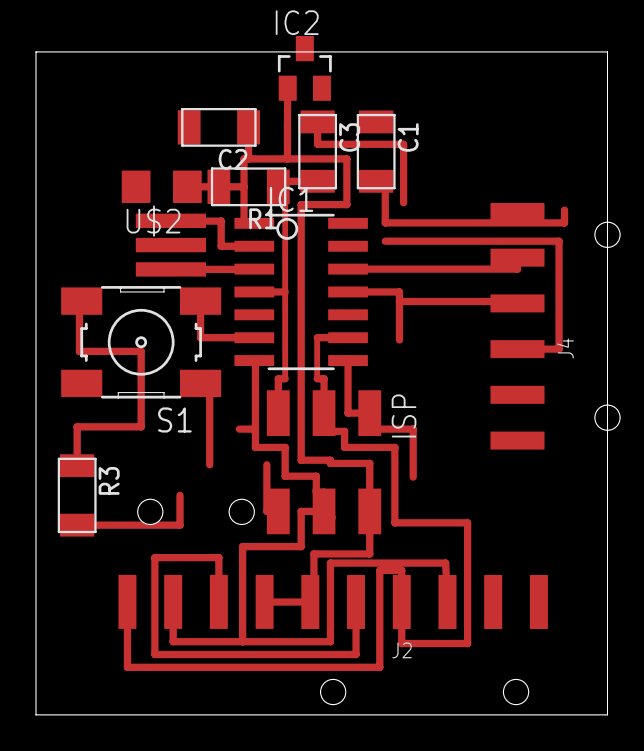
[picture p40: board HS5035HD_Test_841.brd from above]

Board: 2 copper layers, 31.8 x 36.8 mm, 14 parts (0 on the bottom side), 13 nets.
