dcellucci/MiniMOJO/hw/PCB/EAGLE/Prototyping/Tiny841/Tiny841.brd

## EAGLE design hw/PCB/EAGLE/Prototyping/Tiny841/Tiny841.brd (2016-09-23)

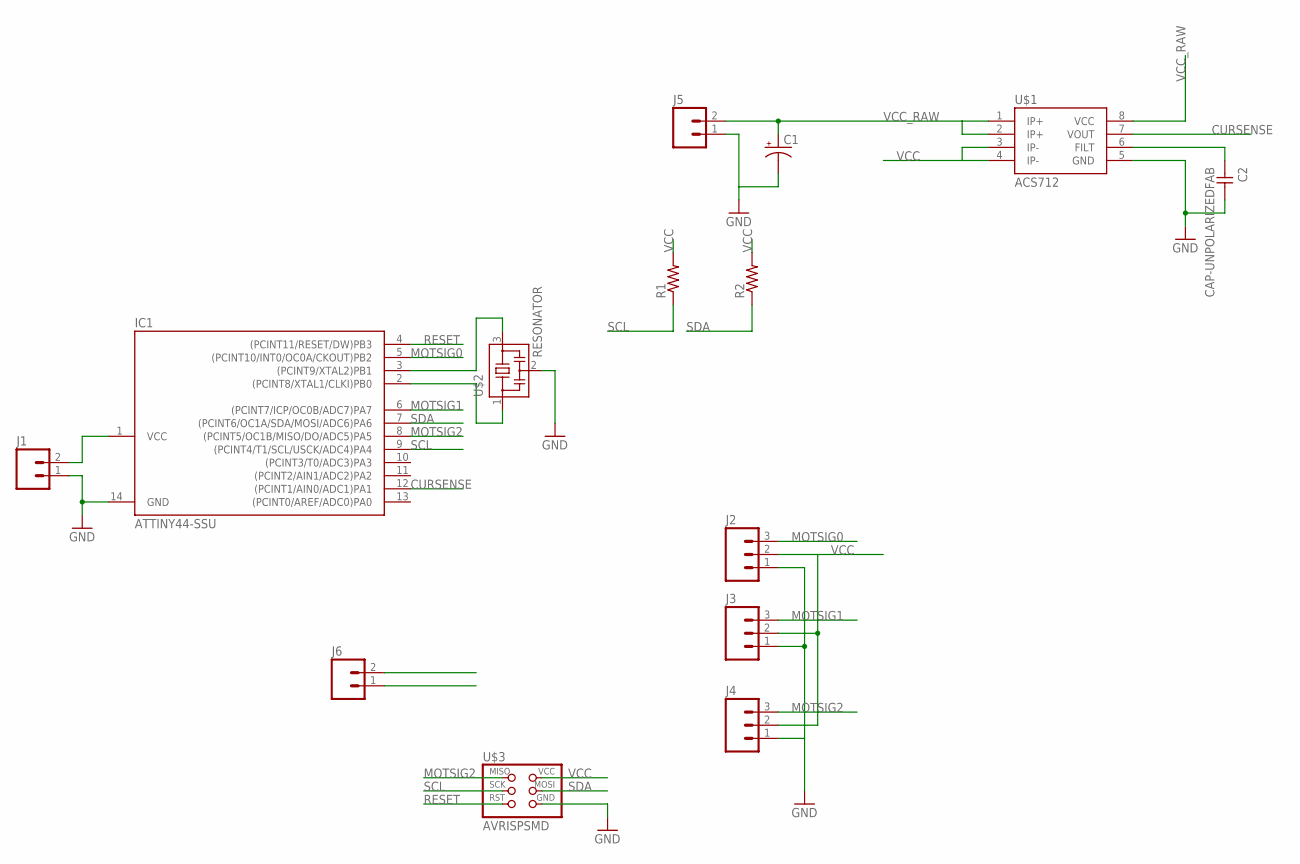
[picture p41: schematic Tiny841.sch]

Parts:
C1: 47UF-50V-20%(ELECT); PANASONIC_D
C2: CAP-UNPOLARIZEDFAB; C1206FAB
IC1: ATTINY44-SSU; SOIC14
J1, J6: M02PTH; 1X02
J2, J3, J4: M03PTH; 1X03
J5: M023.5MM-NO_SILK; SCREWTERMINAL-3.5MM-2-NS
R1, R2: RES-US1206FAB; R1206FAB
U$1: ACS712; SO08
U$2: RESONATOR; EFOBM
U$3: AVRISPSMD; 2X03SMD

Connections:
CURSENSE: IC1.12 ((PCINT1/AIN0/ADC1)PA1), U$1.7 (VOUT)
GND: C1.-, C2.2, IC1.14 (GND), J1.1, J2.1, J3.1, J4.1, J5.1, U$1.5 (GND), U$2.2, U$3.6 (GND)
MOTSIG0: IC1.5 ((PCINT10/INT0/OC0A/CKOUT)PB2), J2.3
MOTSIG1: IC1.6 ((PCINT7/ICP/OC0B/ADC7)PA7), J3.3
MOTSIG2: IC1.8 ((PCINT5/OC1B/MISO/DO/ADC5)PA5), J4.3, U$3.1 (MISO)
unnamed: IC1.3 ((PCINT9/XTAL2)PB1), U$2.3
unnamed: IC1.2 ((PCINT8/XTAL1/CLKI)PB0), U$2.1
unnamed: C2.1, U$1.6 (FILT)
RESET: IC1.4 ((PCINT11/RESET/DW)PB3), U$3.5 (RST)
SCL: IC1.9 ((PCINT4/T1/SCL/USCK/ADC4)PA4), J6.1, R1.1, U$3.3 (SCK)
SDA: IC1.7 ((PCINT6/OC1A/SDA/MOSI/ADC6)PA6), J6.2, R2.1, U$3.4 (MOSI)
VCC: IC1.1 (VCC), J1.2, J2.2, J3.2, J4.2, R1.2, R2.2, U$1.3 (IP-), U$1.4 (IP-), U$3.2 (VCC)
VCC_RAW: C1.+, J5.2, U$1.1 (IP+), U$1.2 (IP+), U$1.8 (VCC)

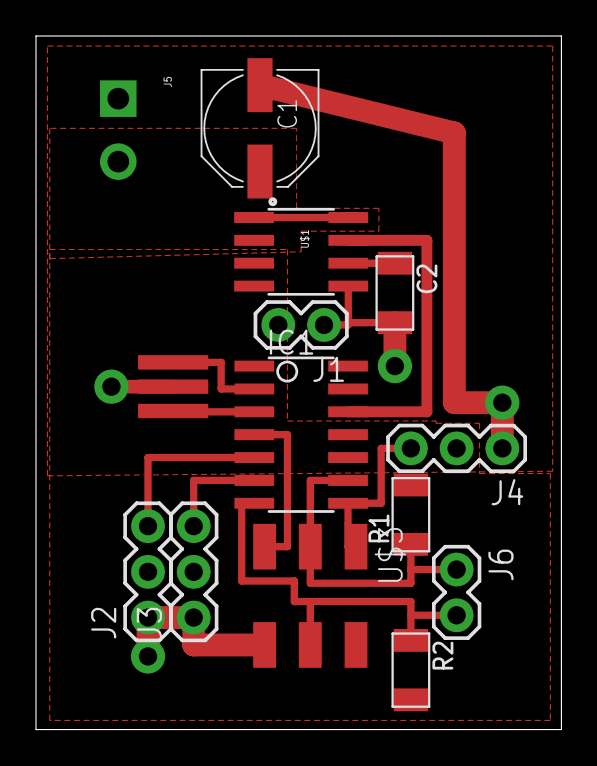
[picture p42: board Tiny841.brd from above]

Board: 2 copper layers, 29.2 x 38.5 mm, 14 parts (0 on the bottom side), 13 nets.
