dcellucci/MiniMOJO/hw/PCB/EAGLE/MiniMojo_Control_Boards/TPS61089RNRR_4.8V/Eagle/2016-09-01_11-38-00/2016-09-01_11-38-00.sch

## EAGLE design hw/PCB/EAGLE/MiniMojo_Control_Boards/TPS61089RNRR_4.8V/Eagle/2016-09-01_11-38-00/2016-09-01_11-38-00.sch (2016-09-23)

Schematic: 2016-09-01_11-38-00.sch

Parts:
GND1: WB_GND
L1: 820nH; IHLP-2020CZ
U1: TPS61089RNRR; RNR0011A
