dcellucci/MiniMOJO/(commit log)

2016-08-25 Added Gear Generation notes
2016-08-26 Added CAD files of MOJO
2016-08-29 updated CAD, added Eagle Boards (ATSAM and ATMEGA)
    [20160731_MM2_BOM.xls, 20160811_MM2_plates_BOM2.xlsx, MM2_plates.brd, MM2_plates.sch]
2016-08-30 Made TPS61089 mods
    [MM2_plates.sch]
2016-09-02 added TPS61089 w/ Tiny841
    [2016-09-01_11-38-00.sch, 20160901_MMPLATES.brd, 20160901_MMPLATES.sch, MM2_plates.brd, MM2_plates.sch, MM_bom_SC.xls, TA_bom.xlsx]
2016-09-02 Added finished 841 schematic
    [20160901_MMPLATES_centroid.csv, Tiny841.brd, Tiny841.sch]
2016-09-03 added full 841 board
    [Tiny841.brd, Tiny841.sch]
2016-09-07 added new arms, control code
    [20160904_newgear_27PA_20T.dxf, 20160906_MM_Plate_Outline.3dm, gg_gear N17 D10.28 P1.65 PA20 @100.dxf]
2016-09-23 too long since commiting...
    [gg_gear_14t_PA20.dxf]
2016-09-23 removed 3dm's (because they're huge)
    [20160906_MM_Plate_Outline.3dm]
2016-09-24 Added spline pattern
    [20160924_MM_Spline_Adapter.dxf]
2016-09-24 updated hub drawing
    [20160924_MM_Spline_Adapter.dxf]
2016-11-15 post 0g
    [20161014_TA_bom.xlsx, MM2_plates.brd, MM2_plates.sch, TA_bom.xlsx]
2016-11-15 Added current reading output parsing
2016-11-16 Changed servo order to appease people
2016-11-20 Test Stand models
    [HS5035HD-Tester.kicad_pcb, HS5035HD-Tester.sch, HS5035HD.FCStd, HS5035HD_Test_841.brd, HS5035HD_Test_841.sch, Test_Stand.FCStd]
2016-11-21 Added Fab Modules UI
    [2016-09-01_11-38-00.sch, 20160731_MM2_BOM.xls, 20160811_MM2_plates_BOM2.xlsx, 20160901_MMPLATES.brd, 20160901_MMPLATES.sch, 20160901_MMPLATES_centroid.csv, 20161014_TA_bom.xlsx, 20161120_700g_100P_ColdStartTest_C.csv]
2017-02-09 Rev 3 MM boards and Migration to KICAD
    [20170201_Plates_BotHoles_Closer.dxf, MM2_plates.sch, R21_Core.kicad_pcb, R21_Core.sch, R21_Core2.sch, R21_Core_BOM.xlsx, TA_bom.xlsx]
2017-02-09 Added annotated platecad
    [R21_Core_BOM.xlsx]
2017-02-10 ATSAMD11_Core layout using KiCAD
    [ATSAMD11_Core.kicad_pcb, ATSAMD11_Core.sch]
2017-02-11 Added hex spacer, reorganized CAD modules
    [20160924_MM_Spline_Adapter.dxf, 20161017_MM_TopHole_DWC.stp, 20170201_Plates_BotHoles_Closer.dxf, 20170210_DWC_Outer_Arms_ANNOTATED.dxf]
2017-02-11 Added board stack spacer
    [20170211_Board_Stack_Spacer.stp]
2017-02-16 Added stp files for updated MM components
    [20170210_DWC_Outer_Arms_ANNOTATED.dxf, INJMOLD_GLOVE.stp, Outer_Arms_Bearing.stp, R21_Core_BOM.xlsx]
2017-02-22 long time since commit
    [D11D_Programmer_Adapter.kicad_pcb, D11D_Programmer_Adapter.sch, R21_Core_BOM.xlsx]
2017-02-23 added include wire statement
2017-02-23 Added serial javascript files
    [20160731_MM2_BOM.xls]
2017-02-27 Lots of changes- firmware, board rev, mods
    [R21_Core.kicad_pcb, R21_Core.sch]
2017-02-28 Added addendum to boards, modules for debug, comms description
    [R21_Core.kicad_pcb, R21_Core.sch]
2017-03-06 Added IK input information
    [20170304_Plates_Drill_Jig.dxf]
2017-03-17 updated websocket for windows; working power mon and data logger
2017-03-20 ...I forgot to commit for a while
    [20170310_Plates_GearHoles_Final.dxf, R21_Core.kicad_pcb]
2017-03-20 added motor positions
2017-03-20 added servomotor value descriptions
2017-04-04 Adding latency tests + serial work
    [R21_Core.kicad_pcb, R21_Core.sch, R21_Core2.sch, R21_Core_BOM.xlsx]
